codyhylau/Integrated-Design-Project/IDP CADS FINAL/Ball Castor/ball castor.SLDASM

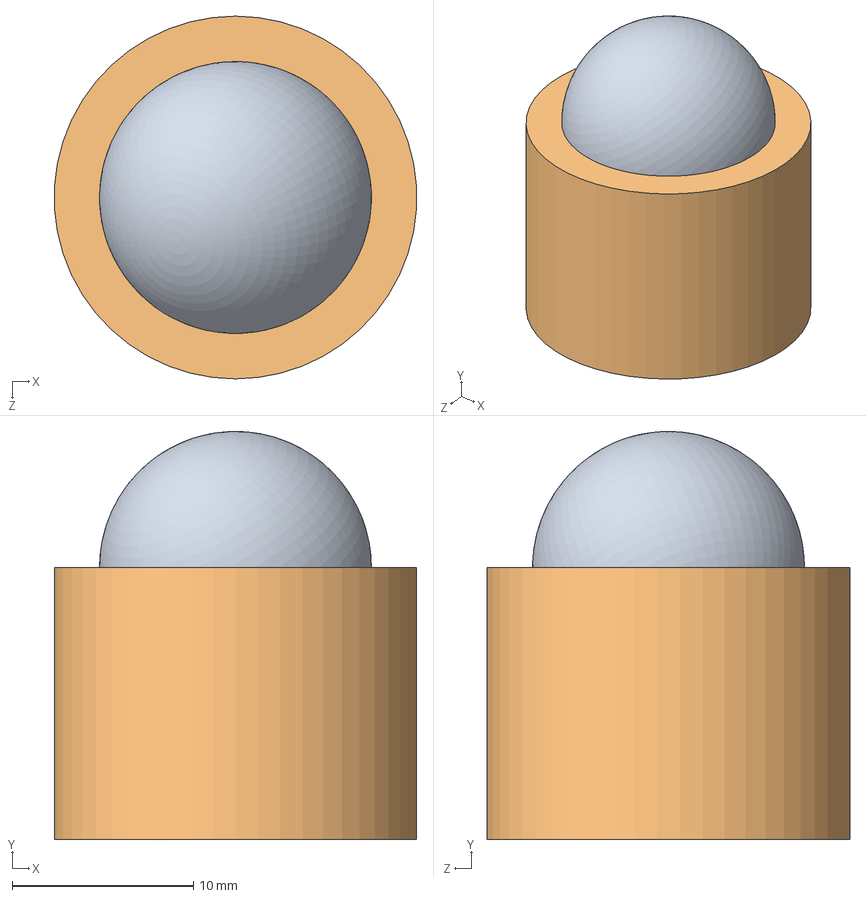
[picture p1: CAD file, 2022-01-01]
IDP CADS FINAL/Ball Castor/ball castor.SLDASM
20.0 x 22.5 x 20.0 mm
ball
ball castor
