codyhylau/Integrated-Design-Project/IDP CADS FINAL/Servo/Servo Assembly.SLDASM

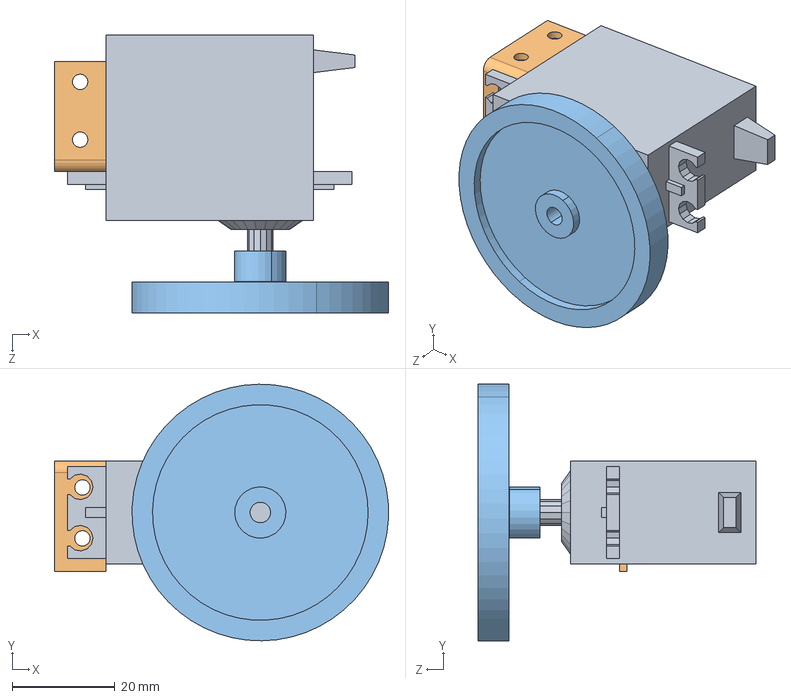
[picture p2: CAD file, 2022-01-01]
IDP CADS FINAL/Servo/Servo Assembly.SLDASM
65.1 x 50.0 x 54.1 mm
Servo
Servo Mount
spur_gear_50
