codyhylau/Integrated-Design-Project/IDP CADS FINAL/wall and ramp/wall assembly right.SLDASM

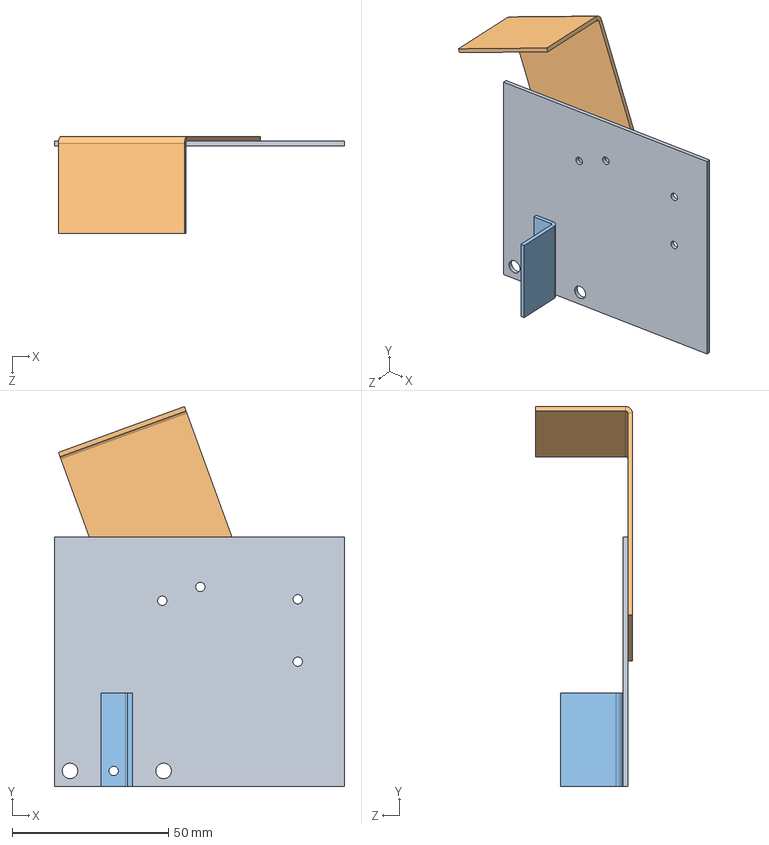
[picture p3: CAD file, 2022-01-01]
IDP CADS FINAL/wall and ramp/wall assembly right.SLDASM
93.0 x 121.8 x 31.1 mm
wall
wall L plate
divider
