codyhylau/Integrated-Design-Project/Models/bearing_625.SLDASM

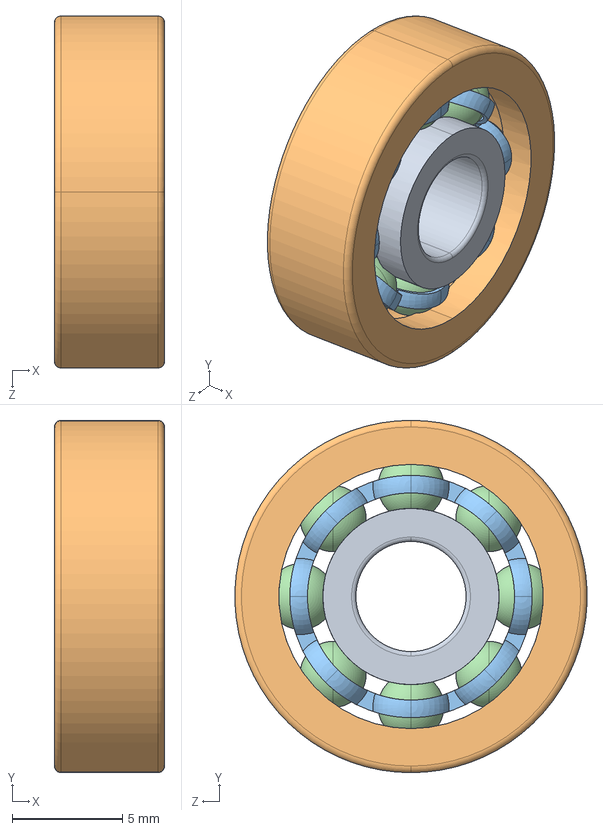
[picture p4: CAD file, 2022-01-01]
Models/bearing_625.SLDASM
5.00 x 16.0 x 16.0 mm
inner_625.prt
outer_625.prt
cage_for_625.prt
ball3.prt x 8
