codyhylau/Integrated-Design-Project/Models/FINAL/100mm_wheel.SLDASM

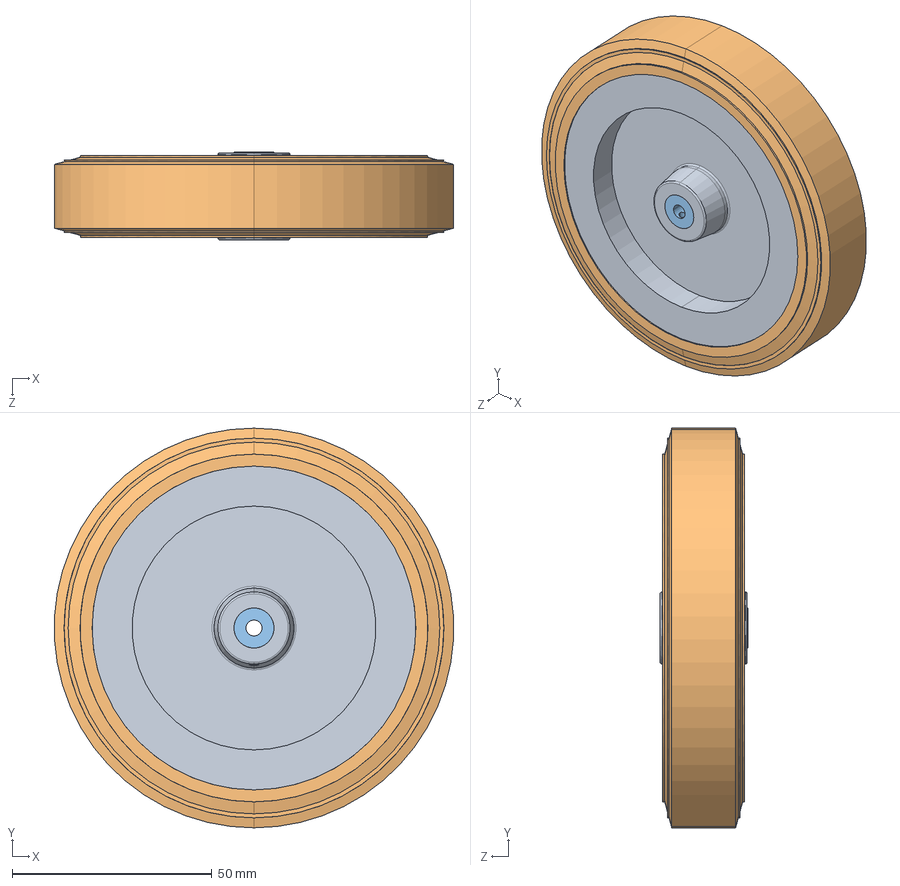
[picture p5: CAD file, 2022-01-01]
Models/FINAL/100mm_wheel.SLDASM
99.8 x 100.0 x 22.0 mm
wheel_back_in.prt
wheel_back_out.prt
sleeve.prt
