codyhylau/Integrated-Design-Project/IDP CADS FINAL/Curve/Curve Assembly.SLDASM

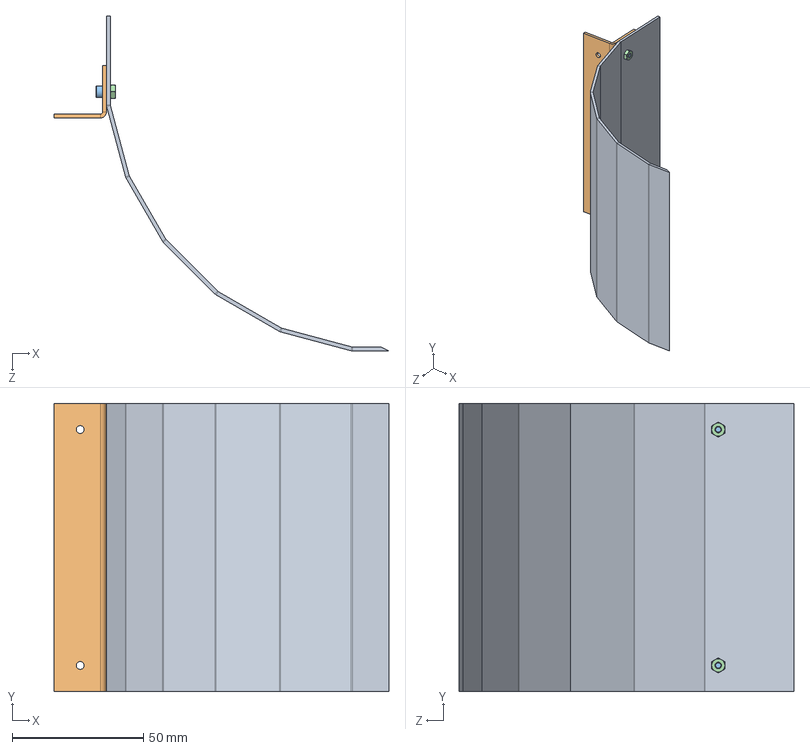
[picture p6: CAD file, 2022-01-01]
IDP CADS FINAL/Curve/Curve Assembly.SLDASM
127.8 x 110.0 x 127.8 mm
Curve
Curve L
socket head cap screw_am x 2
hex nut style 1_am x 2
