codyhylau/Integrated-Design-Project/IDP CADS FINAL/Ultrasonic Sensor/HC-SR04 Ping Sensor.SLDASM

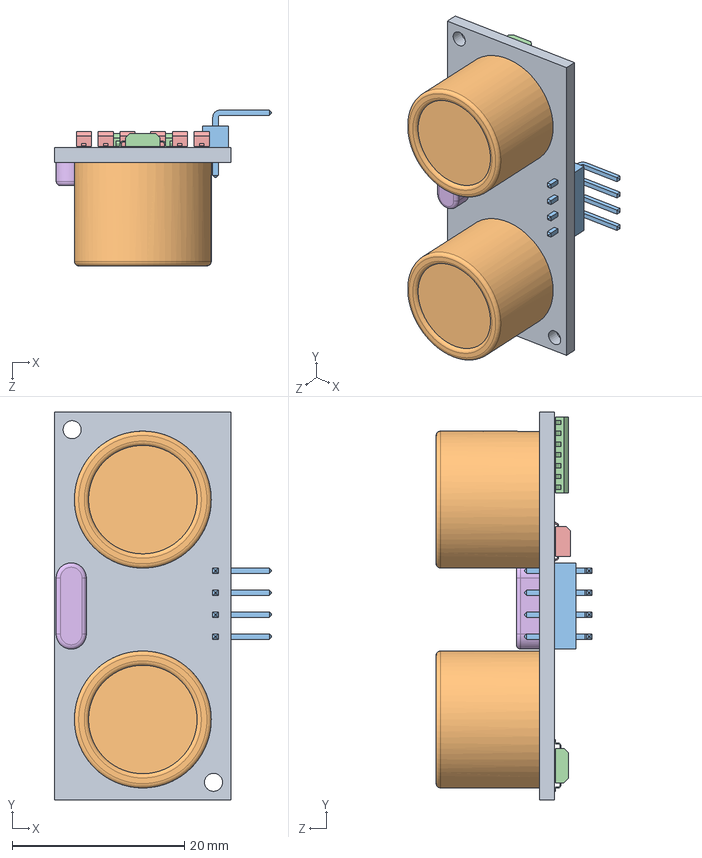
[picture p7: CAD file, 2022-01-01]
IDP CADS FINAL/Ultrasonic Sensor/HC-SR04 Ping Sensor.SLDASM
25.2 x 45.0 x 18.1 mm
PCB
Transducer x 2
3 Pin Header 90 Degree
14 Pin SMT x 3
Cap1 SMT x 6
HC-SR04 Crystal.SLDASM
