codyhylau/Integrated-Design-Project/Models/Sideways/Assembly Chasis.SLDASM

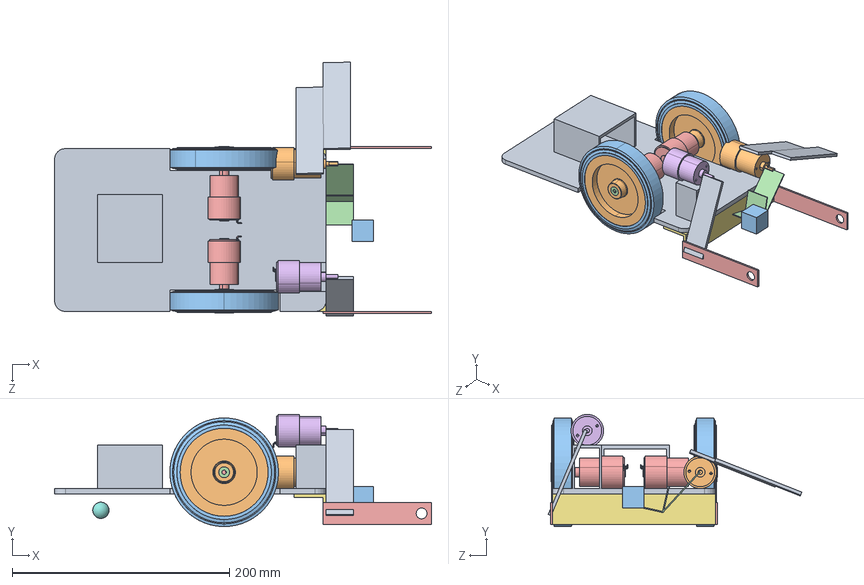
[picture p8: CAD file, 2022-01-01]
Models/Sideways/Assembly Chasis.SLDASM
347.0 x 103.2 x 233.5 mm
chasis
wheel_back_in.prt x 2
wheel_back_out.prt x 2
sleeve.prt x 2
new-motor-40 x 2
new-motor-20
front plate
ball
minesweeper x 3
new-motor-10
mine
blade
infrared wall x 2
