codyhylau/Integrated-Design-Project/IDP CADS FINAL/Arm/arm main plate.SLDPRT

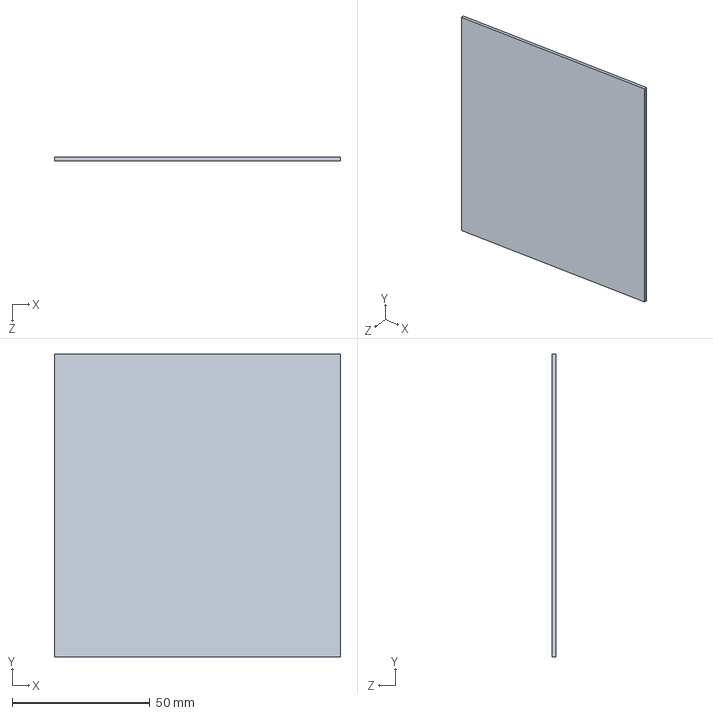
[picture p9: CAD file, 2022-01-01]
IDP CADS FINAL/Arm/arm main plate.SLDPRT
104.0 x 110.0 x 1.50 mm
