codyhylau/Integrated-Design-Project/IDP CADS FINAL/Ultrasonic Sensor Mount Side/Ultronic Sensor Side Assembly.SLDASM

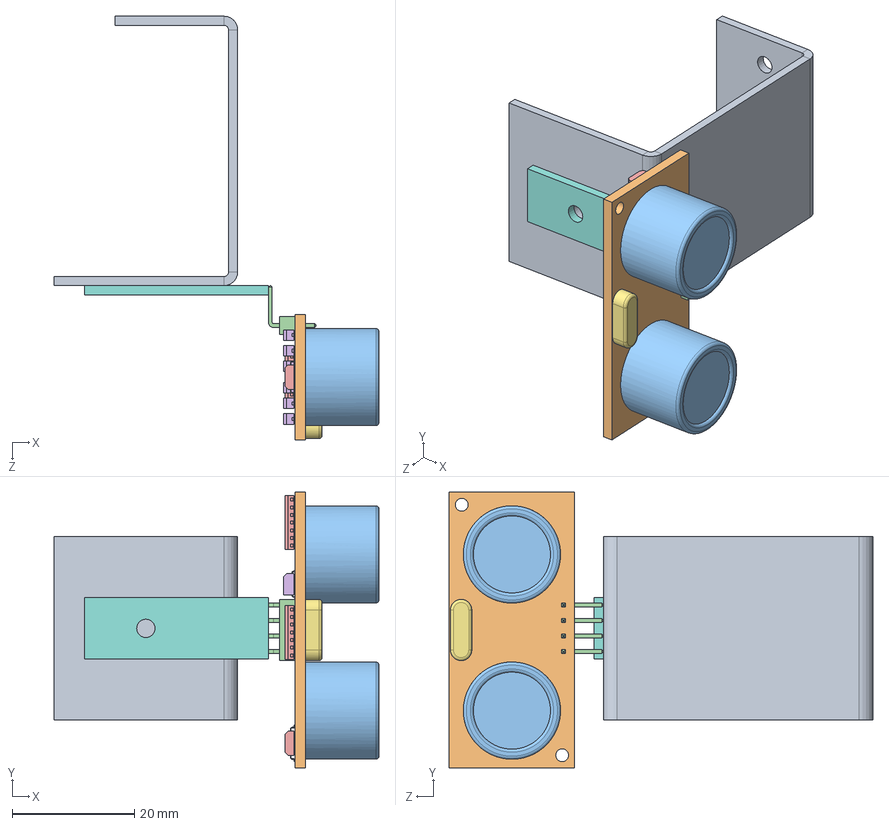
[picture p10: CAD file, 2022-01-01]
IDP CADS FINAL/Ultrasonic Sensor Mount Side/Ultronic Sensor Side Assembly.SLDASM
53.1 x 45.0 x 69.2 mm
Ultrasonic Sensor Mount Side
PCB
Transducer x 2
3 Pin Header 90 Degree
14 Pin SMT x 3
Cap1 SMT x 6
HC-SR04 Crystal.SLDASM
US connecting board
