codyhylau/Integrated-Design-Project/Models/castor.SLDASM

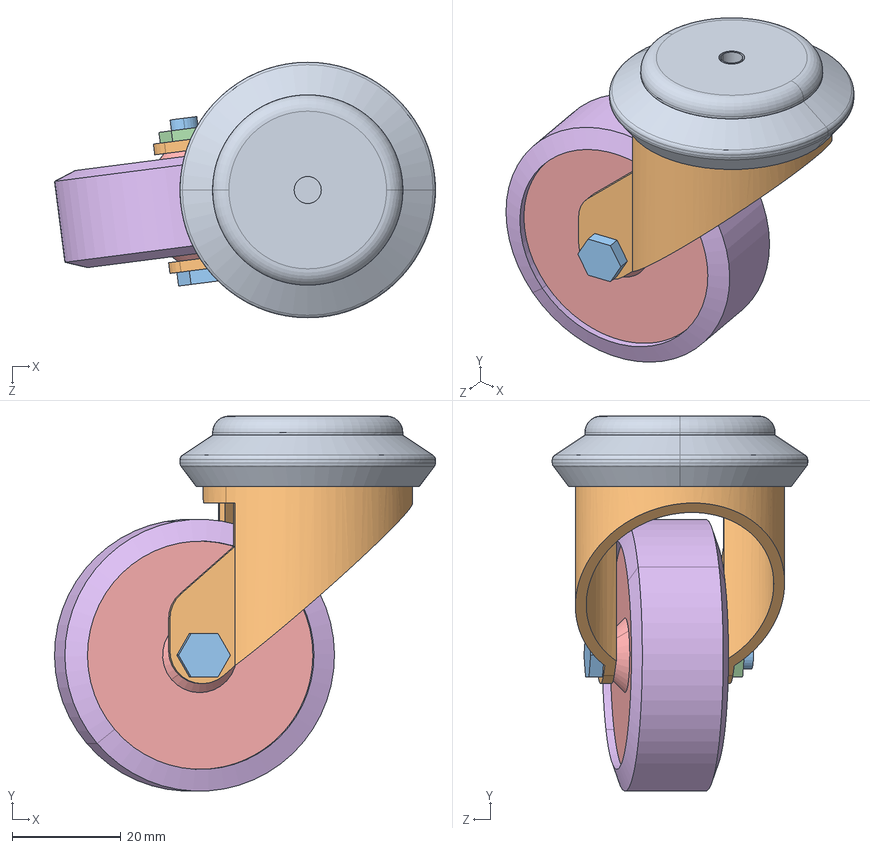
[picture p11: CAD file, 2022-01-01]
Models/castor.SLDASM
70.1 x 69.0 x 47.0 mm
wheel_top.prt
wheel_body.prt
wheel_bolt.prt
wheel_nut1.prt
wheel_in.prt
cast_in.prt
