codyhylau/Integrated-Design-Project/Models/Forward/Chassis forward.SLDASM

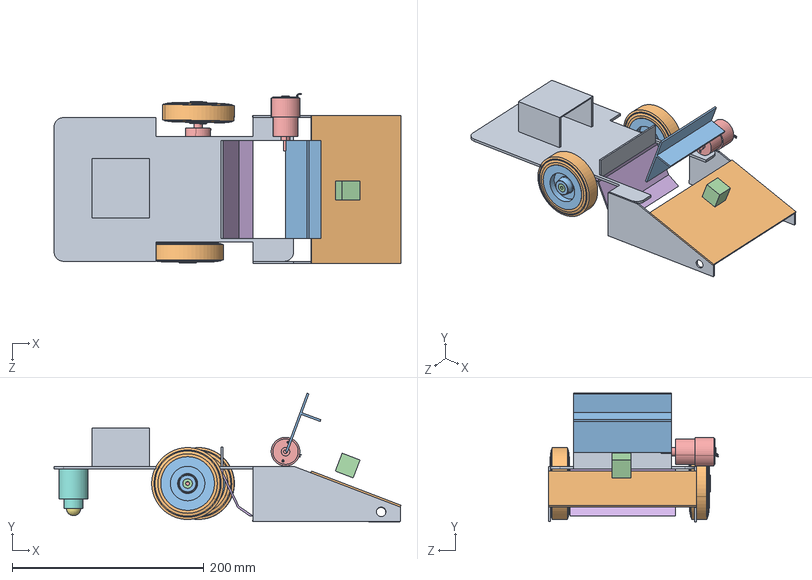
[picture p12: CAD file, 2022-01-01]
Models/Forward/Chassis forward.SLDASM
361.8 x 134.2 x 176.9 mm
chasis - Copy
wheel_75_tyre.prt x 2
wheel_75_inner.prt x 2
sleeve.prt x 2
new-motor-40 x 3
front plate 2
ball
ball castor
side plate x 2
infrared wall 2
blade 2
mine
