codyhylau/Integrated-Design-Project/IDP CADS FINAL/Ultrasonic Sensor Mount Back/Ultrasonic Sensor Mount Back Assembly.SLDASM

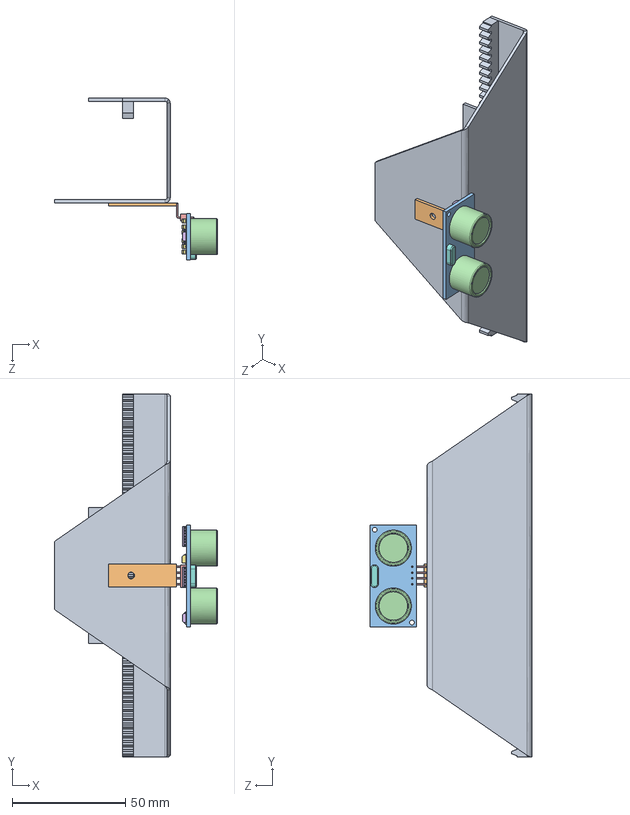
[picture p13: CAD file, 2022-01-01]
IDP CADS FINAL/Ultrasonic Sensor Mount Back/Ultrasonic Sensor Mount Back Assembly.SLDASM
71.9 x 160.0 x 71.3 mm
Ultrasonic Sensor Mount Back
US connecting board
PCB
Transducer x 2
3 Pin Header 90 Degree
14 Pin SMT x 3
Cap1 SMT x 6
HC-SR04 Crystal.SLDASM
Gear Rack
