codyhylau/Integrated-Design-Project/Models/new-drive-assy-75.SLDASM

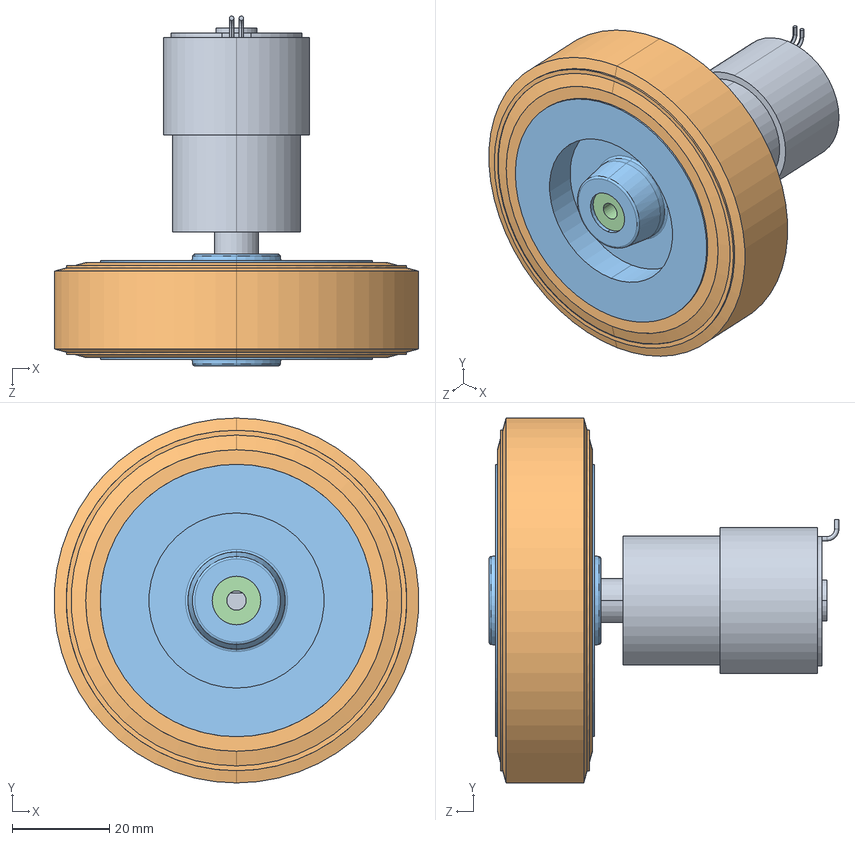
[picture p14: CAD file, 2022-01-01]
Models/new-drive-assy-75.SLDASM
74.9 x 75.0 x 71.9 mm
new-motor-20.prt
wheel_75_tyre.prt
wheel_75_inner.prt
sleeve.prt
