codyhylau/Integrated-Design-Project/IDP CADS FINAL/Arm/arm assembly.SLDASM

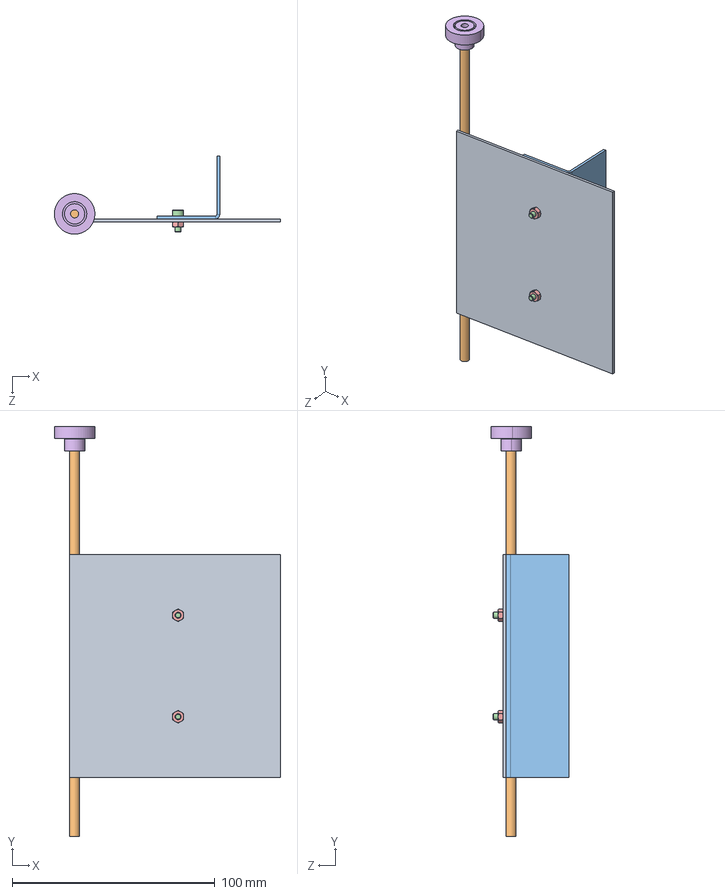
[picture p15: CAD file, 2022-01-01]
IDP CADS FINAL/Arm/arm assembly.SLDASM
111.5 x 202.0 x 38.6 mm
arm main plate
arm axle
arm L plate
socket head cap screw_am x 2
hex nut style 1_am x 2
spur_gear_20
