codyhylau/Integrated-Design-Project/IDP CADS FINAL/Ultrasonic Sensor/HC-SR04 Crystal.SLDASM.SLDPRT

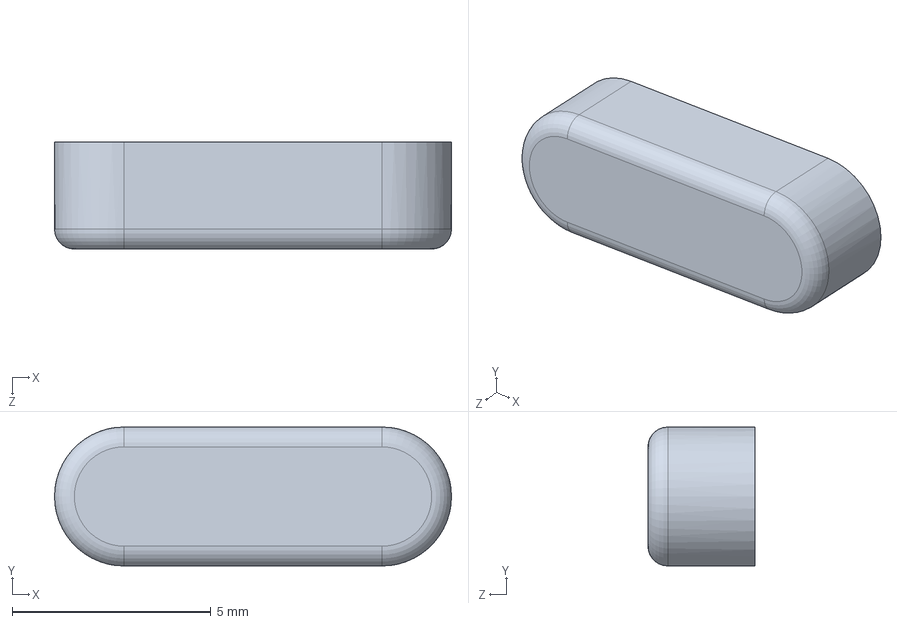
[picture p16: CAD file, 2022-01-01]
IDP CADS FINAL/Ultrasonic Sensor/HC-SR04 Crystal.SLDASM.SLDPRT
10.0 x 3.50 x 2.70 mm
