codyhylau/Integrated-Design-Project/Models/Forward/ball castor 2.SLDASM

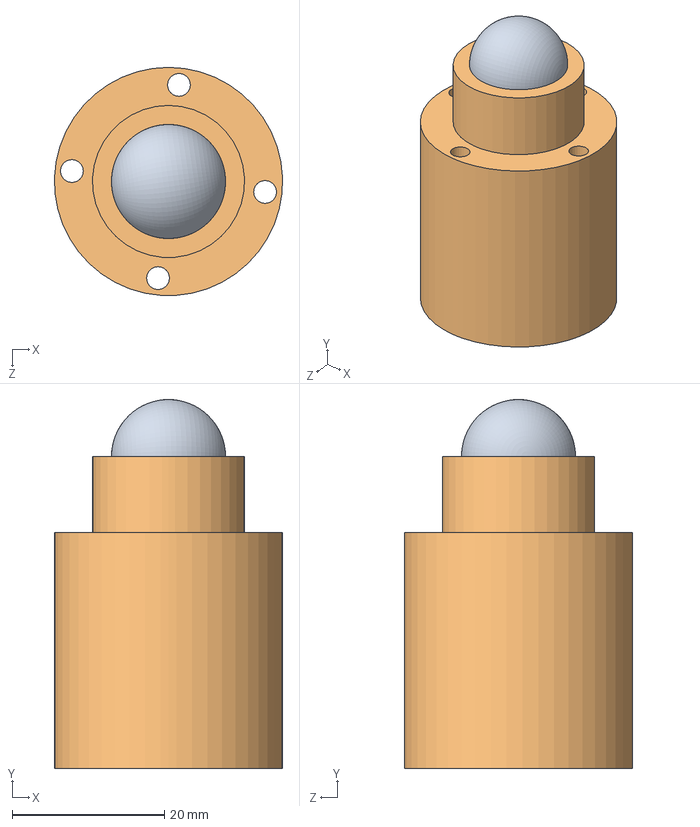
[picture p17: CAD file, 2022-01-01]
Models/Forward/ball castor 2.SLDASM
30.0 x 48.5 x 30.0 mm
ball
ball castor
