codyhylau/Integrated-Design-Project/Models/Sideways/ball castor.SLDASM

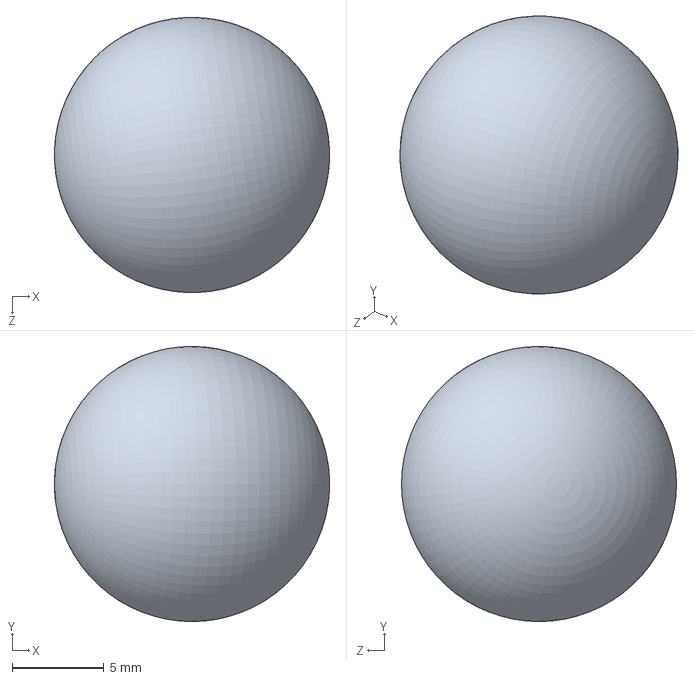
[picture p18: CAD file, 2022-01-01]
Models/Sideways/ball castor.SLDASM
15.0 x 15.0 x 15.0 mm
