codyhylau/Integrated-Design-Project/IDP CADS FINAL/OVERALL ASSEMBLY.SLDASM

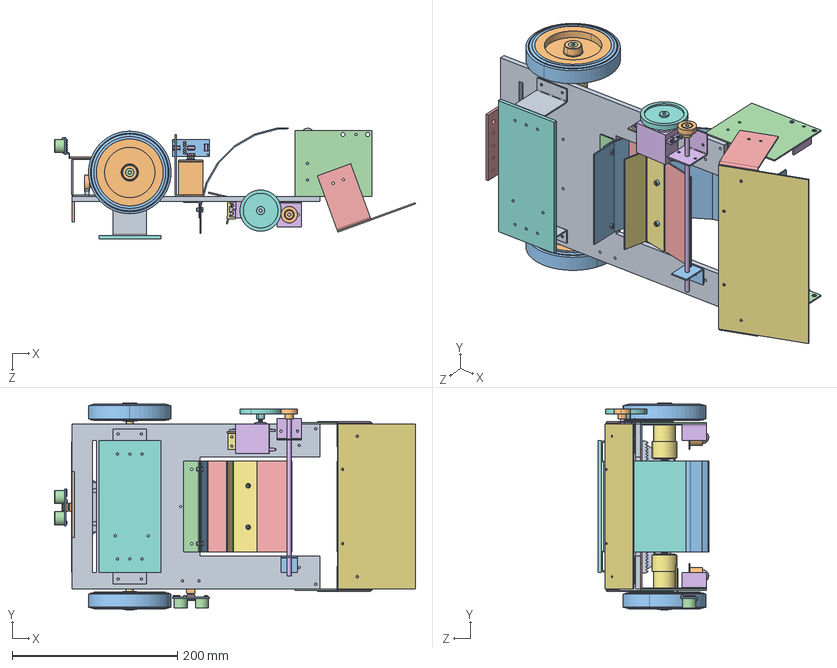
[picture p19: CAD file, 2022-01-01]
IDP CADS FINAL/OVERALL ASSEMBLY.SLDASM
436.9 x 250.0 x 134.4 mm
Chassis Main
Ball Castor Mount Left
Ball Castor Mount Right
Line Follower mount
Motor Mount Large x 2
Motor Mount Small x 2
Motor-40 x 2
shelf laser cut
Shelf mount x 2
wheel_back_in.prt x 2
wheel_back_out.prt x 2
sleeve.prt x 2
arm main plate
arm axle
arm L plate
socket head cap screw_am x 4
hex nut style 1_am x 4
spur_gear_20 x 2
Curve
Curve L
LED Panel
Servo
Servo Mount
spur_gear_50
Ultrasonic Sensor Mount Back
US connecting board x 2
PCB x 2
Transducer x 4
3 Pin Header 90 Degree x 2
14 Pin SMT x 6
Cap1 SMT x 12
HC-SR04 Crystal.SLDASM x 2
Gear Rack
Ultrasonic Sensor Mount Side
Arm rod support
wall x 2
wall L plate x 2
divider x 2
ramp
Hall Sensor Mount
ball x 2
ball castor x 2
Motor-10
