codyhylau/Integrated-Design-Project/Models/bearing_623.SLDASM

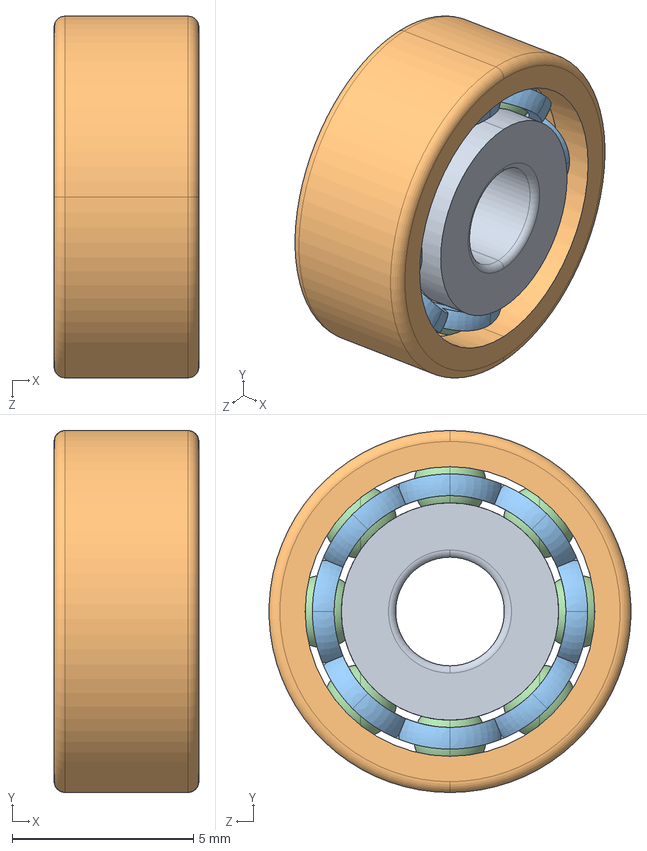
[picture p20: CAD file, 2022-01-01]
Models/bearing_623.SLDASM
4.00 x 10.0 x 9.99 mm
inner_623.prt
outer_623.prt
cage_for_623.prt
ball2.prt x 8
