codyhylau/Integrated-Design-Project/IDP CADS FINAL/Chassis Main.SLDPRT

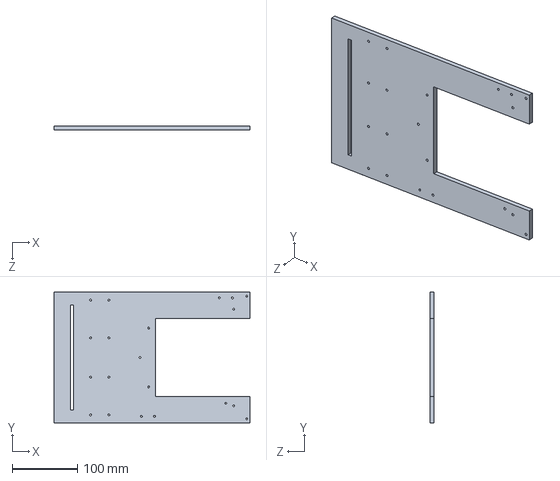
[picture p21: CAD file, 2022-01-01]
IDP CADS FINAL/Chassis Main.SLDPRT
300.0 x 200.0 x 6.00 mm
