codyhylau/Integrated-Design-Project/Models/mitre_pair_20t.asm.SLDASM

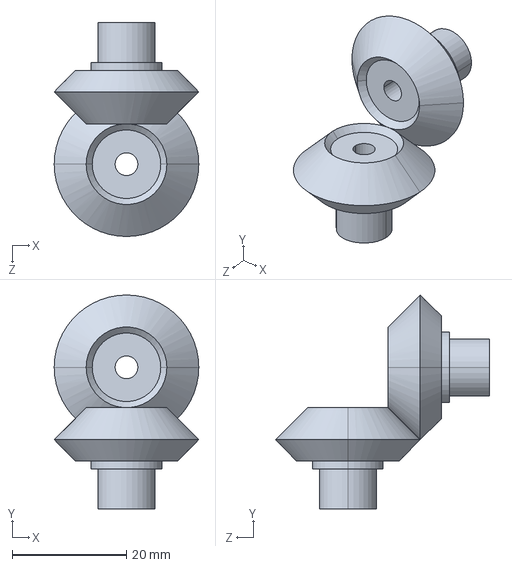
[picture p22: CAD file, 2022-01-01]
Models/mitre_pair_20t.asm.SLDASM
25.3 x 37.5 x 37.5 mm
mitre_m1_20t.prt x 2
