codyhylau/Integrated-Design-Project/Models/624-flanged.SLDASM

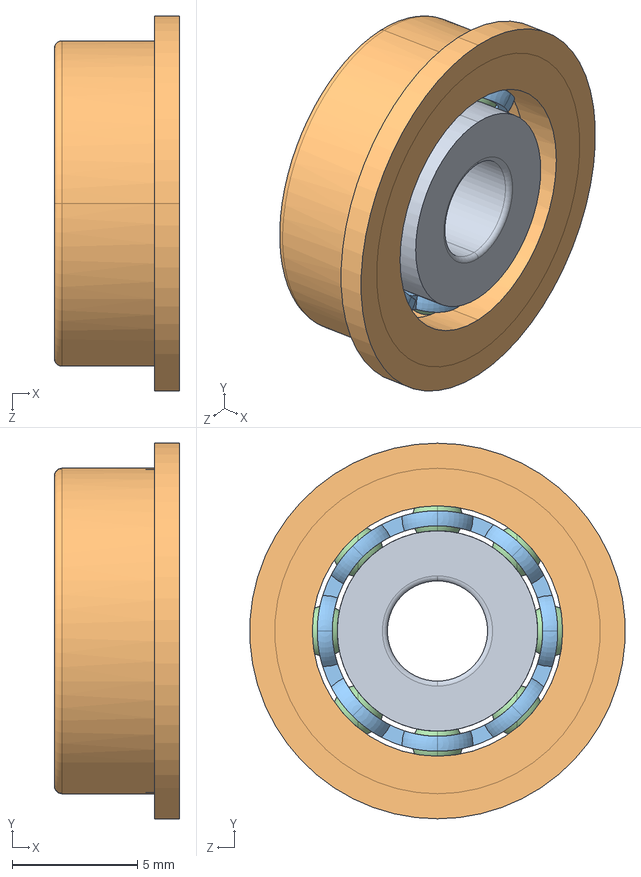
[picture p23: CAD file, 2022-01-01]
Models/624-flanged.SLDASM
5.00 x 15.0 x 15.0 mm
inner_624.prt
flanged-outer-624.prt
cage_for_624.prt
ball2.prt x 8
