codyhylau/Integrated-Design-Project/Models/75mm_wheel.SLDASM

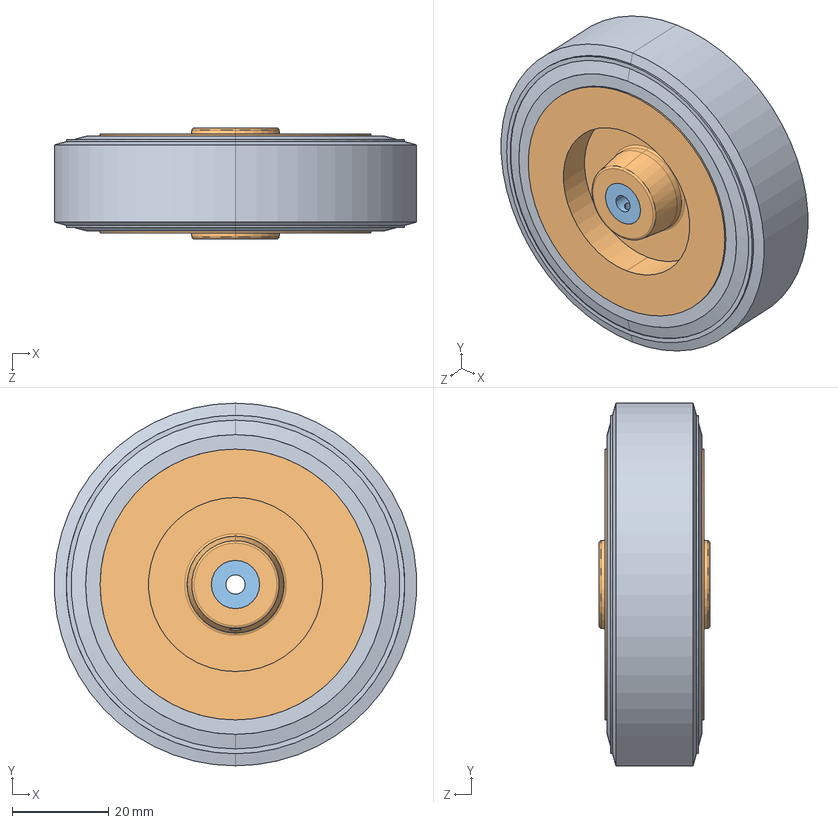
[picture p24: CAD file, 2022-01-01]
Models/75mm_wheel.SLDASM
74.9 x 75.0 x 23.0 mm
wheel_75_tyre.prt
wheel_75_inner.prt
sleeve.prt
