codyhylau/Integrated-Design-Project/Models/623-flanged.SLDASM

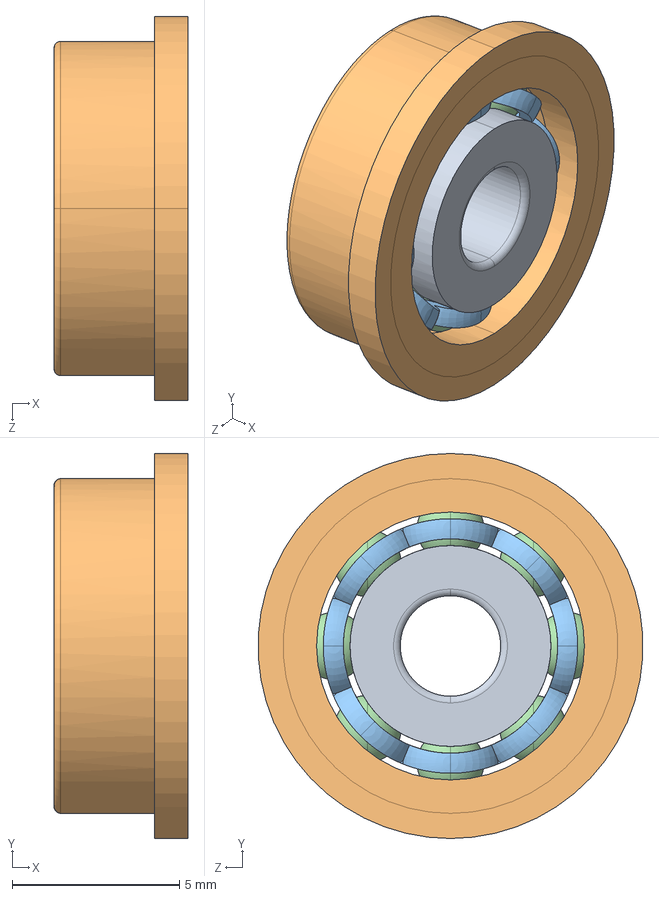
[picture p25: CAD file, 2022-01-01]
Models/623-flanged.SLDASM
4.00 x 11.5 x 11.5 mm
inner_623.prt
flanged-outer-623.prt
cage_for_623.prt
ball2.prt x 8
