codyhylau/Integrated-Design-Project/Models/625-flanged.SLDASM

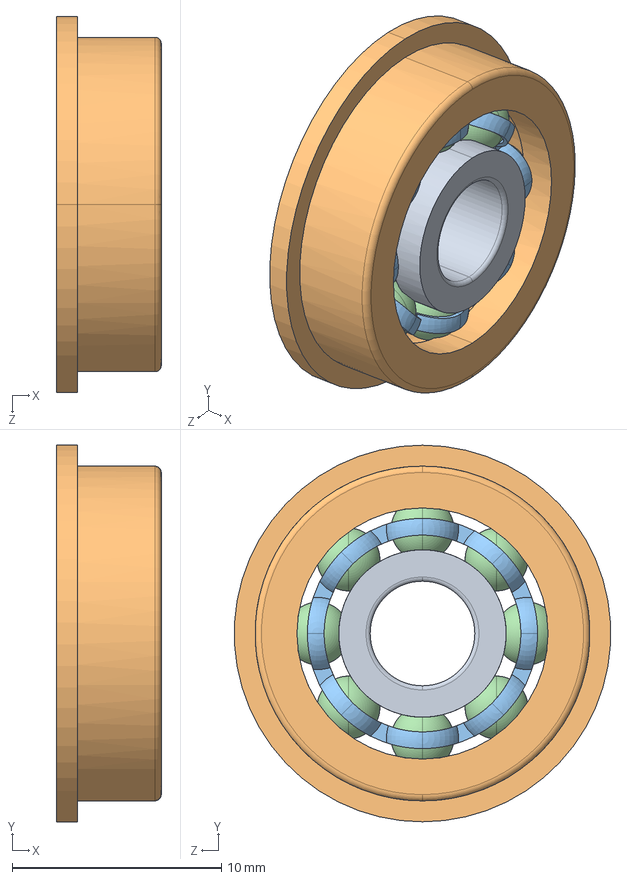
[picture p26: CAD file, 2022-01-01]
Models/625-flanged.SLDASM
5.00 x 18.0 x 18.0 mm
inner_625.prt
flanged-outer-625.prt
cage_for_625.prt
ball3.prt x 8
