codyhylau/Integrated-Design-Project/Models/bearing_624.SLDASM

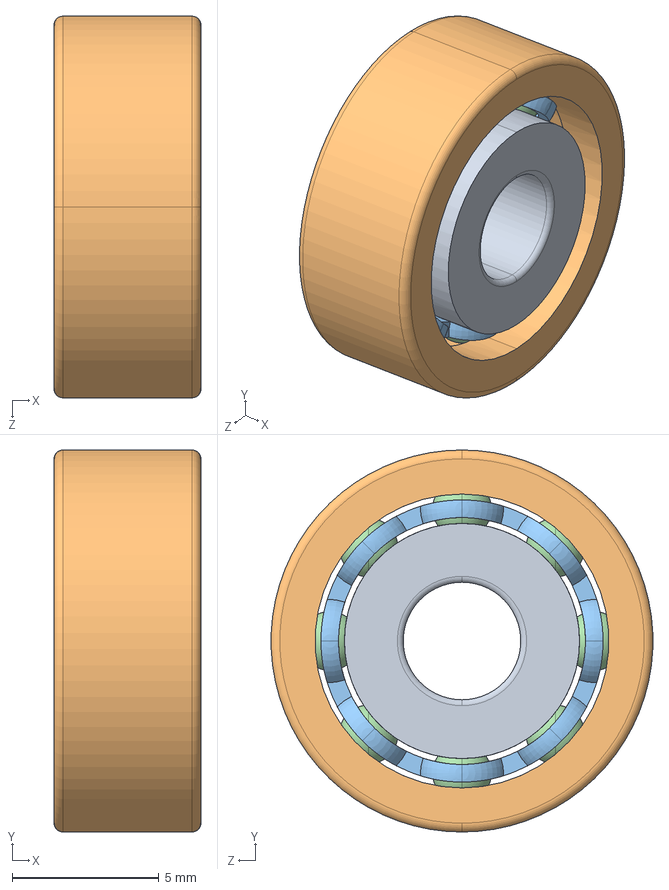
[picture p27: CAD file, 2022-01-01]
Models/bearing_624.SLDASM
5.00 x 13.0 x 13.0 mm
inner_624.prt
outer_624.prt
cage_for_624.prt
ball2.prt x 8
