codyhylau/Integrated-Design-Project/IDP CADS FINAL/Arm/Arm rod support.SLDPRT

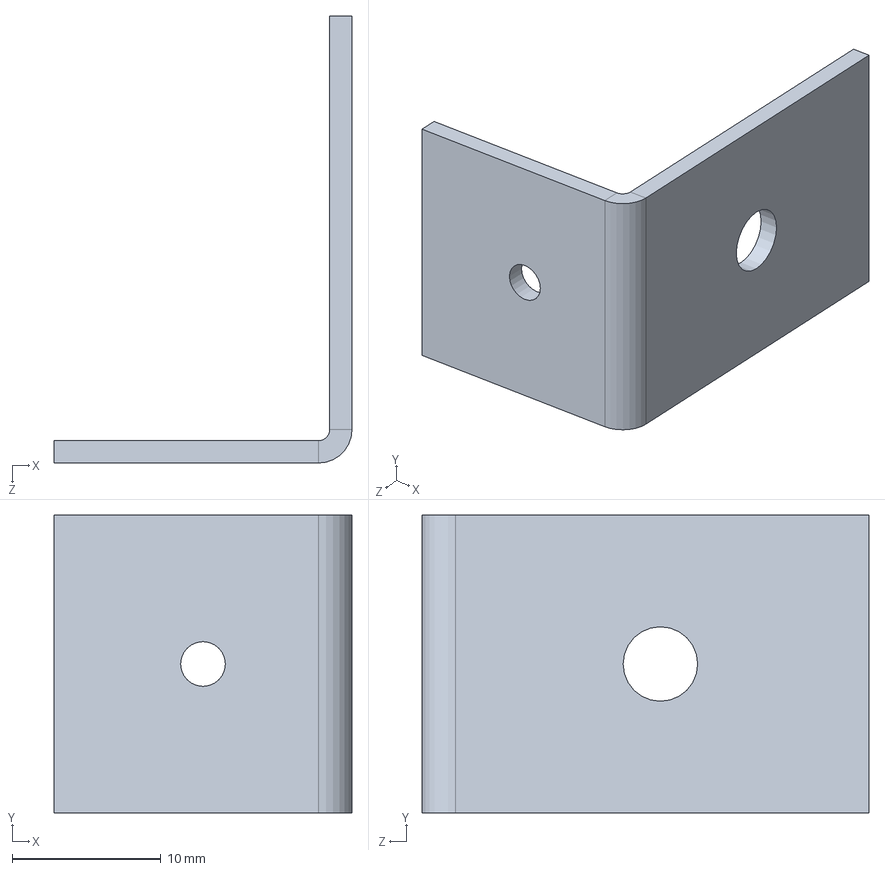
[picture p28: CAD file, 2022-01-01]
IDP CADS FINAL/Arm/Arm rod support.SLDPRT
20.0 x 20.0 x 30.0 mm
