codyhylau/Integrated-Design-Project/IDP CADS FINAL/Curve/Curve L.SLDPRT

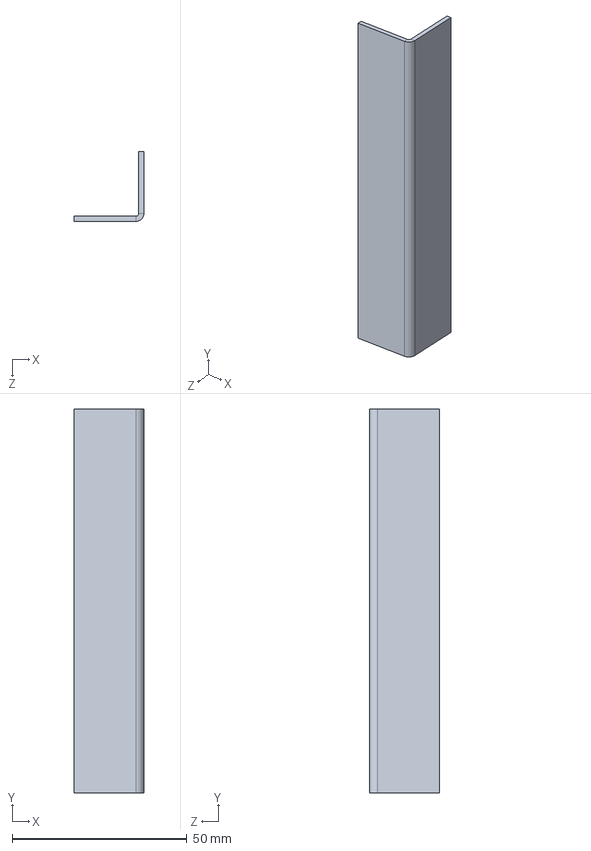
[picture p29: CAD file, 2022-01-01]
IDP CADS FINAL/Curve/Curve L.SLDPRT
20.0 x 110.0 x 20.0 mm
