codyhylau/Integrated-Design-Project/IDP CADS FINAL/Drawings temporary/Laser Cut Chassis.DXF

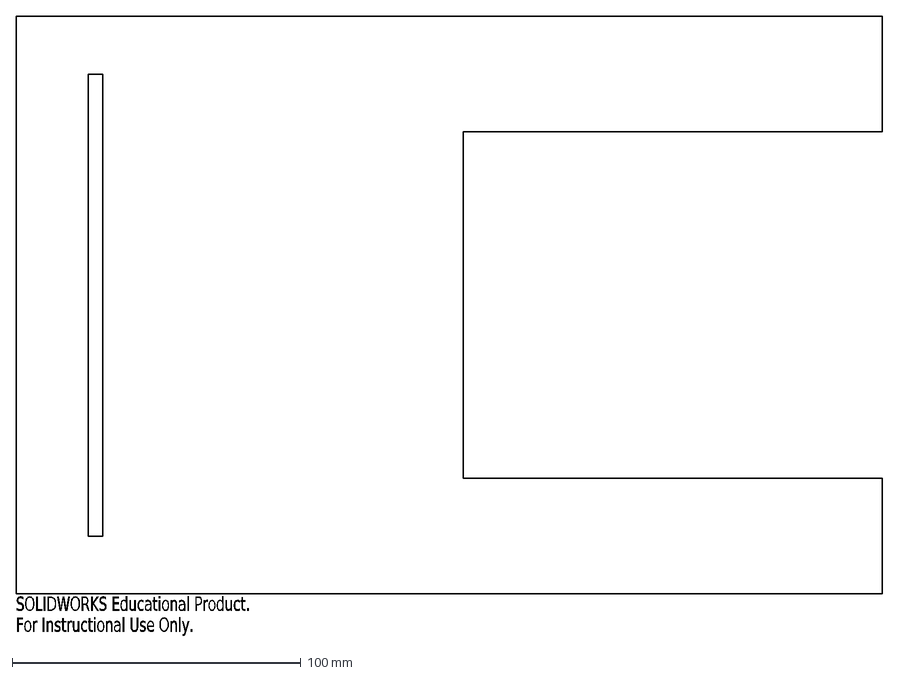
[picture p30: CAD file, 2022-01-01]
IDP CADS FINAL/Drawings temporary/Laser Cut Chassis.DXF
SOLIDWORKS Educational Product.
For Instructional Use Only.
