codyhylau/Integrated-Design-Project/IDP CADS FINAL/LED Panel/LED Panel.SLDPRT

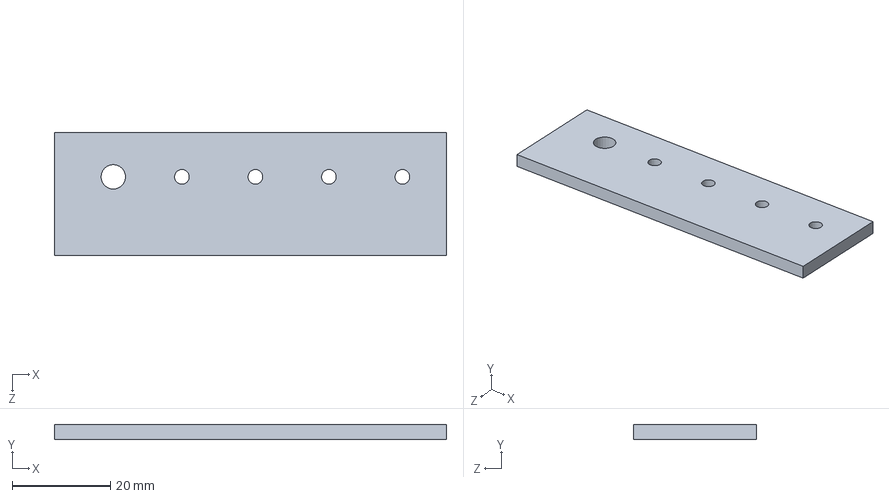
[picture p31: CAD file, 2022-01-01]
IDP CADS FINAL/LED Panel/LED Panel.SLDPRT
80.0 x 3.00 x 25.0 mm
