codyhylau/Integrated-Design-Project/IDP CADS FINAL/Motor-40.SLDPRT

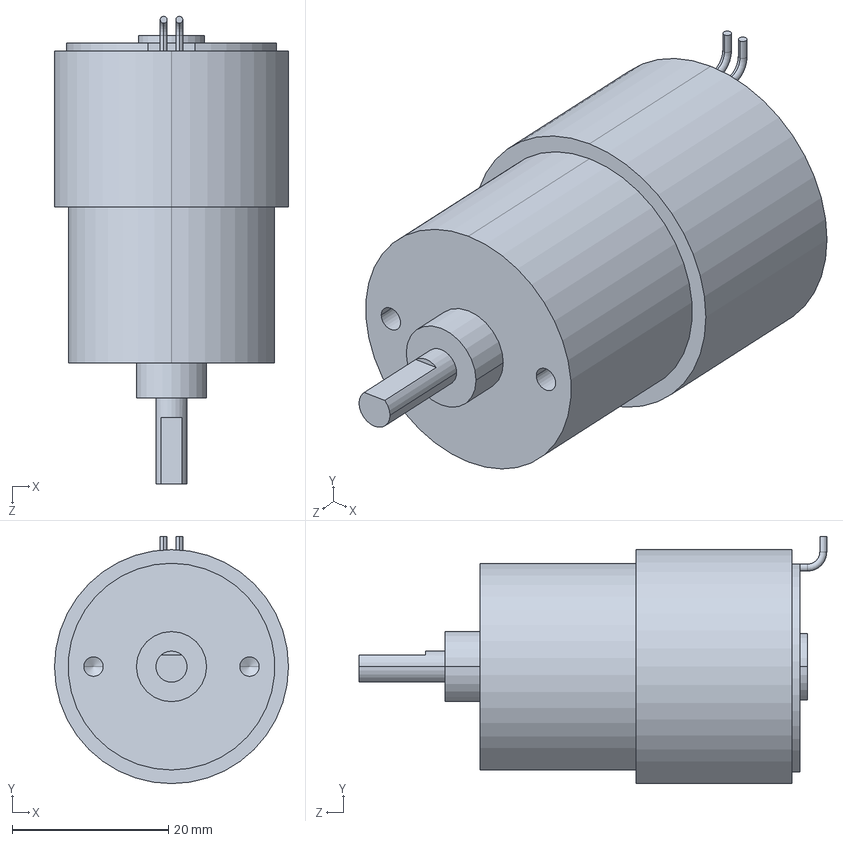
[picture p32: CAD file, 2022-01-01]
IDP CADS FINAL/Motor-40.SLDPRT
30.0 x 31.7 x 60.0 mm
