codyhylau/Integrated-Design-Project/IDP CADS FINAL/Ultrasonic Sensor Mount Back/Ultrasonic Sensor Mount Back.SLDPRT

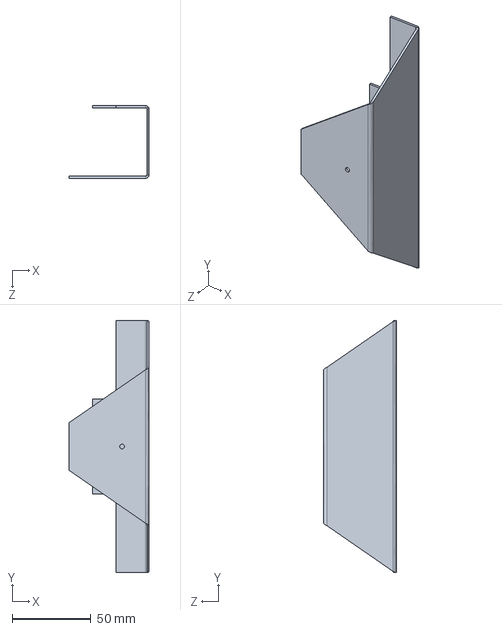
[picture p33: CAD file, 2022-01-01]
IDP CADS FINAL/Ultrasonic Sensor Mount Back/Ultrasonic Sensor Mount Back.SLDPRT
51.1 x 160.0 x 46.1 mm
