codyhylau/Integrated-Design-Project/IDP CADS FINAL/Ultrasonic Sensor Mount Side/US connecting board.SLDPRT

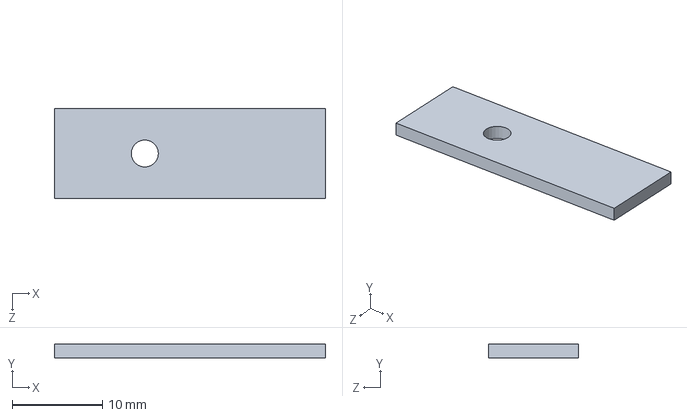
[picture p34: CAD file, 2022-01-01]
IDP CADS FINAL/Ultrasonic Sensor Mount Side/US connecting board.SLDPRT
30.0 x 1.50 x 10.0 mm
