codyhylau/Integrated-Design-Project/IDP CADS FINAL/Ultrasonic Sensor/14 Pin SMT.SLDPRT

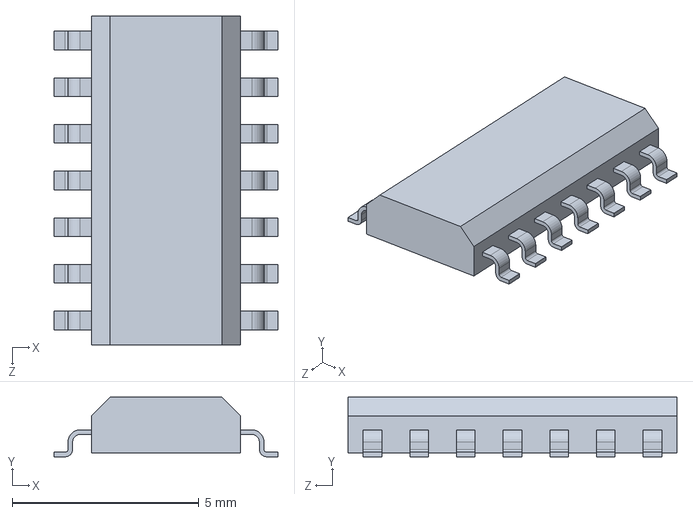
[picture p35: CAD file, 2022-01-01]
IDP CADS FINAL/Ultrasonic Sensor/14 Pin SMT.SLDPRT
6.00 x 1.60 x 8.80 mm
