codyhylau/Integrated-Design-Project/Models/Forward/infrared wall 2.SLDPRT

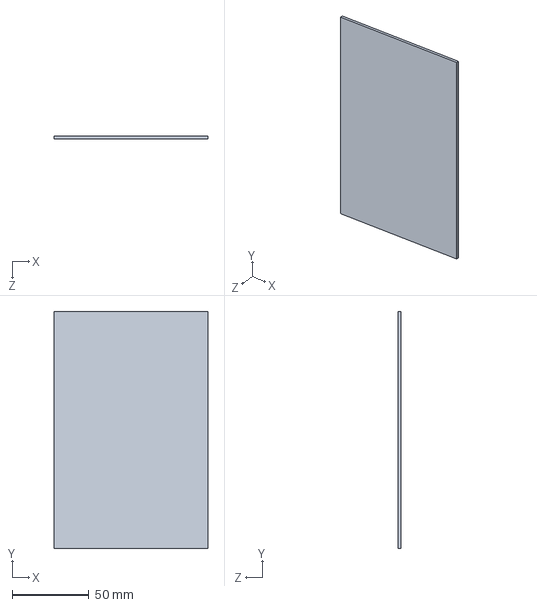
[picture p36: CAD file, 2022-01-01]
Models/Forward/infrared wall 2.SLDPRT
100.0 x 154.0 x 2.00 mm
