codyhylau/Integrated-Design-Project/Models/Sideways/front plate.SLDPRT

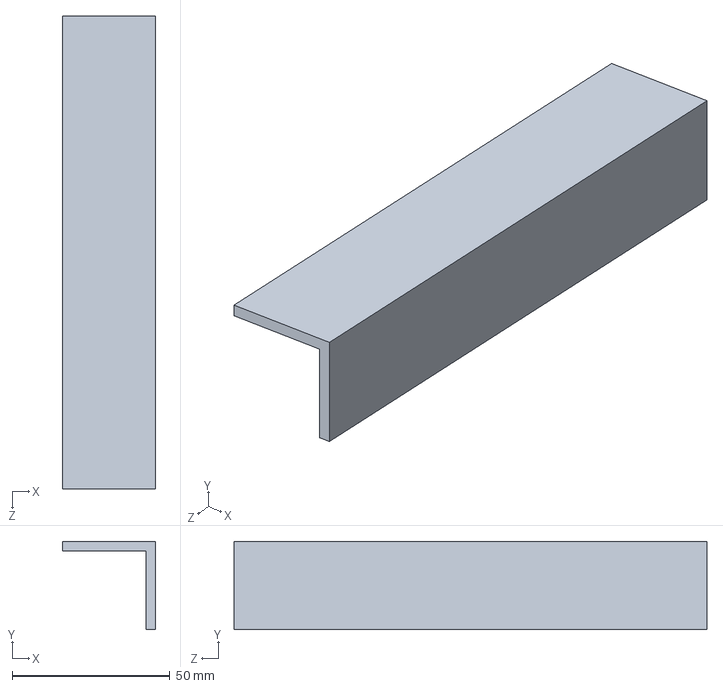
[picture p37: CAD file, 2022-01-01]
Models/Sideways/front plate.SLDPRT
29.6 x 28.0 x 150.0 mm
