codyhylau/Integrated-Design-Project/IDP CADS FINAL/Arm/spur_gear_20.SLDPRT

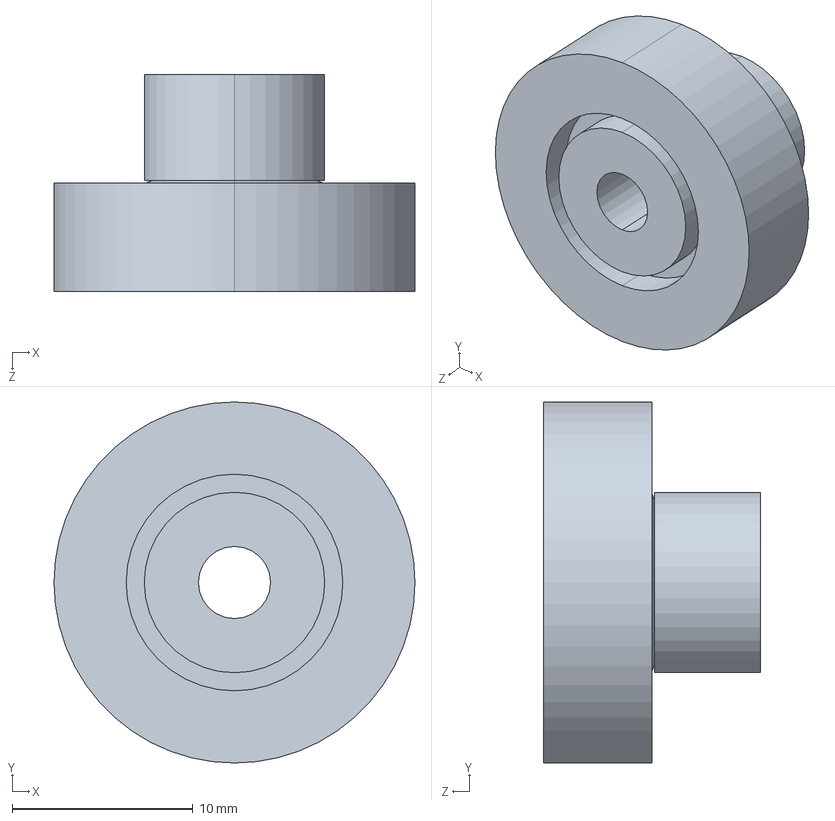
[picture p38: CAD file, 2022-01-01]
IDP CADS FINAL/Arm/spur_gear_20.SLDPRT
20.0 x 20.0 x 12.0 mm
