codyhylau/Integrated-Design-Project/IDP CADS FINAL/Servo/Servo Mount.SLDPRT

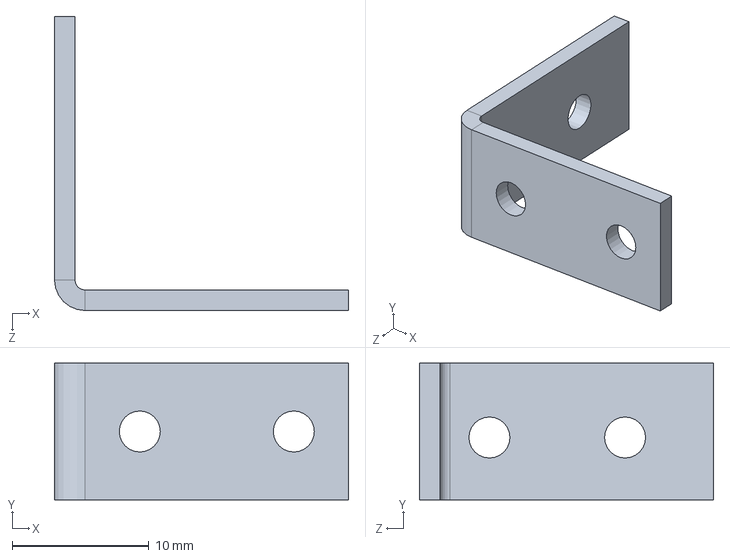
[picture p39: CAD file, 2022-01-01]
IDP CADS FINAL/Servo/Servo Mount.SLDPRT
21.5 x 10.0 x 21.5 mm
