codyhylau/Integrated-Design-Project/IDP CADS FINAL/Shelf mount.SLDPRT

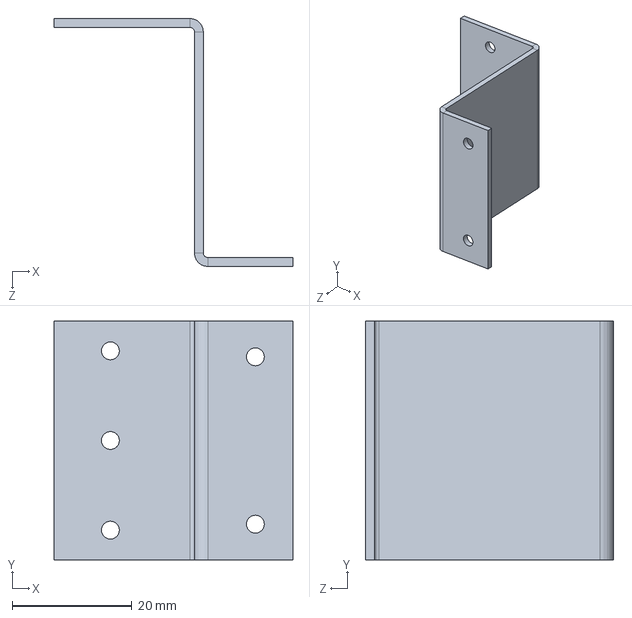
[picture p40: CAD file, 2022-01-01]
IDP CADS FINAL/Shelf mount.SLDPRT
40.0 x 40.0 x 41.5 mm
