codyhylau/Integrated-Design-Project/IDP CADS FINAL/Ultrasonic Sensor Mount Back/Gear Rack.SLDPRT

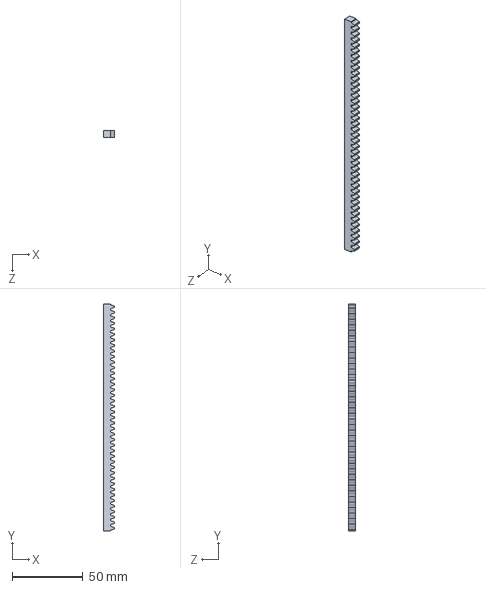
[picture p41: CAD file, 2022-01-01]
IDP CADS FINAL/Ultrasonic Sensor Mount Back/Gear Rack.SLDPRT
7.48 x 160.0 x 4.88 mm
