codyhylau/Integrated-Design-Project/IDP CADS FINAL/Ultrasonic Sensor Mount Side/Ultrasonic Sensor Mount Side.SLDPRT

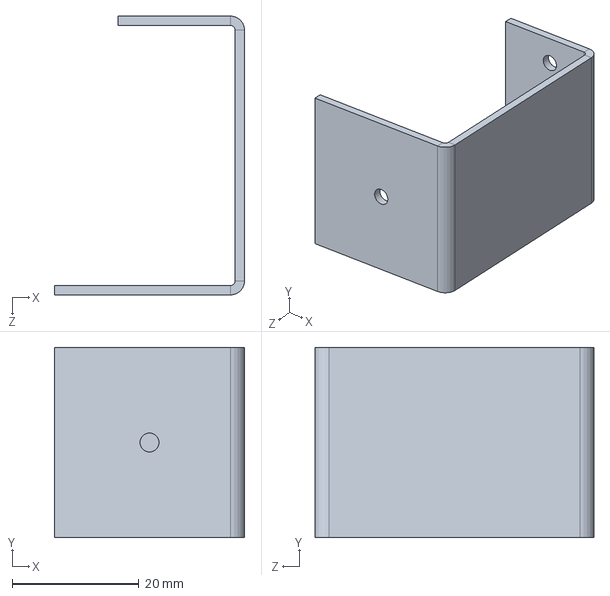
[picture p42: CAD file, 2022-01-01]
IDP CADS FINAL/Ultrasonic Sensor Mount Side/Ultrasonic Sensor Mount Side.SLDPRT
30.0 x 30.0 x 44.0 mm
