codyhylau/Integrated-Design-Project/IDP CADS FINAL/wall and ramp/wall L plate.SLDPRT

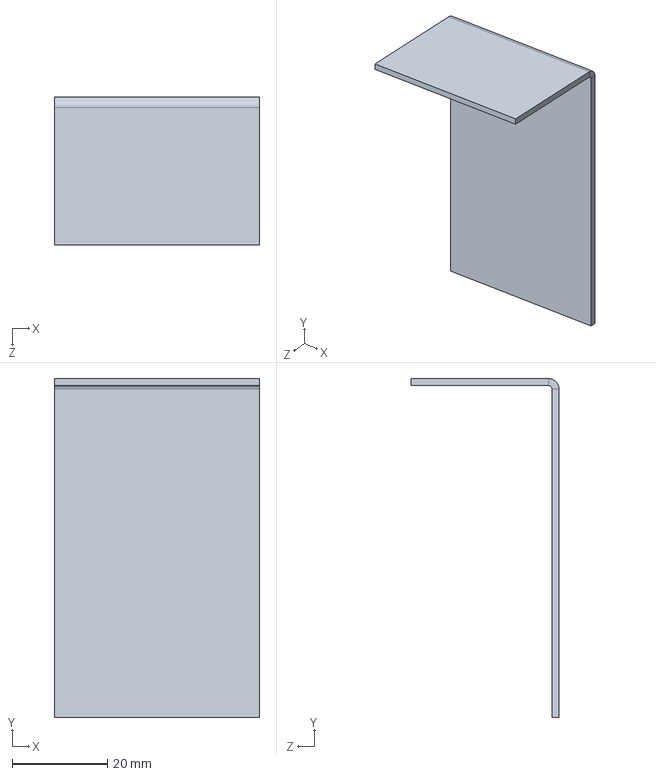
[picture p43: CAD file, 2022-01-01]
IDP CADS FINAL/wall and ramp/wall L plate.SLDPRT
43.0 x 71.1 x 31.1 mm
