codyhylau/Integrated-Design-Project/Models/FINAL/HC-SR04 Ping Sensor/Transducer.SLDPRT

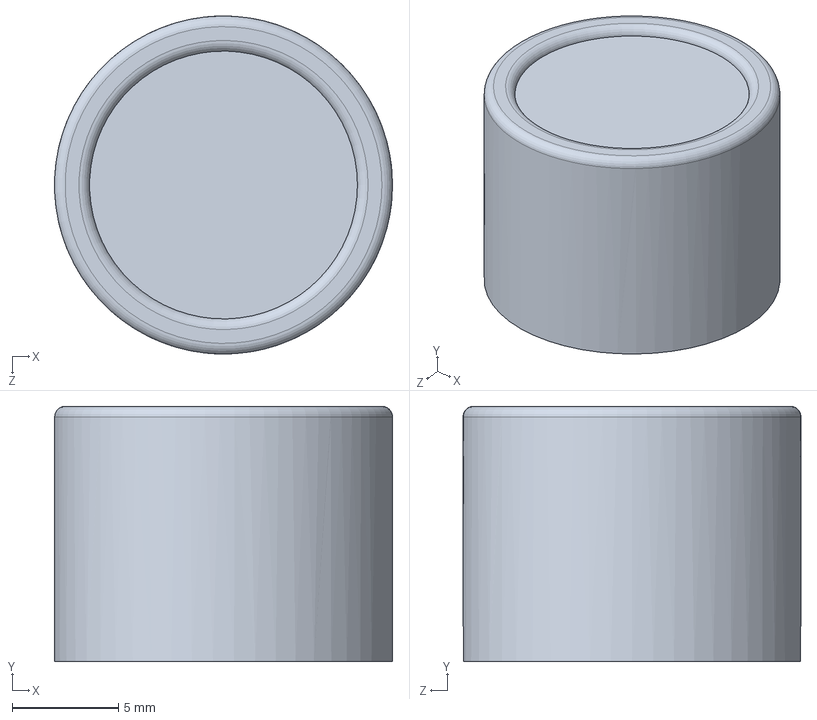
[picture p44: CAD file, 2022-01-01]
Models/FINAL/HC-SR04 Ping Sensor/Transducer.SLDPRT
15.9 x 12.0 x 15.9 mm
