codyhylau/Integrated-Design-Project/Models/FINAL/new-motor-10.SLDPRT

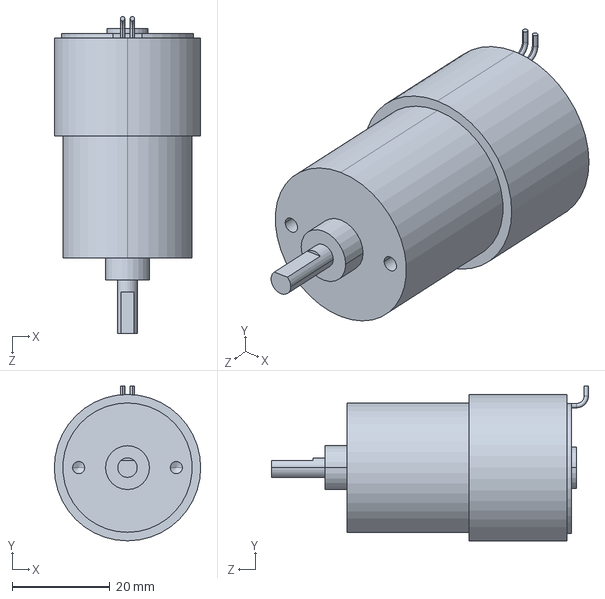
[picture p45: CAD file, 2022-01-01]
Models/FINAL/new-motor-10.SLDPRT
30.0 x 31.7 x 64.9 mm
