codyhylau/Integrated-Design-Project/Models/Forward/blade 2.SLDPRT

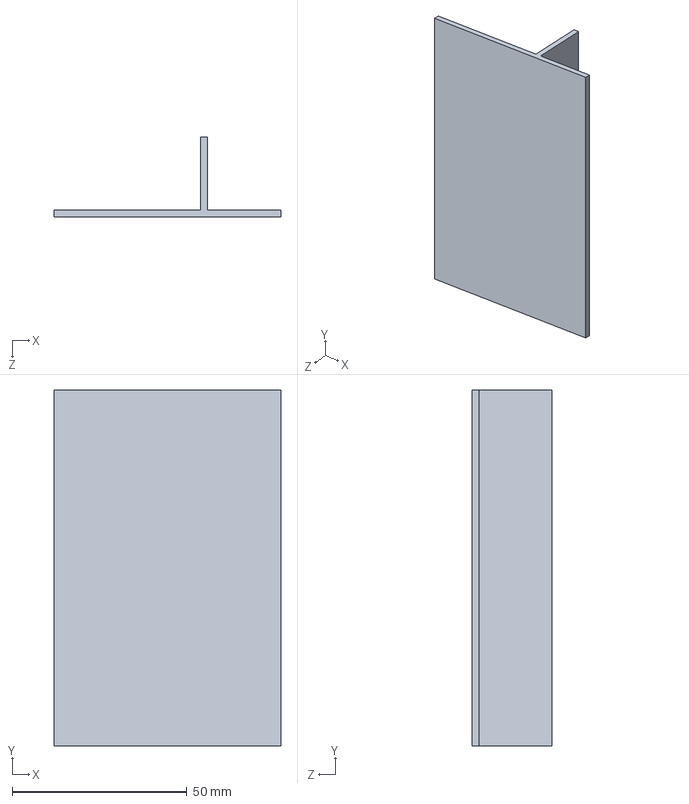
[picture p46: CAD file, 2022-01-01]
Models/Forward/blade 2.SLDPRT
65.0 x 102.0 x 23.0 mm
