codyhylau/Integrated-Design-Project/IDP CADS FINAL/Curve/Curve.SLDPRT

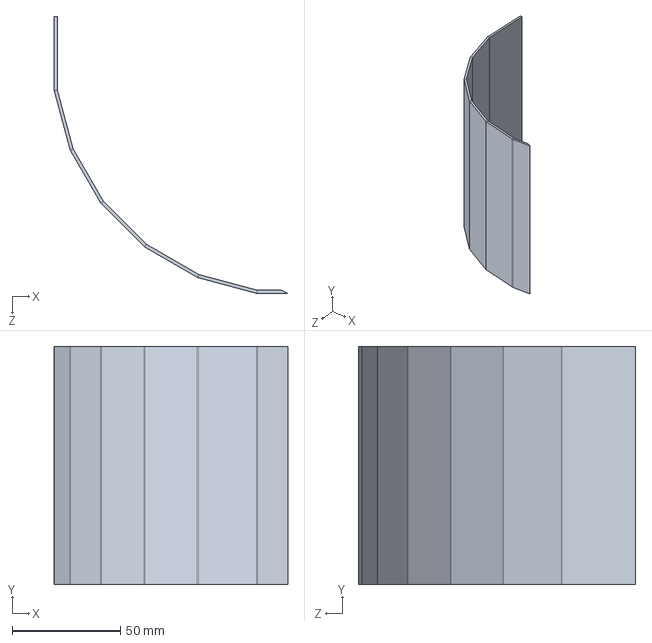
[picture p47: CAD file, 2022-01-01]
IDP CADS FINAL/Curve/Curve.SLDPRT
107.8 x 110.0 x 127.8 mm
