codyhylau/Integrated-Design-Project/IDP CADS FINAL/Servo/Servo.SLDPRT

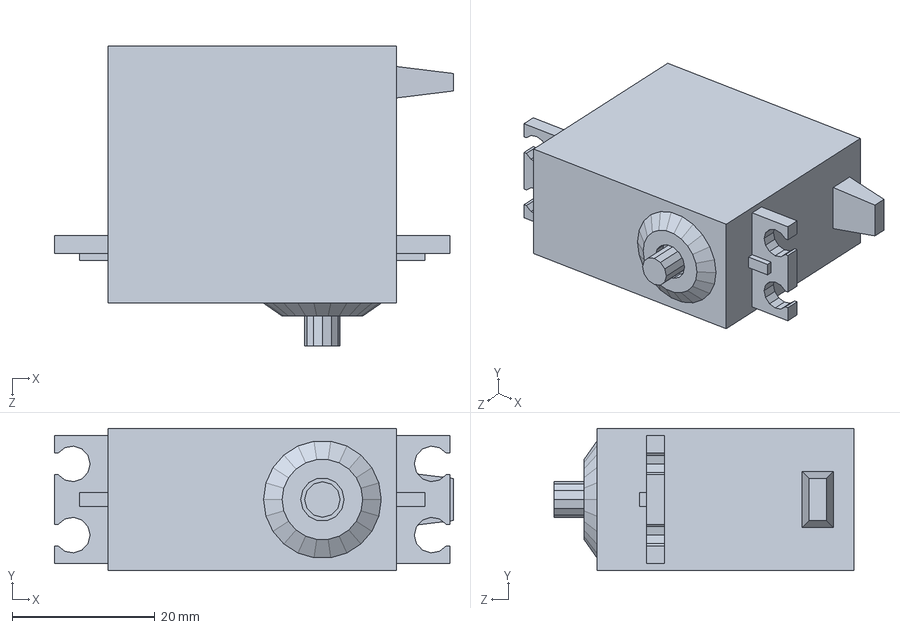
[picture p48: CAD file, 2022-01-01]
IDP CADS FINAL/Servo/Servo.SLDPRT
56.0 x 20.0 x 42.1 mm
