codyhylau/Integrated-Design-Project/IDP CADS FINAL/wall and ramp/wall.SLDPRT

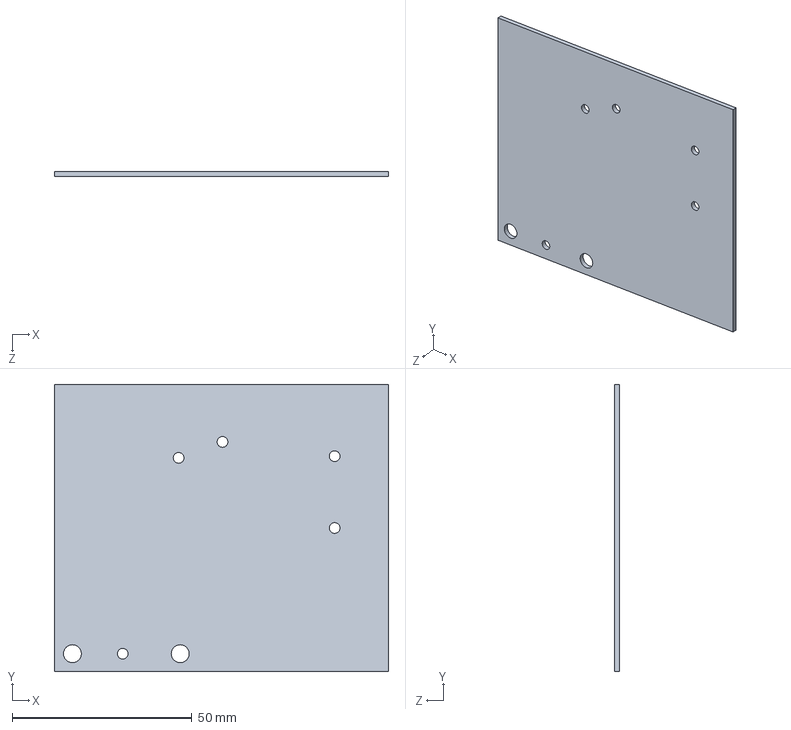
[picture p49: CAD file, 2022-01-01]
IDP CADS FINAL/wall and ramp/wall.SLDPRT
93.0 x 80.0 x 1.50 mm
