codyhylau/Integrated-Design-Project/Models/FINAL/HC-SR04 Ping Sensor/PCB.SLDPRT

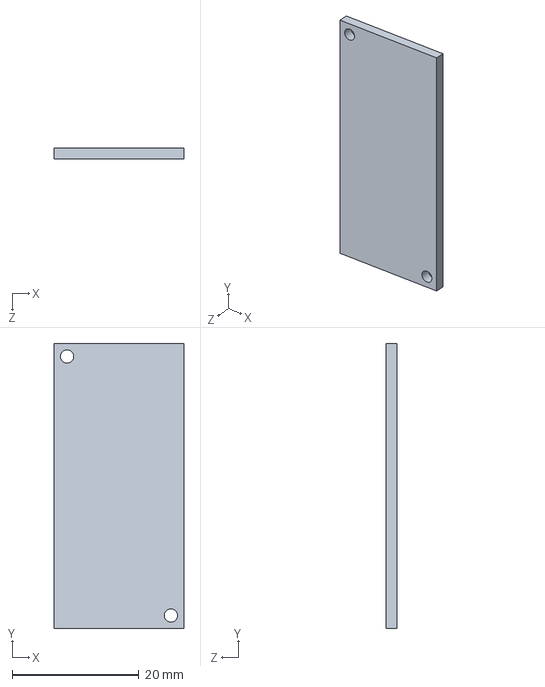
[picture p50: CAD file, 2022-01-01]
Models/FINAL/HC-SR04 Ping Sensor/PCB.SLDPRT
20.5 x 45.0 x 1.75 mm
