codyhylau/Integrated-Design-Project/Models/Sideways/infrared wall.SLDPRT

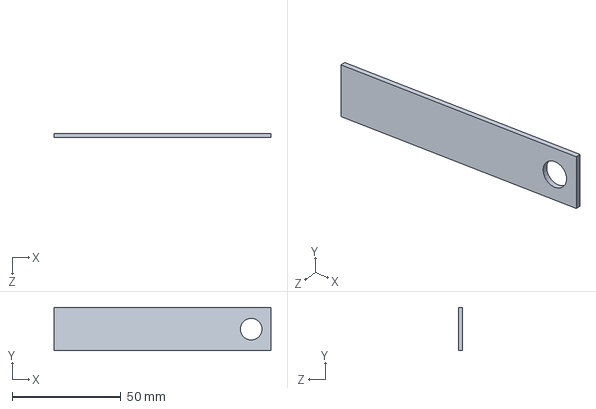
[picture p51: CAD file, 2022-01-01]
Models/Sideways/infrared wall.SLDPRT
100.0 x 20.0 x 2.00 mm
