codyhylau/Integrated-Design-Project/IDP CADS FINAL/Arm/arm axle.SLDPRT

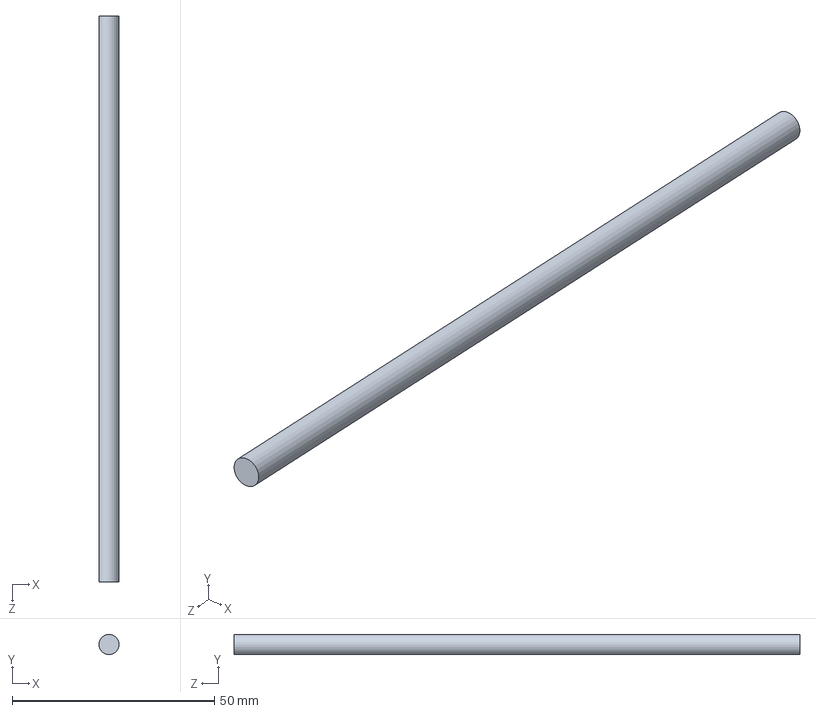
[picture p52: CAD file, 2022-01-01]
IDP CADS FINAL/Arm/arm axle.SLDPRT
5.00 x 5.00 x 140.0 mm
