codyhylau/Integrated-Design-Project/IDP CADS FINAL/Motor Mount Small.SLDPRT

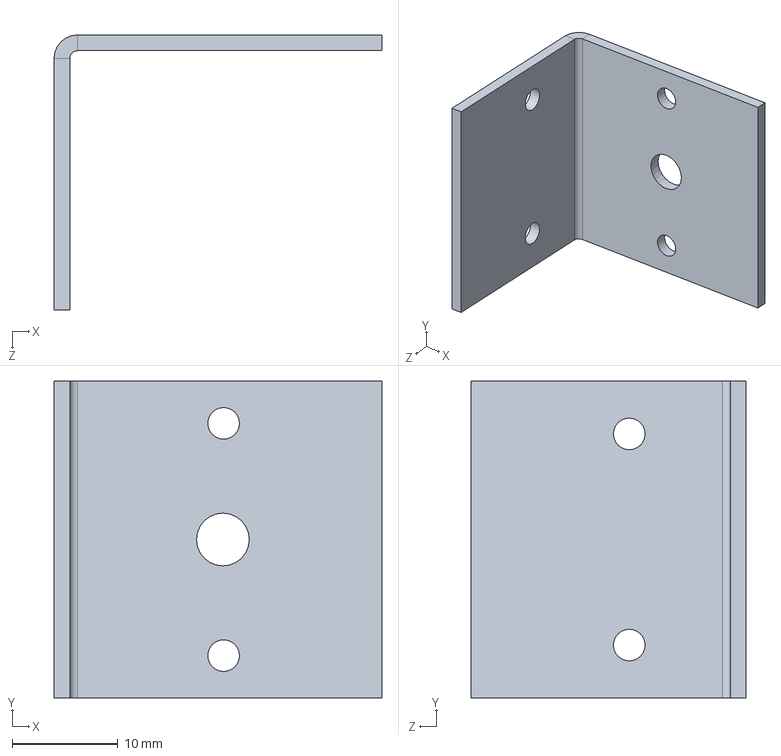
[picture p53: CAD file, 2022-01-01]
IDP CADS FINAL/Motor Mount Small.SLDPRT
31.1 x 30.0 x 26.1 mm
