codyhylau/Integrated-Design-Project/IDP CADS FINAL/Servo/spur_gear_50.SLDPRT

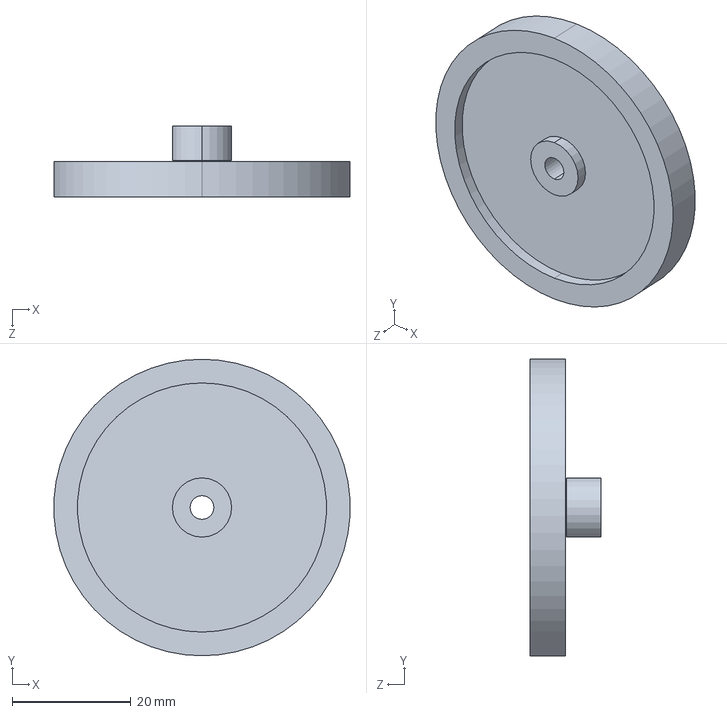
[picture p54: CAD file, 2022-01-01]
IDP CADS FINAL/Servo/spur_gear_50.SLDPRT
49.9 x 50.0 x 12.0 mm
