codyhylau/Integrated-Design-Project/IDP CADS FINAL/Ultrasonic Sensor/3 Pin Header 90 Degree.SLDPRT

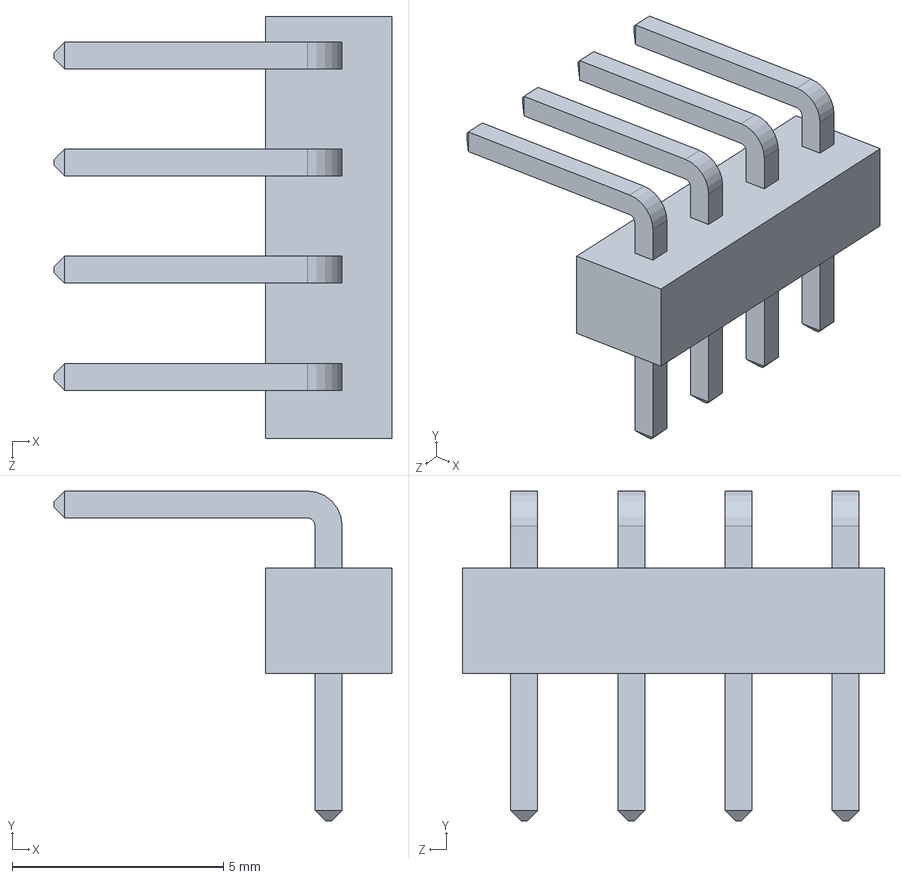
[picture p55: CAD file, 2022-01-01]
IDP CADS FINAL/Ultrasonic Sensor/3 Pin Header 90 Degree.SLDPRT
8.00 x 7.82 x 10.0 mm
