codyhylau/Integrated-Design-Project/IDP CADS FINAL/wall and ramp/ramp.SLDPRT

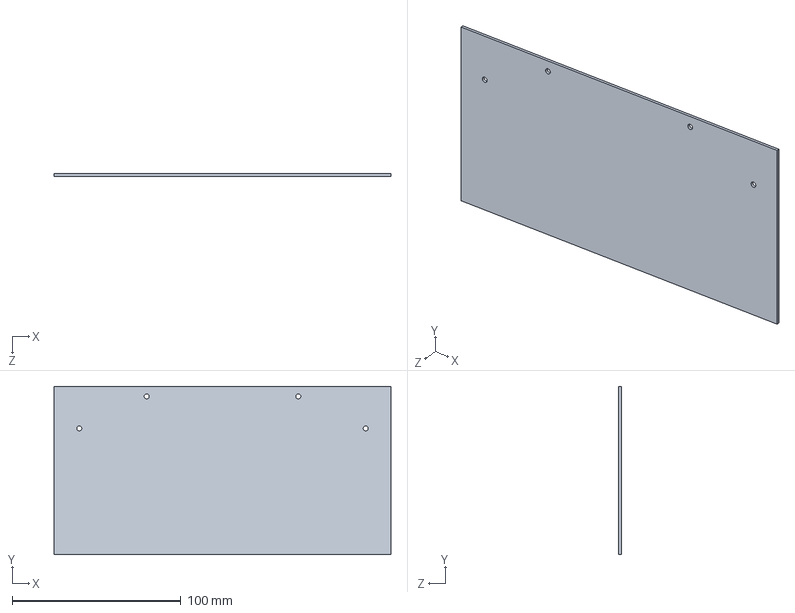
[picture p56: CAD file, 2022-01-01]
IDP CADS FINAL/wall and ramp/ramp.SLDPRT
200.0 x 100.0 x 1.50 mm
