codyhylau/Integrated-Design-Project/Models/FINAL/HC-SR04 Ping Sensor/Cap1 SMT.SLDPRT

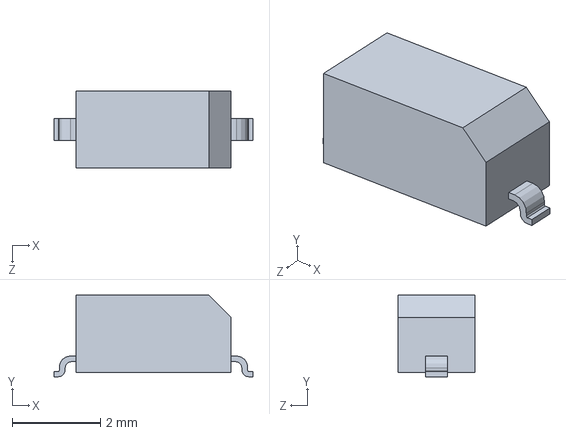
[picture p57: CAD file, 2022-01-01]
Models/FINAL/HC-SR04 Ping Sensor/Cap1 SMT.SLDPRT
4.50 x 1.84 x 1.75 mm
