codyhylau/Integrated-Design-Project/Models/FINAL/Top Chassis.SLDPRT

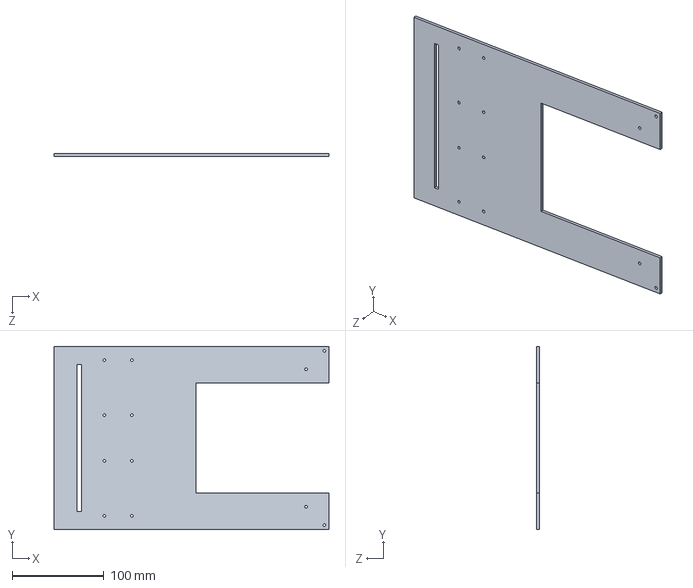
[picture p58: CAD file, 2022-01-01]
Models/FINAL/Top Chassis.SLDPRT
300.0 x 200.0 x 3.00 mm
