codyhylau/Integrated-Design-Project/Models/Forward/chasis - Copy.SLDPRT

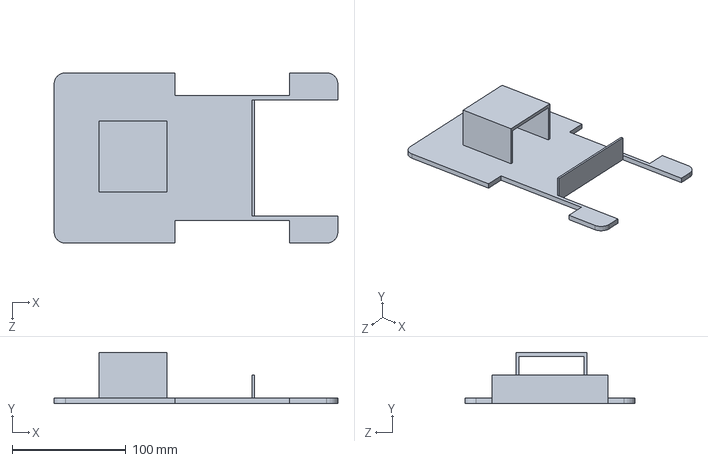
[picture p59: CAD file, 2022-01-01]
Models/Forward/chasis - Copy.SLDPRT
250.0 x 45.0 x 150.0 mm
