codyhylau/Integrated-Design-Project/Models/Sideways/minesweeper.SLDPRT

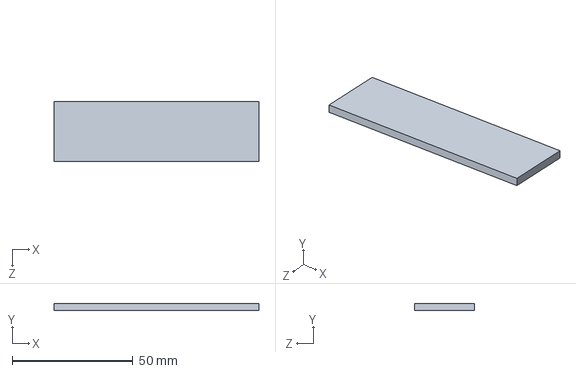
[picture p60: CAD file, 2022-01-01]
Models/Sideways/minesweeper.SLDPRT
85.0 x 3.00 x 25.0 mm
