codyhylau/Integrated-Design-Project/IDP CADS FINAL/shelf laser cut.SLDPRT

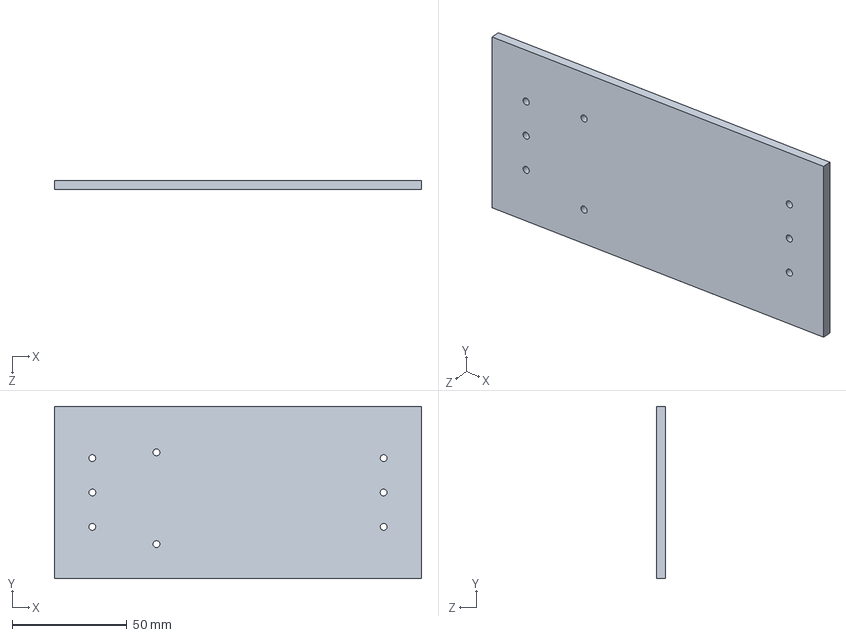
[picture p61: CAD file, 2022-01-01]
IDP CADS FINAL/shelf laser cut.SLDPRT
160.0 x 75.0 x 4.00 mm
