codyhylau/Integrated-Design-Project/Models/Forward/front plate 2.SLDPRT

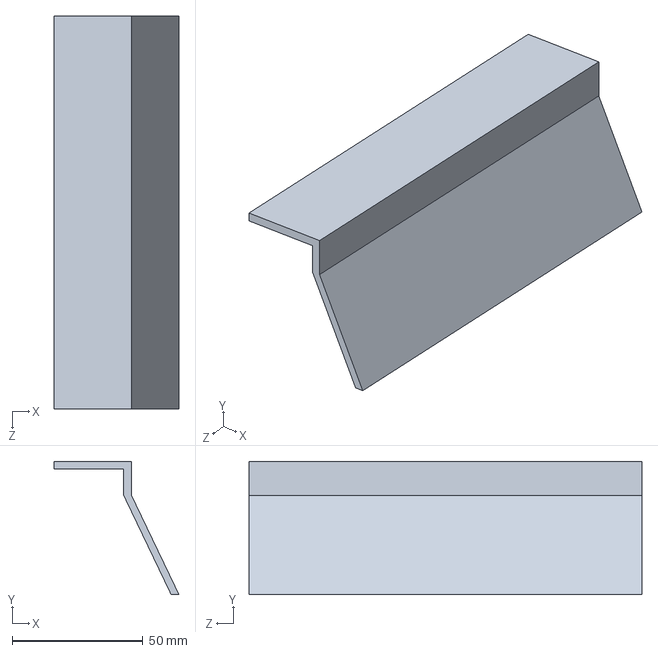
[picture p62: CAD file, 2022-01-01]
Models/Forward/front plate 2.SLDPRT
47.7 x 50.9 x 150.0 mm
