codyhylau/Integrated-Design-Project/Models/Sideways/chasis.SLDPRT

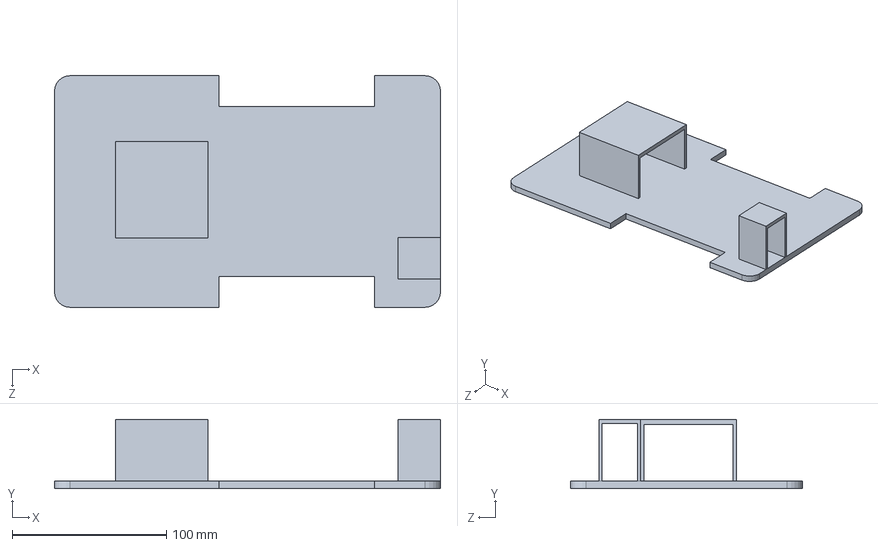
[picture p63: CAD file, 2022-01-01]
Models/Sideways/chasis.SLDPRT
250.0 x 45.0 x 150.0 mm
