codyhylau/Integrated-Design-Project/Models/sput_gear_60.SLDPRT

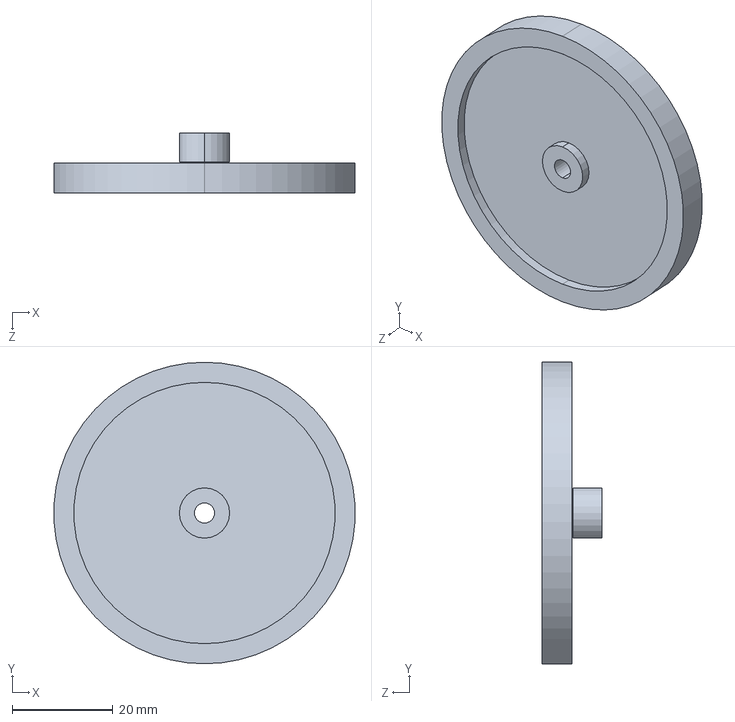
[picture p64: CAD file, 2022-01-01]
Models/sput_gear_60.SLDPRT
59.9 x 60.0 x 12.0 mm
