codyhylau/Integrated-Design-Project/IDP CADS FINAL/Arm/arm L plate.SLDPRT

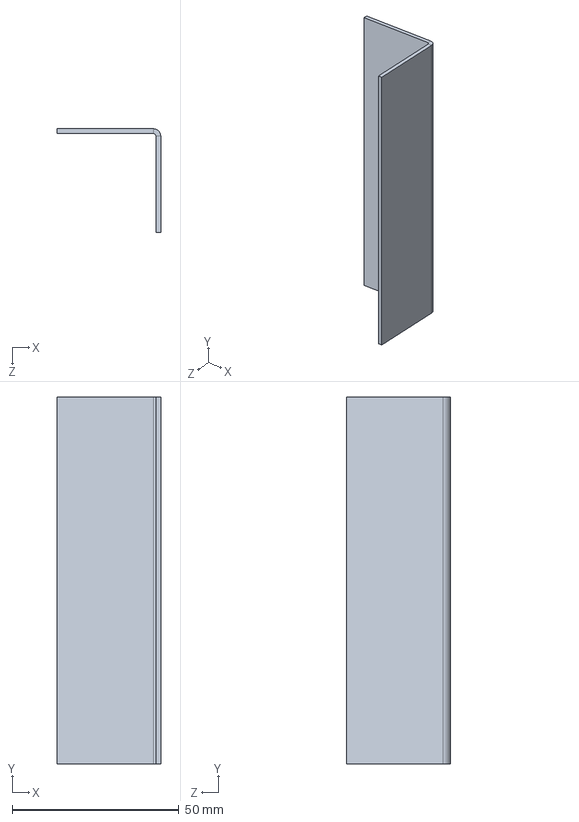
[picture p65: CAD file, 2022-01-01]
IDP CADS FINAL/Arm/arm L plate.SLDPRT
31.1 x 110.0 x 31.1 mm
