codyhylau/Integrated-Design-Project/IDP CADS FINAL/Ball Castor Mount Right.SLDPRT

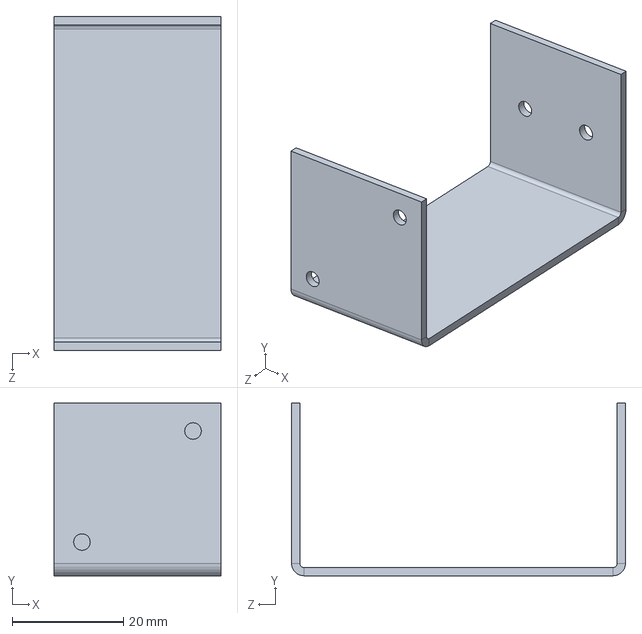
[picture p66: CAD file, 2022-01-01]
IDP CADS FINAL/Ball Castor Mount Right.SLDPRT
30.0 x 31.1 x 60.1 mm
