codyhylau/Integrated-Design-Project/IDP CADS FINAL/wall and ramp/divider.SLDPRT

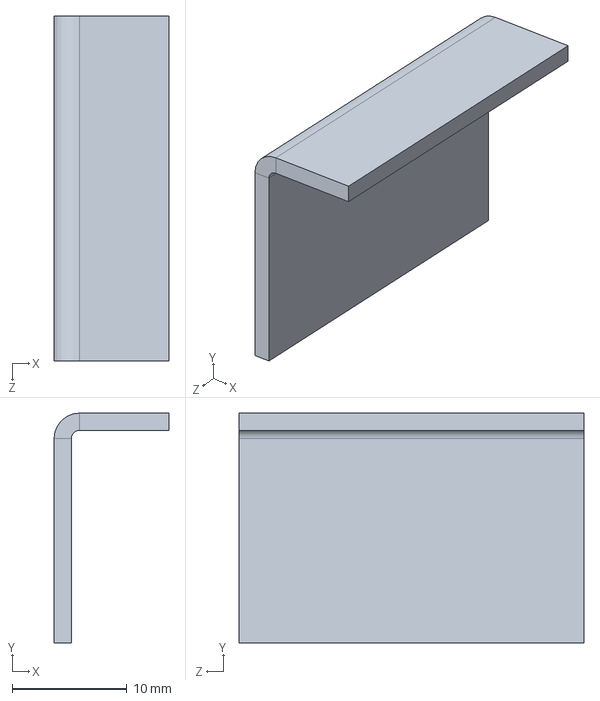
[picture p67: CAD file, 2022-01-01]
IDP CADS FINAL/wall and ramp/divider.SLDPRT
10.0 x 20.0 x 30.0 mm
