codyhylau/Integrated-Design-Project/Models/servo.igs

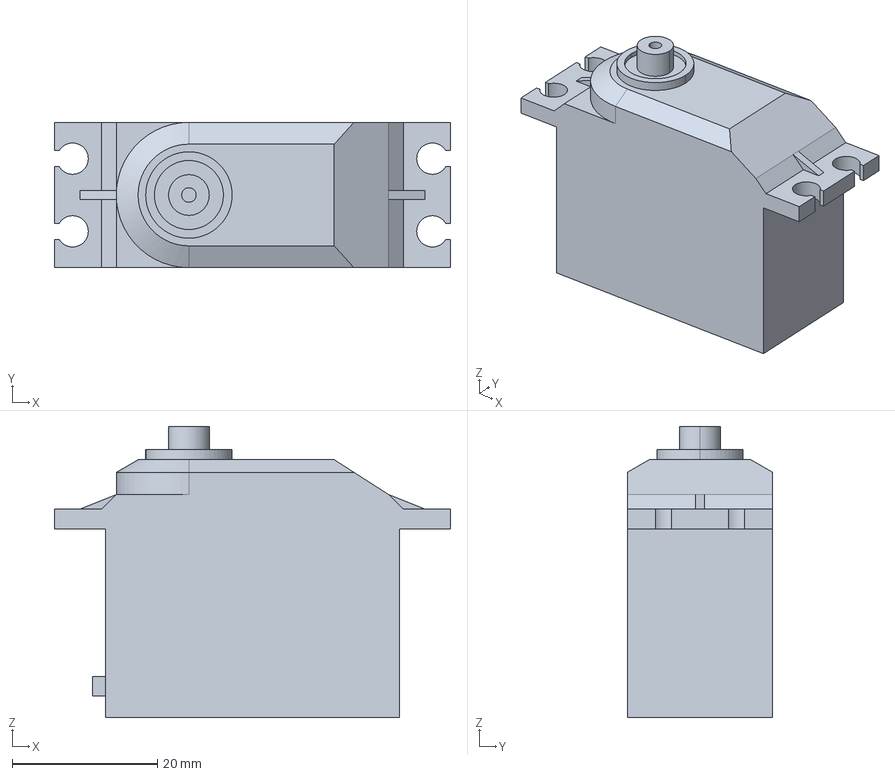
[picture p68: CAD file, 2022-01-01]
Models/servo.igs
54.5 x 20.0 x 40.1 mm
