codyhylau/Integrated-Design-Project/IDP CADS FINAL/Motor-10.SLDPRT

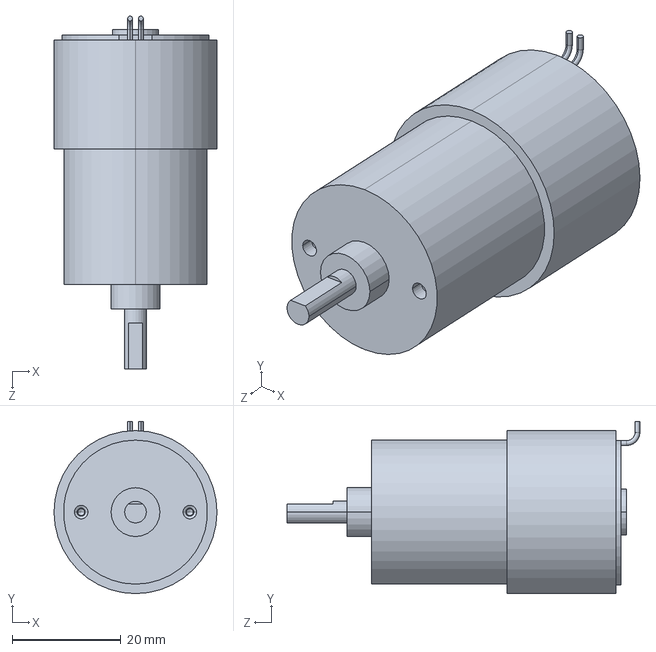
[picture p69: CAD file, 2022-01-01]
IDP CADS FINAL/Motor-10.SLDPRT
30.0 x 31.7 x 64.9 mm
