codyhylau/Integrated-Design-Project/Models/FINAL/Hall Sensor Mount.SLDPRT

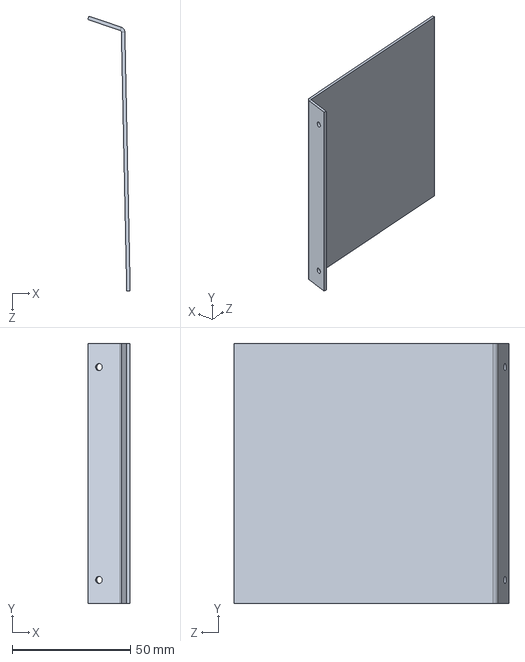
[picture p70: CAD file, 2022-01-01]
Models/FINAL/Hall Sensor Mount.SLDPRT
18.0 x 110.0 x 116.2 mm
