codyhylau/Integrated-Design-Project/Models/Forward/side plate.SLDPRT

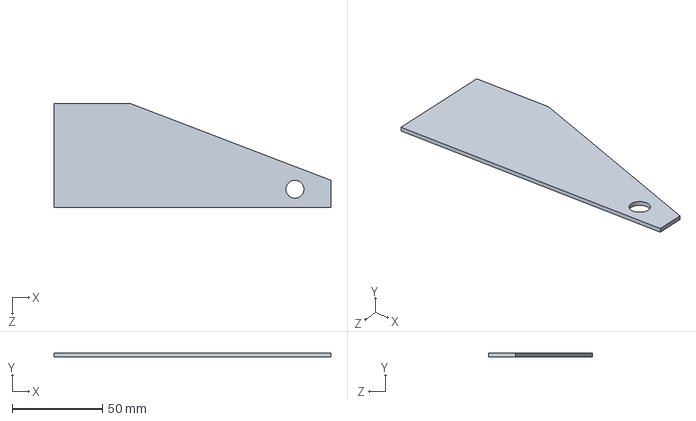
[picture p71: CAD file, 2022-01-01]
Models/Forward/side plate.SLDPRT
153.7 x 2.00 x 57.5 mm
