codyhylau/Integrated-Design-Project/Models/motor-body.SLDPRT

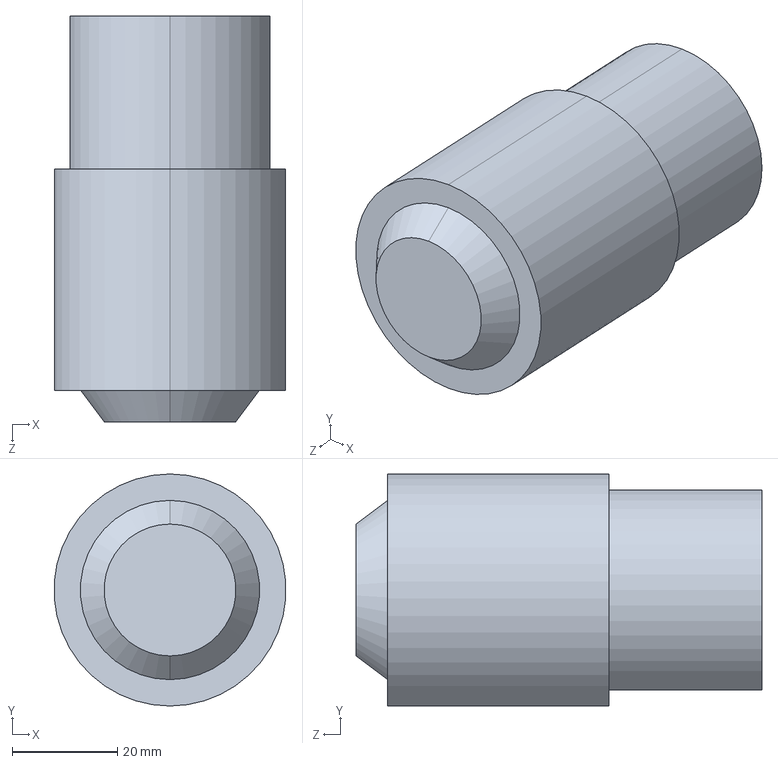
[picture p72: CAD file, 2022-01-01]
Models/motor-body.SLDPRT
43.9 x 44.0 x 77.0 mm
