codyhylau/Integrated-Design-Project/Models/Sideways/blade.SLDPRT

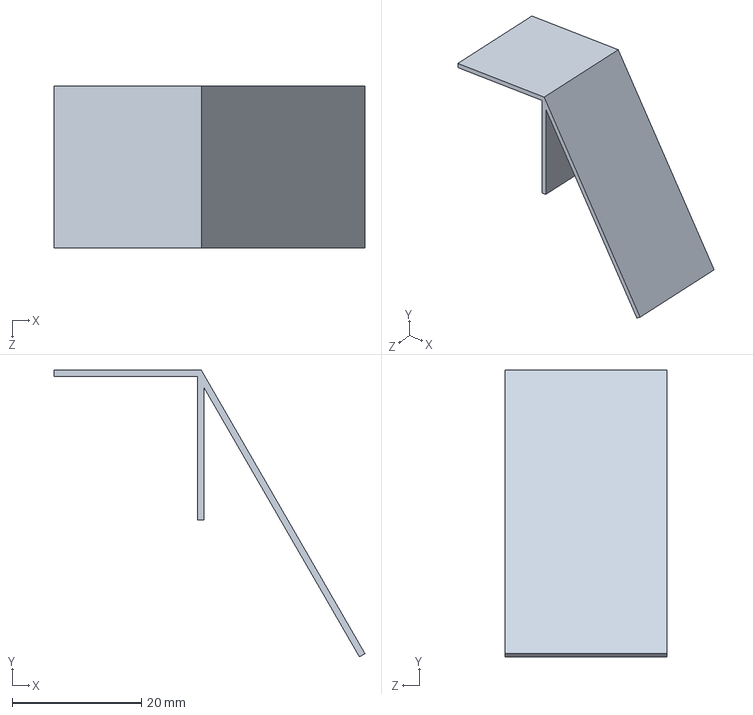
[picture p73: CAD file, 2022-01-01]
Models/Sideways/blade.SLDPRT
48.1 x 44.3 x 25.0 mm
