codyhylau/Integrated-Design-Project/Models/FINAL/Big motor mount.SLDPRT

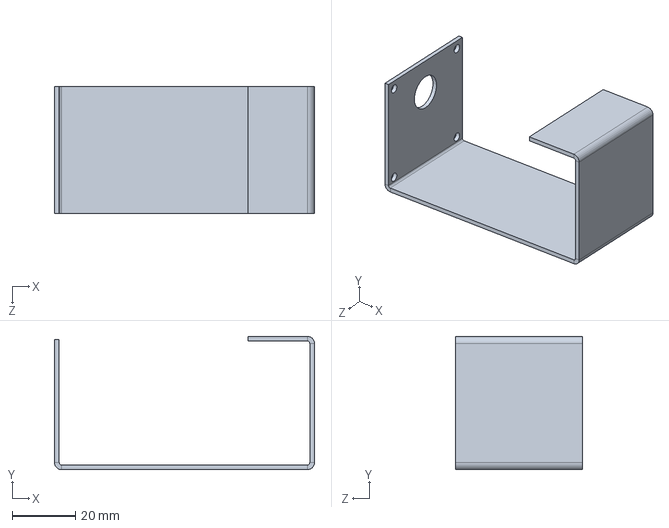
[picture p74: CAD file, 2022-01-01]
Models/FINAL/Big motor mount.SLDPRT
82.1 x 42.1 x 40.0 mm
