codyhylau/Integrated-Design-Project/Models/opto_switch.SLDPRT

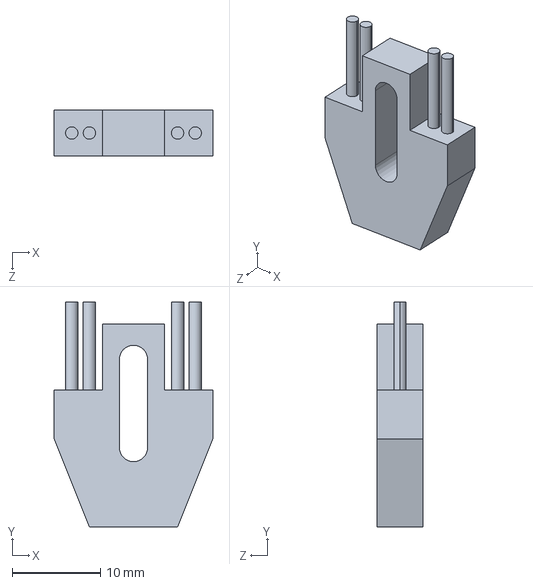
[picture p75: CAD file, 2022-01-01]
Models/opto_switch.SLDPRT
18.0 x 25.5 x 5.20 mm
