codyhylau/Integrated-Design-Project/IDP CADS FINAL/Hall Sensor Mount.SLDPRT

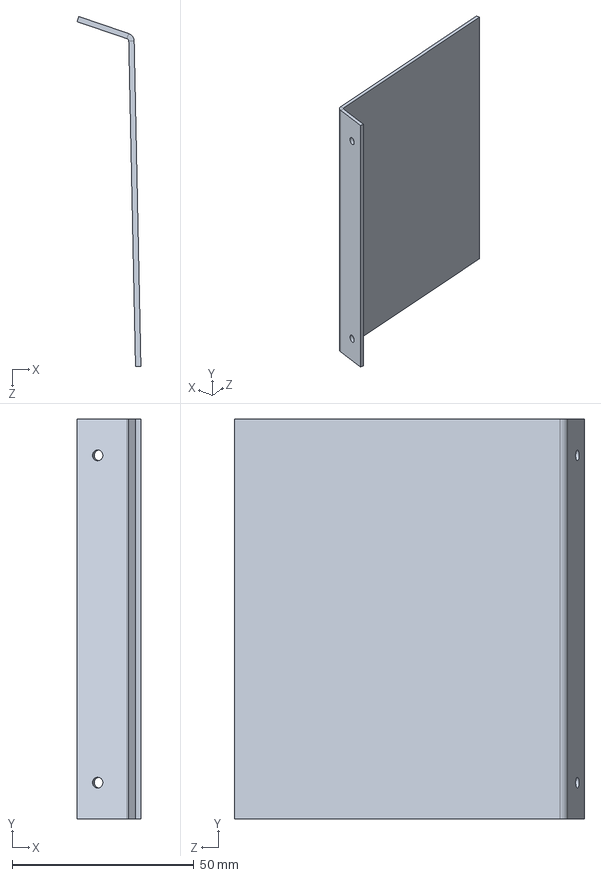
[picture p76: CAD file, 2022-01-01]
IDP CADS FINAL/Hall Sensor Mount.SLDPRT
17.6 x 110.0 x 96.2 mm
