codyhylau/Integrated-Design-Project/Models/pillar.SLDPRT

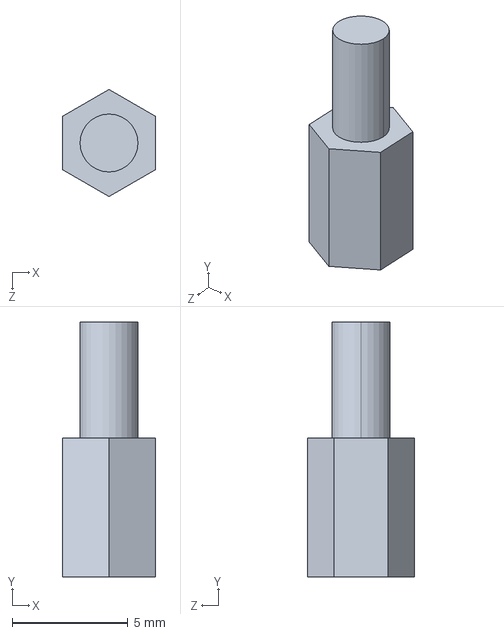
[picture p77: CAD file, 2022-01-01]
Models/pillar.SLDPRT
4.00 x 11.0 x 4.62 mm
