codyhylau/Integrated-Design-Project/Models/worm.SLDPRT

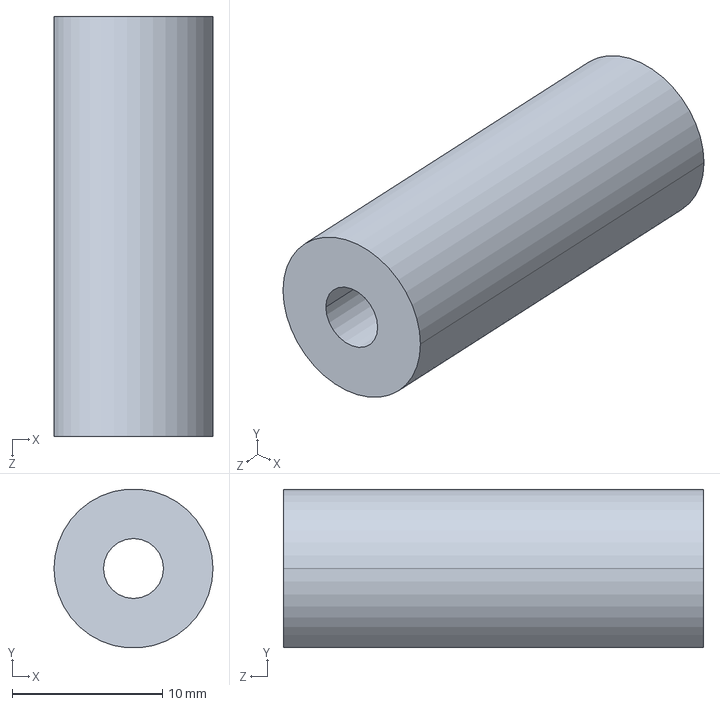
[picture p78: CAD file, 2022-01-01]
Models/worm.SLDPRT
10.6 x 10.6 x 28.0 mm
