codyhylau/Integrated-Design-Project/IDP CADS FINAL/Line Follower mount.SLDPRT

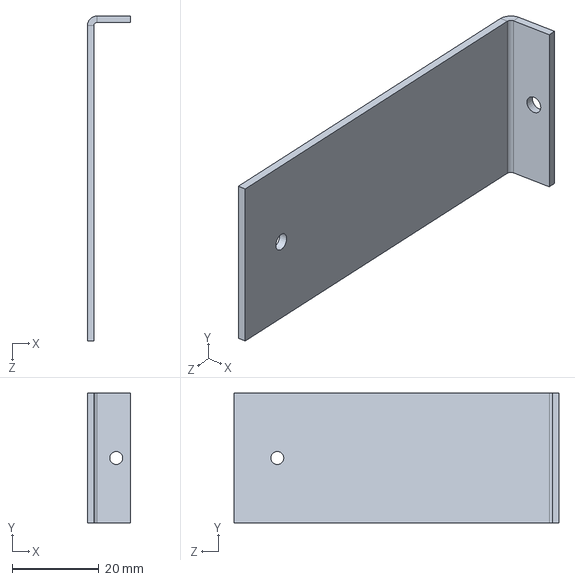
[picture p79: CAD file, 2022-01-01]
IDP CADS FINAL/Line Follower mount.SLDPRT
10.0 x 30.0 x 75.0 mm
