codyhylau/Integrated-Design-Project/Models/spurgear_blank_gt_39t.SLDPRT

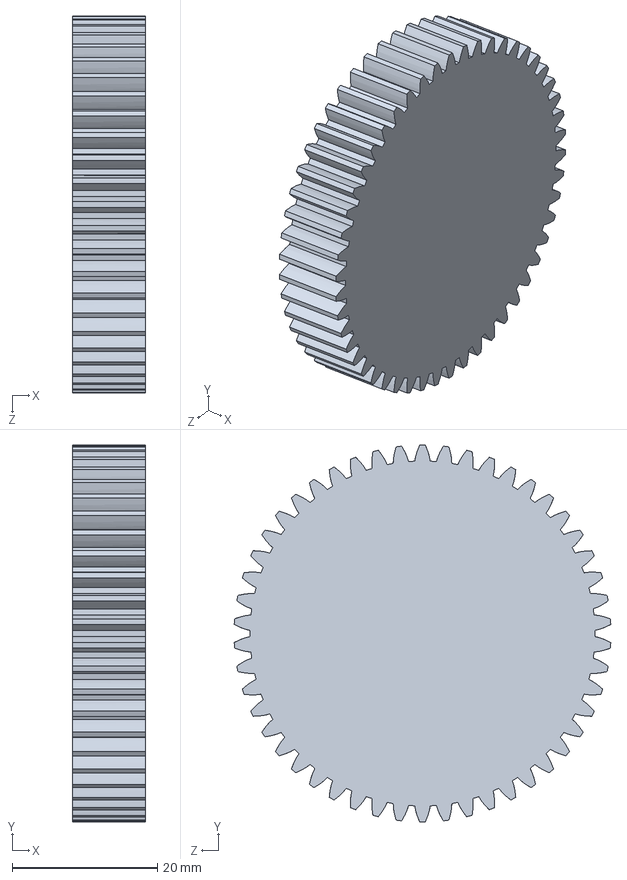
[picture p80: CAD file, 2022-01-01]
Models/spurgear_blank_gt_39t.SLDPRT
10.0 x 52.0 x 51.9 mm
