codyhylau/Integrated-Design-Project/Models/motor-front-plt.SLDPRT

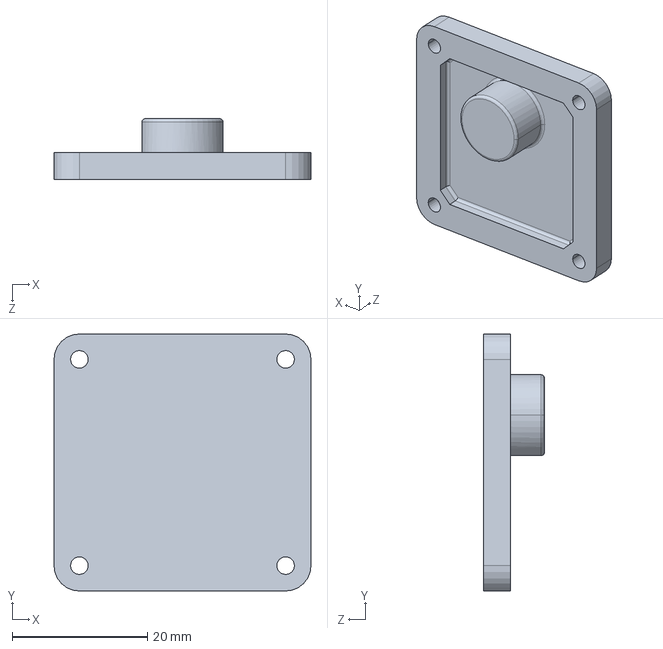
[picture p81: CAD file, 2022-01-01]
Models/motor-front-plt.SLDPRT
38.0 x 38.0 x 9.00 mm
