codyhylau/Integrated-Design-Project/Models/mine.SLDPRT

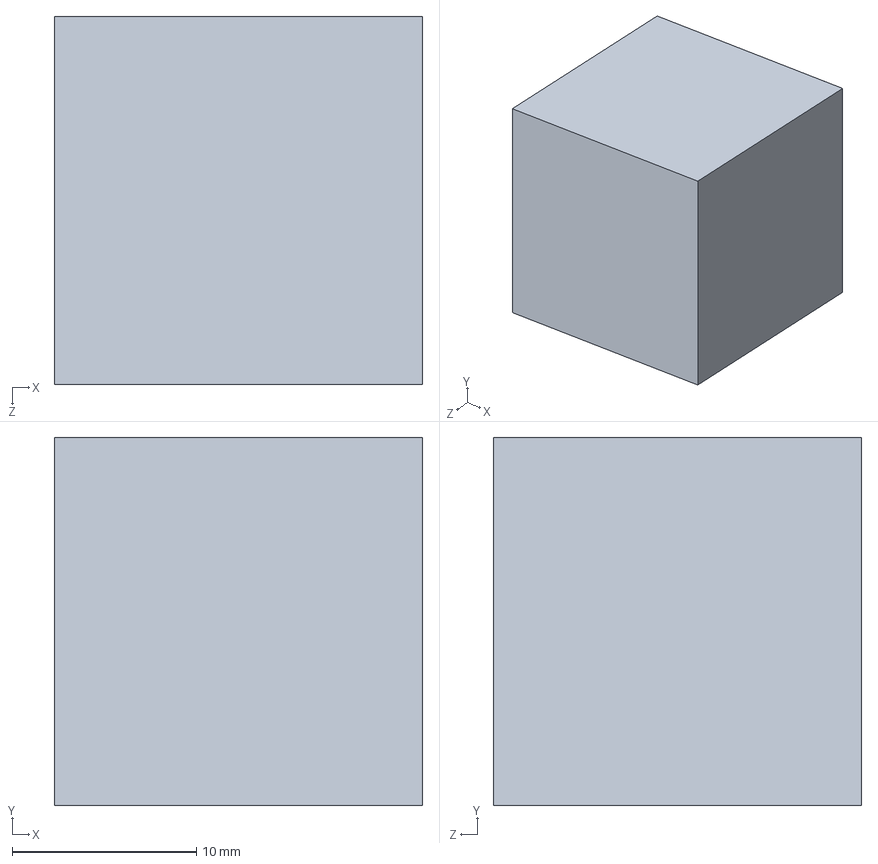
[picture p82: CAD file, 2022-01-01]
Models/mine.SLDPRT
20.0 x 20.0 x 20.0 mm
