codyhylau/Integrated-Design-Project/Models/spur_gear_10.SLDPRT

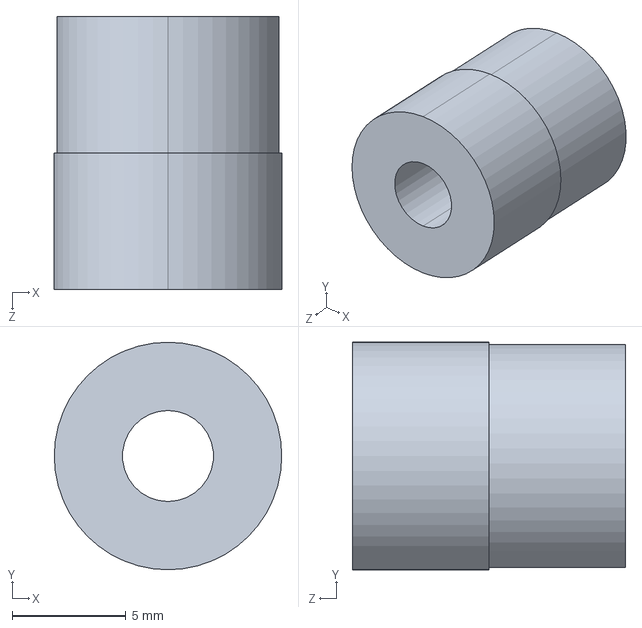
[picture p83: CAD file, 2022-01-01]
Models/spur_gear_10.SLDPRT
10.0 x 10.0 x 12.0 mm
