codyhylau/Integrated-Design-Project/Models/spur_gear_30.SLDPRT

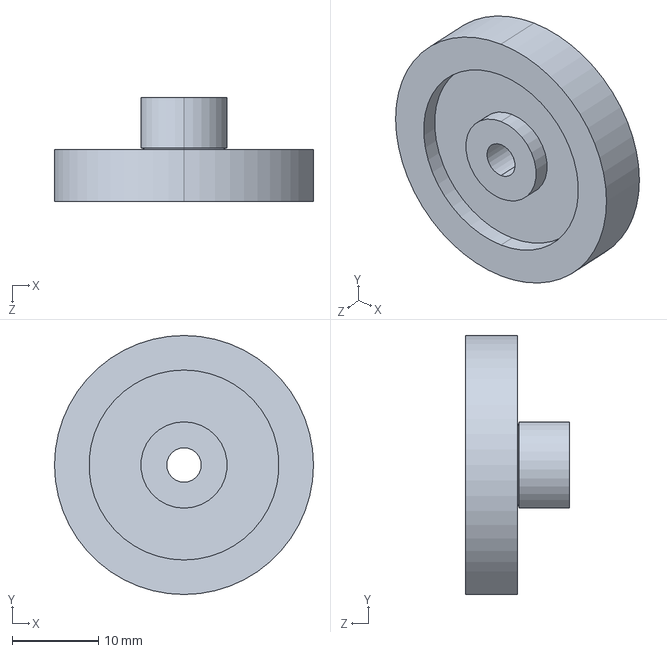
[picture p84: CAD file, 2022-01-01]
Models/spur_gear_30.SLDPRT
30.0 x 30.0 x 12.0 mm
