codyhylau/Integrated-Design-Project/Models/pulley-40.SLDPRT

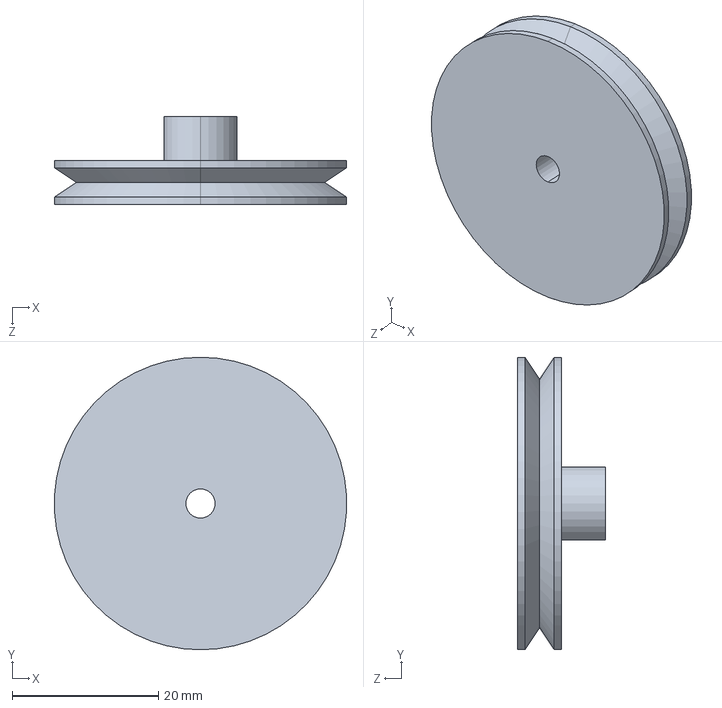
[picture p85: CAD file, 2022-01-01]
Models/pulley-40.SLDPRT
39.9 x 40.0 x 12.0 mm
