codyhylau/Integrated-Design-Project/Models/back_clevis_mount.SLDPRT

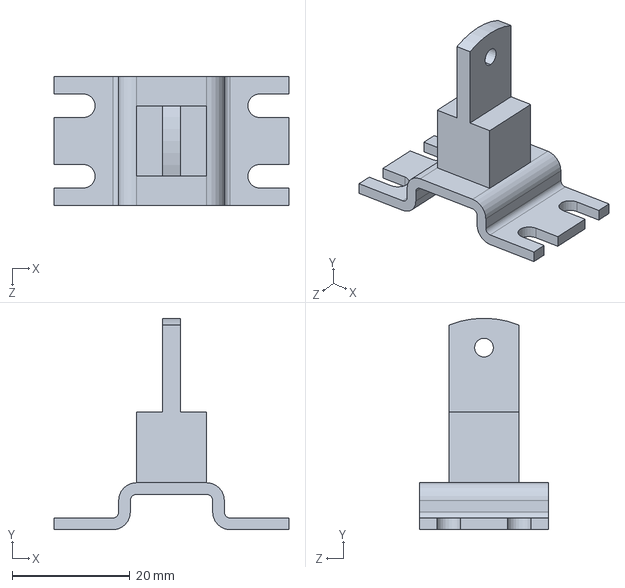
[picture p86: CAD file, 2022-01-01]
Models/back_clevis_mount.SLDPRT
40.0 x 36.0 x 22.0 mm
