codyhylau/Integrated-Design-Project/Models/pulley-60.SLDPRT

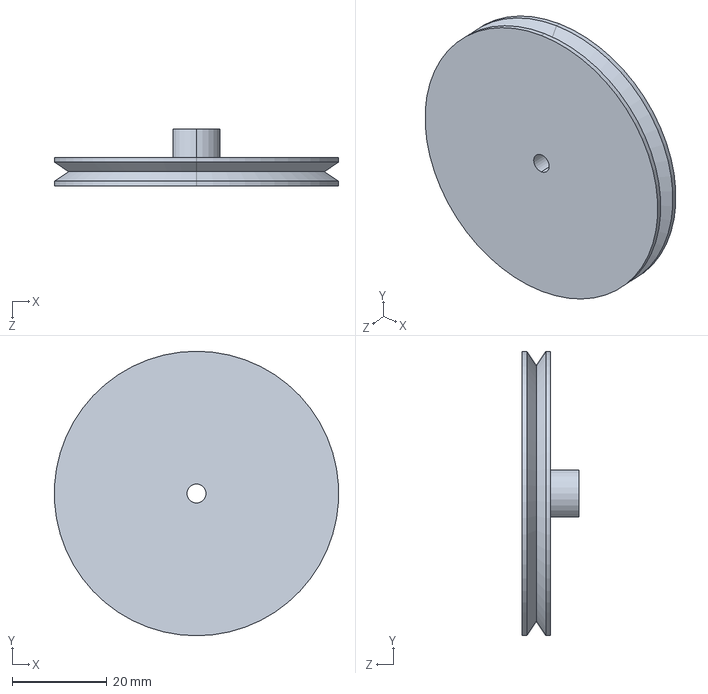
[picture p87: CAD file, 2022-01-01]
Models/pulley-60.SLDPRT
59.9 x 60.0 x 12.0 mm
