codyhylau/Integrated-Design-Project/Models/pulley-20.SLDPRT

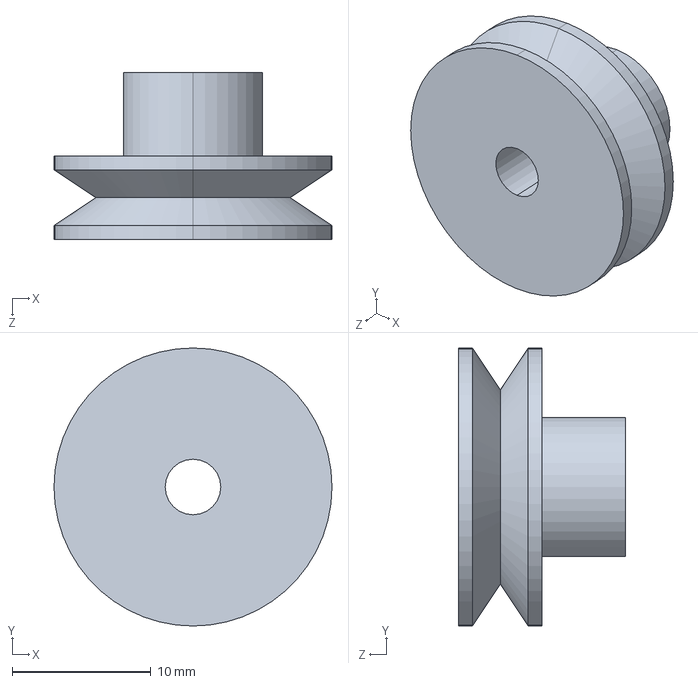
[picture p88: CAD file, 2022-01-01]
Models/pulley-20.SLDPRT
20.0 x 20.0 x 12.0 mm
