codyhylau/Integrated-Design-Project/Models/motor-shaft.SLDPRT

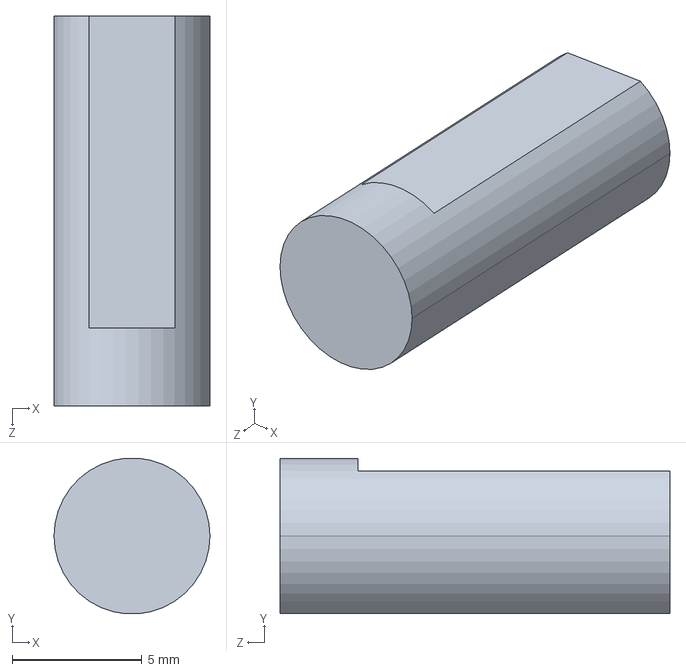
[picture p89: CAD file, 2022-01-01]
Models/motor-shaft.SLDPRT
6.00 x 5.98 x 15.0 mm
