codyhylau/Integrated-Design-Project/Models/Battery_box_RL6165-F.stp

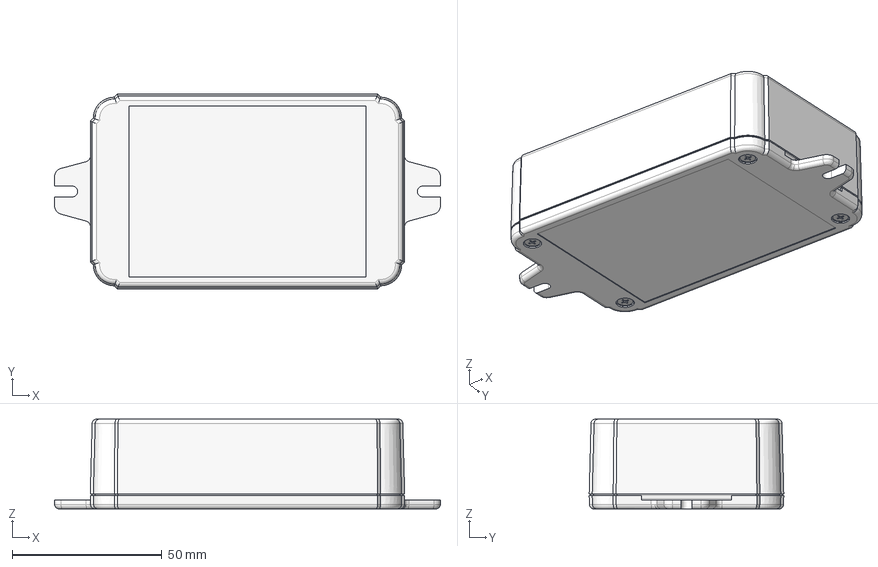
[picture p90: CAD file, 2022-01-01]
Models/Battery_box_RL6165-F.stp
128.9 x 65.0 x 30.0 mm
RL6165-B v0 130902
RL6175-TF v0 130902
(screw M2.6X 20mm FH) x 4
