codyhylau/Integrated-Design-Project/Models/motor_mount.SLDPRT

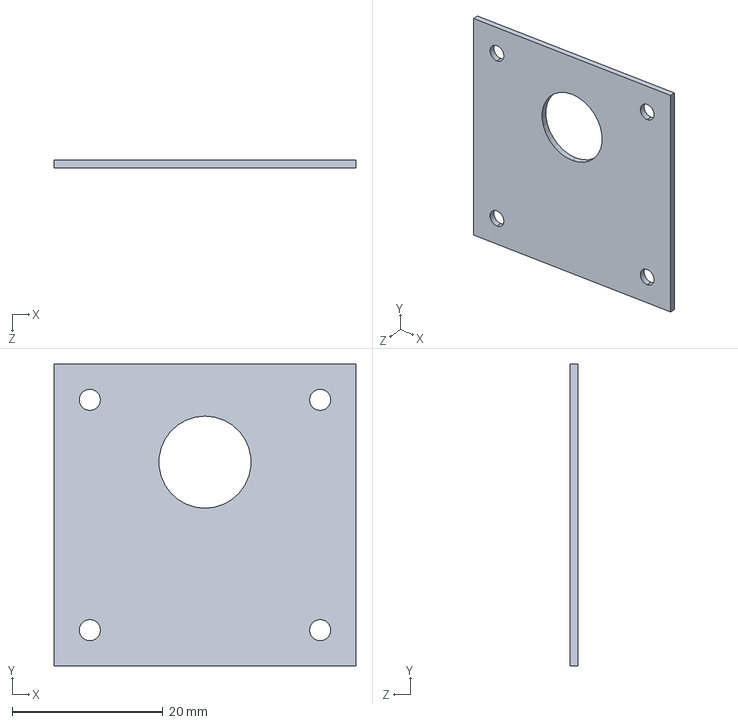
[picture p91: CAD file, 2022-01-01]
Models/motor_mount.SLDPRT
40.0 x 40.0 x 1.00 mm
