codyhylau/Integrated-Design-Project/Models/spurgear_blank_lt_40t.SLDPRT

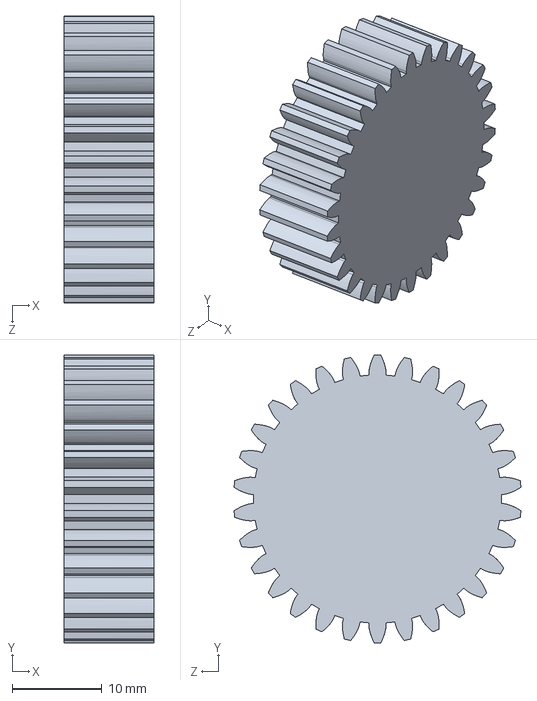
[picture p92: CAD file, 2022-01-01]
Models/spurgear_blank_lt_40t.SLDPRT
10.0 x 32.0 x 31.9 mm
