codyhylau/Integrated-Design-Project/Models/spur_gear_40.SLDPRT

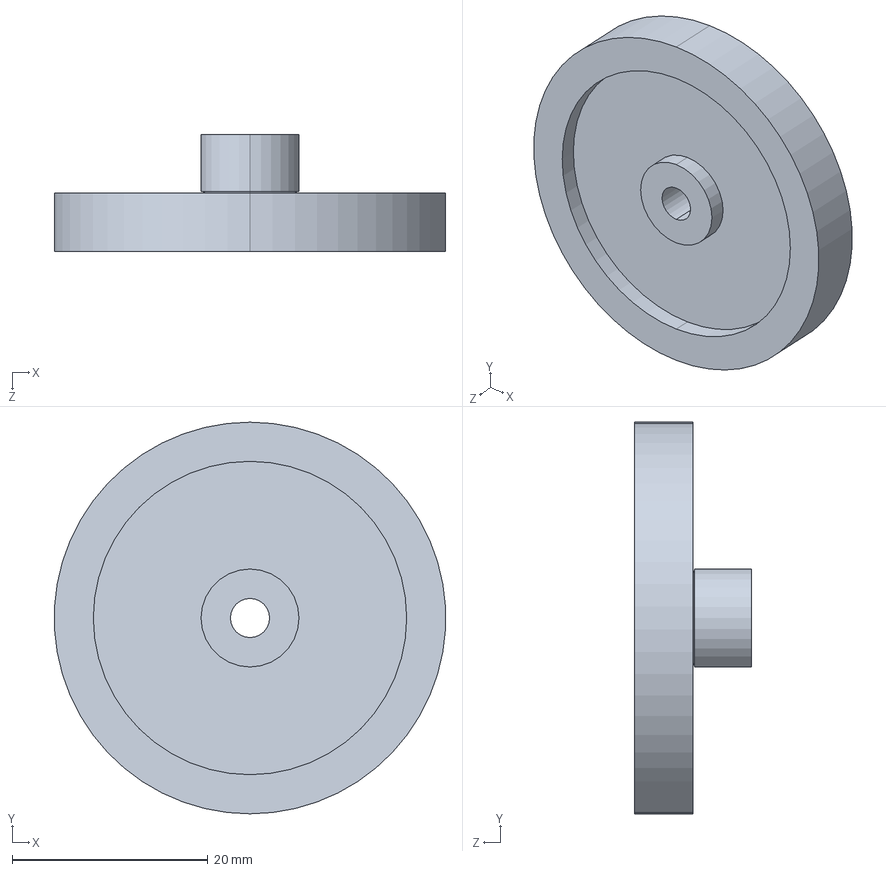
[picture p93: CAD file, 2022-01-01]
Models/spur_gear_40.SLDPRT
39.9 x 40.0 x 12.0 mm
