codyhylau/Integrated-Design-Project/Models/u-processor.SLDPRT

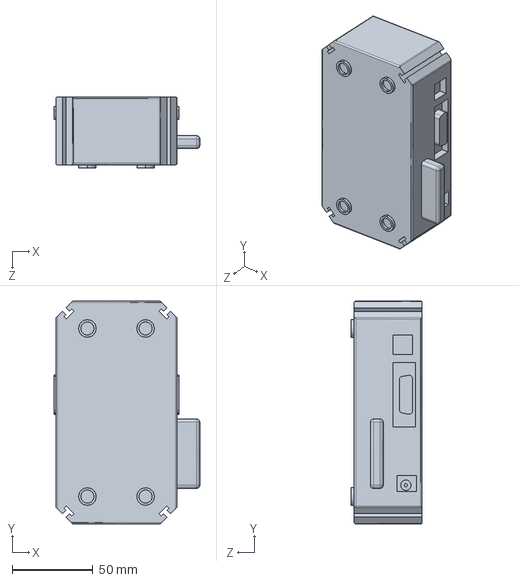
[picture p94: CAD file, 2022-01-01]
Models/u-processor.SLDPRT
90.2 x 138.0 x 44.0 mm
