codyhylau/Integrated-Design-Project/(list of files, cad)

Other CAD files:
IDP CADS FINAL/wall and ramp/wall assembly left.SLDASM
Models/FINAL/HC-SR04 Ping Sensor/HC-SR04 Crystal.SLDASM.SLDPRT
Models/FINAL/HC-SR04 Ping Sensor/HC-SR04 Ping Sensor.SLDASM
Models/FINAL/Servo Assembly.SLDASM
Models/FINAL/Curve Assembly.SLDASM
Models/FINAL/HC-SR04 Ping Sensor/14 Pin SMT.SLDPRT
IDP CADS FINAL/Ball Castor/ball.SLDPRT
IDP CADS FINAL/spur_gear_20.SLDPRT
IDP CADS FINAL/Ultrasonic Sensor/Transducer.SLDPRT
Models/FINAL/new-motor-40.SLDPRT
Models/FINAL/Gear Rack.SLDPRT
Models/FINAL/HC-SR04 Ping Sensor/3 Pin Header 90 Degree.SLDPRT
IDP CADS FINAL/Ultrasonic Sensor/Cap1 SMT.SLDPRT
Models/FINAL/LED Panel.SLDPRT
Models/Sideways/ball.SLDPRT
IDP CADS FINAL/Ultrasonic Sensor/PCB.SLDPRT
Models/FINAL/Servo Mount.SLDPRT
Models/Forward/ball 2.SLDPRT
IDP CADS FINAL/Ball Castor Mount Left.SLDPRT
Models/FINAL/Servo.SLDPRT
Models/new-motor-40.SLDPRT
Models/FINAL/Shelf mount.SLDPRT
IDP CADS FINAL/Motor Mount Large.SLDPRT
Models/FINAL/Side US Mount.SLDPRT
Models/mitre_m1_20t.prt.SLDPRT
Models/FINAL/Curve.SLDPRT
Models/FINAL/Curve L.SLDPRT
Models/new-motor-20.SLDPRT
Models/FINAL/Line Follower mount.SLDPRT
Models/spur_gear_20.SLDPRT
IDP CADS FINAL/Ball Castor/ball castor.SLDPRT
IDP CADS FINAL/Drawings temporary/1 Chassis Main.SLDDRW
IDP CADS FINAL/Drawings temporary/11 arm assembly components/11.1 arm main plate.SLDDRW
IDP CADS FINAL/Drawings temporary/11 arm assembly components/11.2 arm axle(1).SLDDRW
IDP CADS FINAL/Drawings temporary/11 arm assembly components/11.2 arm axle.SLDDRW
IDP CADS FINAL/Drawings temporary/11 arm assembly components/11.3 arm L plate(1).SLDDRW
IDP CADS FINAL/Drawings temporary/11 arm assembly components/11.3 arm L plate.SLDDRW
IDP CADS FINAL/Drawings temporary/11 arm assembly.SLDDRW
IDP CADS FINAL/Drawings temporary/12 Curve Assembly.SLDDRW
IDP CADS FINAL/Drawings temporary/12 Curve assembly components/12.1 Curve.SLDDRW
IDP CADS FINAL/Drawings temporary/12 Curve assembly components/12.2 Curve L.SLDDRW
IDP CADS FINAL/Drawings temporary/13 LED Panel.SLDDRW
IDP CADS FINAL/Drawings temporary/15 Ultrasonic Sensor Mount Back Assembly components/15.1 Ultrasonic Sensor Mount Back.SLDDRW
IDP CADS FINAL/Drawings temporary/15 Ultrasonic Sensor Mount Back Assembly.SLDDRW
IDP CADS FINAL/Drawings temporary/16 Ultrasonic Sensor Side Assembly components/16.1 Ultrasonic Sensor Mount Side.SLDDRW
IDP CADS FINAL/Drawings temporary/16 Ultrasonic Sensor Side Assembly components/Ultrasonic Sensor Mount Side.SLDDRW
IDP CADS FINAL/Drawings temporary/16 Ultronic Sensor Side Assembly.SLDDRW
IDP CADS FINAL/Drawings temporary/17 Arm rod support.SLDDRW
IDP CADS FINAL/Drawings temporary/18 wall assembly left.SLDDRW
IDP CADS FINAL/Drawings temporary/18.1 wall L plate left.SLDDRW
IDP CADS FINAL/Drawings temporary/18.2 wall.SLDDRW
IDP CADS FINAL/Drawings temporary/18.3 divider.SLDDRW
IDP CADS FINAL/Drawings temporary/19 wall assembly right.SLDDRW
IDP CADS FINAL/Drawings temporary/2 Ball Castor Mount Left.SLDDRW
IDP CADS FINAL/Drawings temporary/20 ramp.SLDDRW
IDP CADS FINAL/Drawings temporary/21 Hall Sensor Mount.SLDDRW
IDP CADS FINAL/Drawings temporary/3 Ball Castor Mount Right.SLDDRW
IDP CADS FINAL/Drawings temporary/4 Line Follower mount.SLDDRW
IDP CADS FINAL/Drawings temporary/5 Motor Mount Large.SLDDRW
IDP CADS FINAL/Drawings temporary/6 Motor Mount Small.SLDDRW
IDP CADS FINAL/Drawings temporary/8 shelf laser cut.SLDDRW
IDP CADS FINAL/Drawings temporary/9 Shelf mount.SLDDRW
IDP CADS FINAL/Drawings temporary/OVERALL ASSEMBLY.SLDDRW
IDP CADS FINAL/LED Panel/LED Panel.DXF
Models/FINAL/Drawings/Big motor mount.SLDDRW
Models/FINAL/LED Panel.DXF
Models/Forward/ball castor 2.SLDPRT
Models/Sideways/ball castor.SLDPRT
