codyhylau/Integrated-Design-Project/IDP CADS FINAL/Drawings temporary/PDFs/0 OVERALL ASSEMBLY.PDF

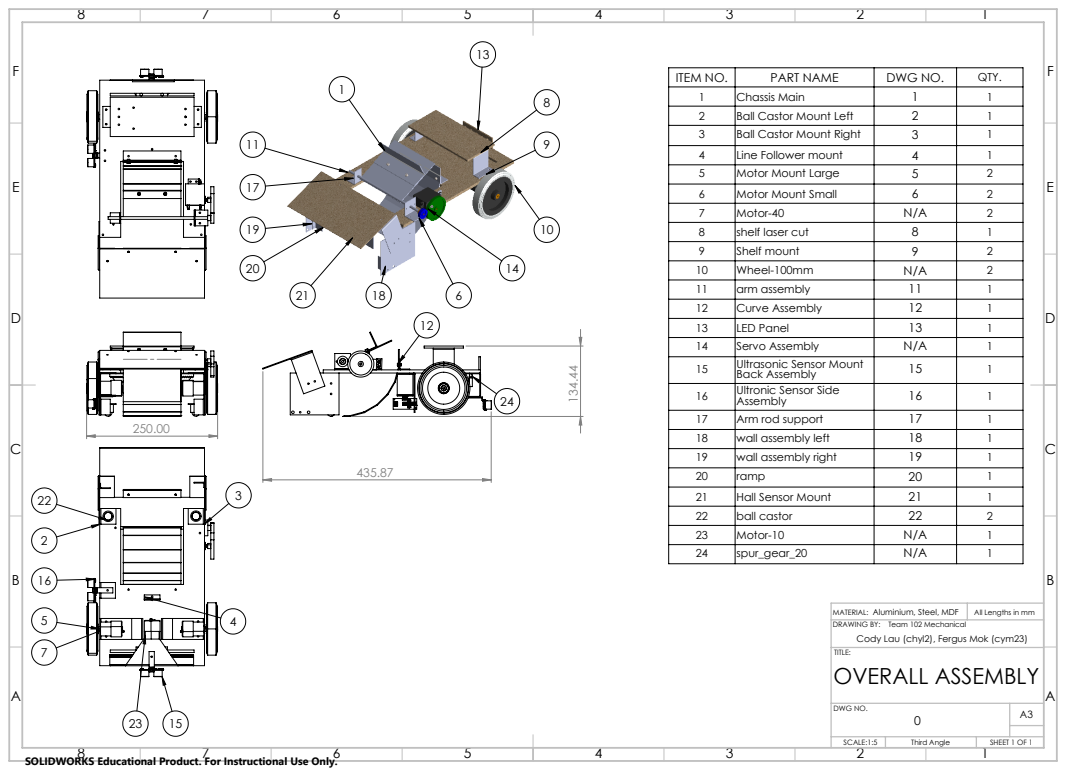
[picture p95: page 1]
MATERIAL:; All Lengths in mm; DWG NO.; SCALE:1:5; SHEET 1 OF 1; Third Angle

ITEM NO. | PART NAME | DWG NO. | QTY.
1 | Chassis Main | 1 | 1
2 | Ball Castor Mount Left | 2 | 1
3 | Ball Castor Mount Right | 3 | 1
4 | Line Follower mount | 4 | 1
5 | Motor Mount Large | 5 | 2
6 | Motor Mount Small | 6 | 2
7 | Motor-40 | N/A | 2
8 | shelf laser cut | 8 | 1
9 | Shelf mount | 9 | 2
10 | Wheel-100mm | N/A | 2
11 | arm assembly | 11 | 1
12 | Curve Assembly | 12 | 1
13 | LED Panel | 13 | 1
14 | Servo Assembly | N/A | 1
15 | Ultrasonic Sensor Mount Back Assembly | 15 | 1
16 | Ultronic Sensor Side Assembly | 16 | 1
17 | Arm rod support | 17 | 1
18 | wall assembly left | 18 | 1
19 | wall assembly right | 19 | 1
20 | ramp | 20 | 1
21 | Hall Sensor Mount | 21 | 1
22 | ball castor | 22 | 2
23 | Motor-10 | N/A | 1
24 | spur_gear_20 | N/A | 1

Aluminium, Steel, MDF
OVERALL ASSEMBLY

DRAWING BY: Team 102 Mechanical
Cody Lau (chyl2), Fergus Mok (cym23)
TITLE:

SOLIDWORKS Educational Product. For Instructional Use Only.
