codyhylau/Integrated-Design-Project/IDP CADS FINAL/Drawings temporary/PDFs/1 Chassis Main.PDF

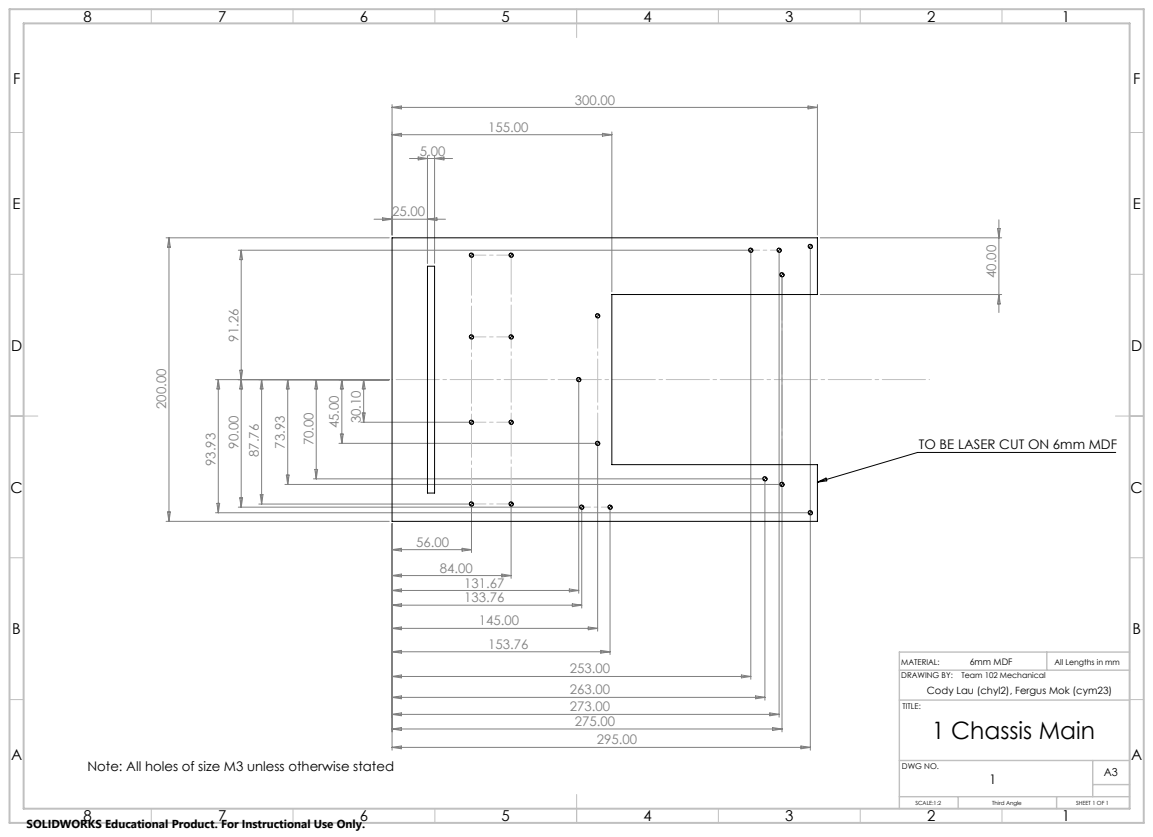
[picture p96: page 1]
MATERIAL:; All Lengths in mm; DWG NO.; SCALE:1:2; SHEET 1 OF 1; 6mm MDF; 1 Chassis Main; Third Angle

TO BE LASER CUT ON 6mm MDF

DRAWING BY: Team 102 Mechanical
Cody Lau (chyl2), Fergus Mok (cym23)
TITLE:

Note: All holes of size M3 unless otherwise stated

SOLIDWORKS Educational Product. For Instructional Use Only.
