codyhylau/Integrated-Design-Project/IDP CADS FINAL/Drawings temporary/PDFs/11 arm assembly.PDF

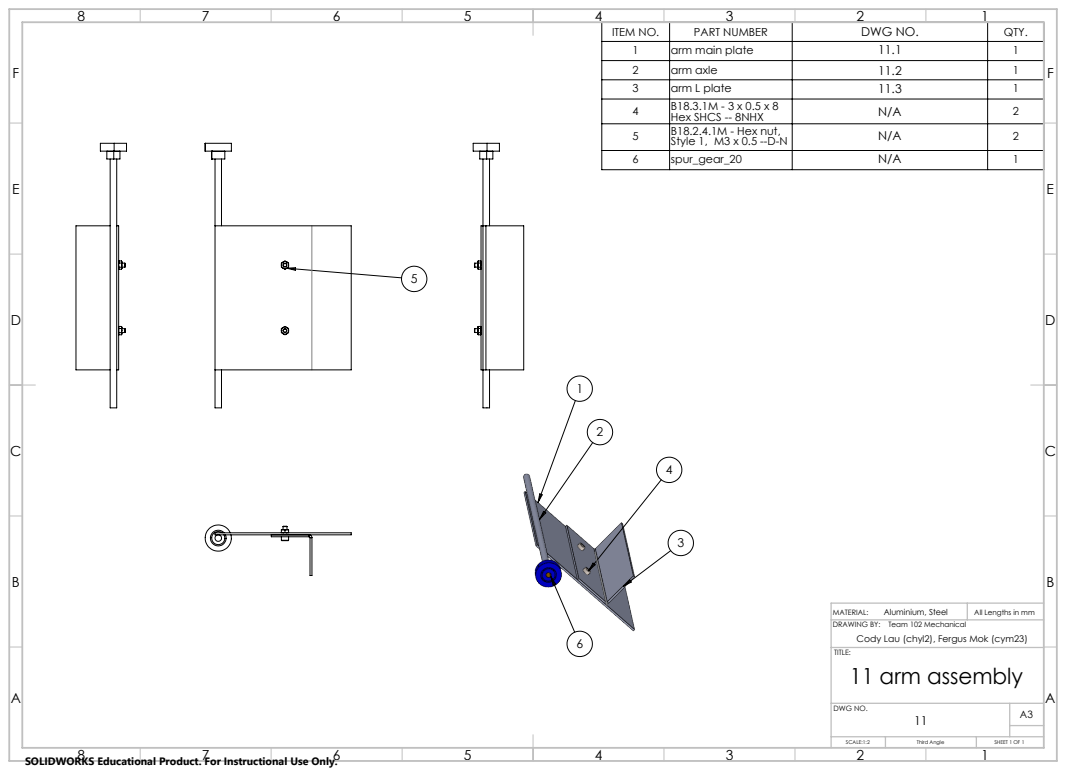
[picture p97: page 1]
MATERIAL:; All Lengths in mm; DWG NO.; SCALE:1:2; SHEET 1 OF 1; Aluminium, Steel; 11 arm assembly; Third Angle

ITEM NO. | PART NUMBER | DWG NO. | QTY.
1 | arm main plate | 11.1 | 1
2 | arm axle | 11.2 | 1
3 | arm L plate | 11.3 | 1
4 | B18.3.1M - 3 x 0.5 x 8 Hex SHCS -- 8NHX | N/A | 2

E | | 5 | B18.2.4.1M - Hex nut, Style 1, M3 x 0.5 --D-N | N/A | 2 | E

6 | spur_gear_20 | N/A | 1

DRAWING BY: Team 102 Mechanical
Cody Lau (chyl2), Fergus Mok (cym23)
TITLE:

SOLIDWORKS Educational Product. For Instructional Use Only.
