codyhylau/Integrated-Design-Project/IDP CADS FINAL/Drawings temporary/PDFs/12 Curve Assembly.PDF

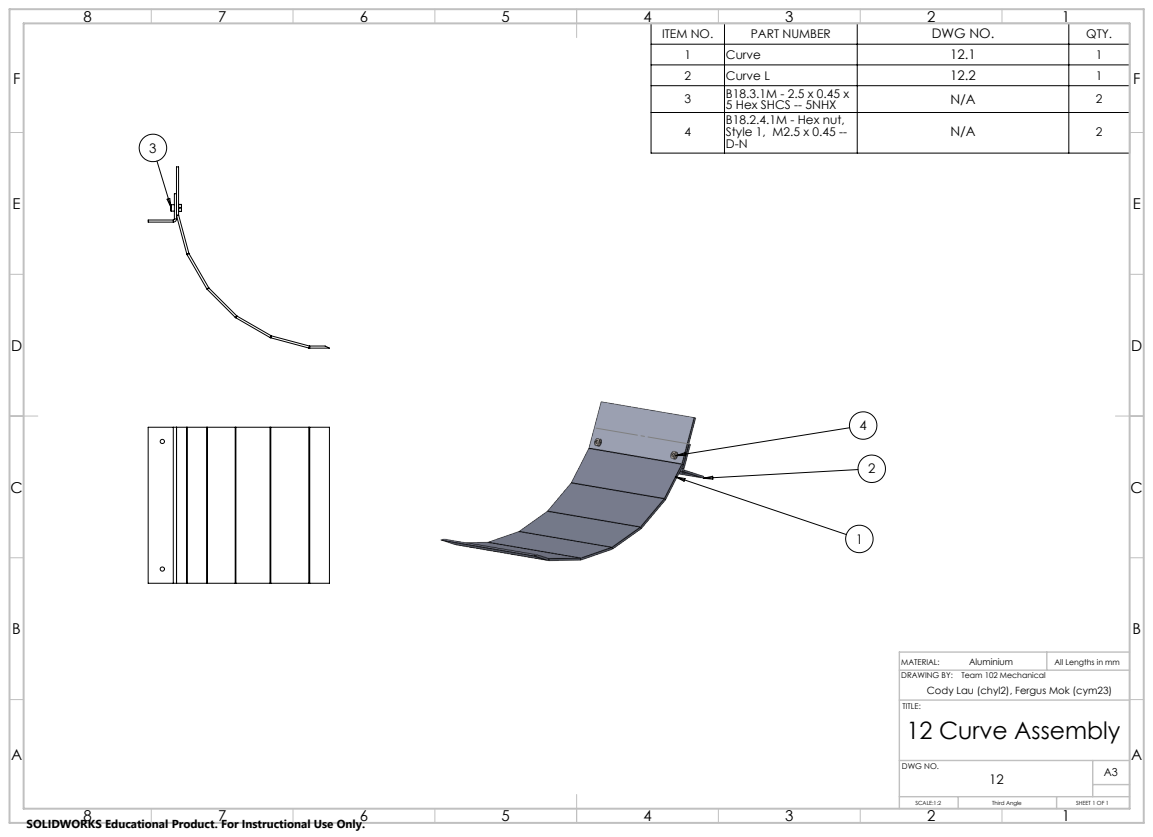
[picture p98: page 1]
MATERIAL:; All Lengths in mm; DWG NO.; SCALE:1:2; SHEET 1 OF 1; 12 Curve Assembly; Third Angle

ITEM NO. | PART NUMBER | DWG NO. | QTY.
1 | Curve | 12.1 | 1
2 | Curve L | 12.2 | 1
3 | B18.3.1M - 2.5 x 0.45 x 5 Hex SHCS -- 5NHX | N/A | 2
4 | B18.2.4.1M - Hex nut, Style 1, M2.5 x 0.45 --D-N | N/A | 2

DRAWING BY: Team 102 Mechanical
Cody Lau (chyl2), Fergus Mok (cym23)
TITLE:

SOLIDWORKS Educational Product. For Instructional Use Only.
