codyhylau/Integrated-Design-Project/IDP CADS FINAL/Drawings temporary/PDFs/15 Ultrasonic Sensor Mount Back Assembly.PDF

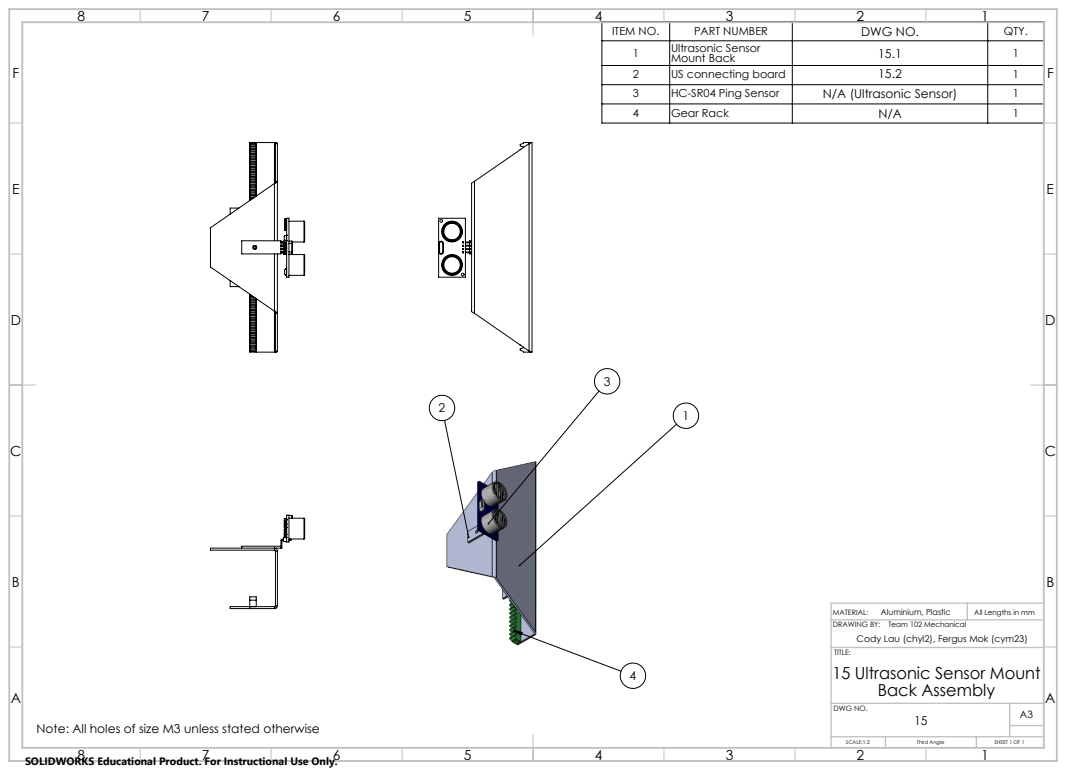
[picture p99: page 1]
MATERIAL:; All Lengths in mm; DWG NO.; SCALE:1:2; SHEET 1 OF 1; Aluminium, Plastic; Third Angle

ITEM NO. | PART NUMBER | DWG NO. | QTY.
1 | Ultrasonic Sensor Mount Back | 15.1 | 1
2 | US connecting board | 15.2 | 1
3 | HC-SR04 Ping Sensor | N/A (Ultrasonic Sensor) | 1
4 | Gear Rack | N/A | 1

DRAWING BY: Team 102 Mechanical
Cody Lau (chyl2), Fergus Mok (cym23)
TITLE:
15 Ultrasonic Sensor Mount
Back Assembly

Note: All holes of size M3 unless stated otherwise
SOLIDWORKS Educational Product. For Instructional Use Only.
