codyhylau/Integrated-Design-Project/IDP CADS FINAL/Drawings temporary/PDFs/16 Ultronic Sensor Side Assembly.PDF

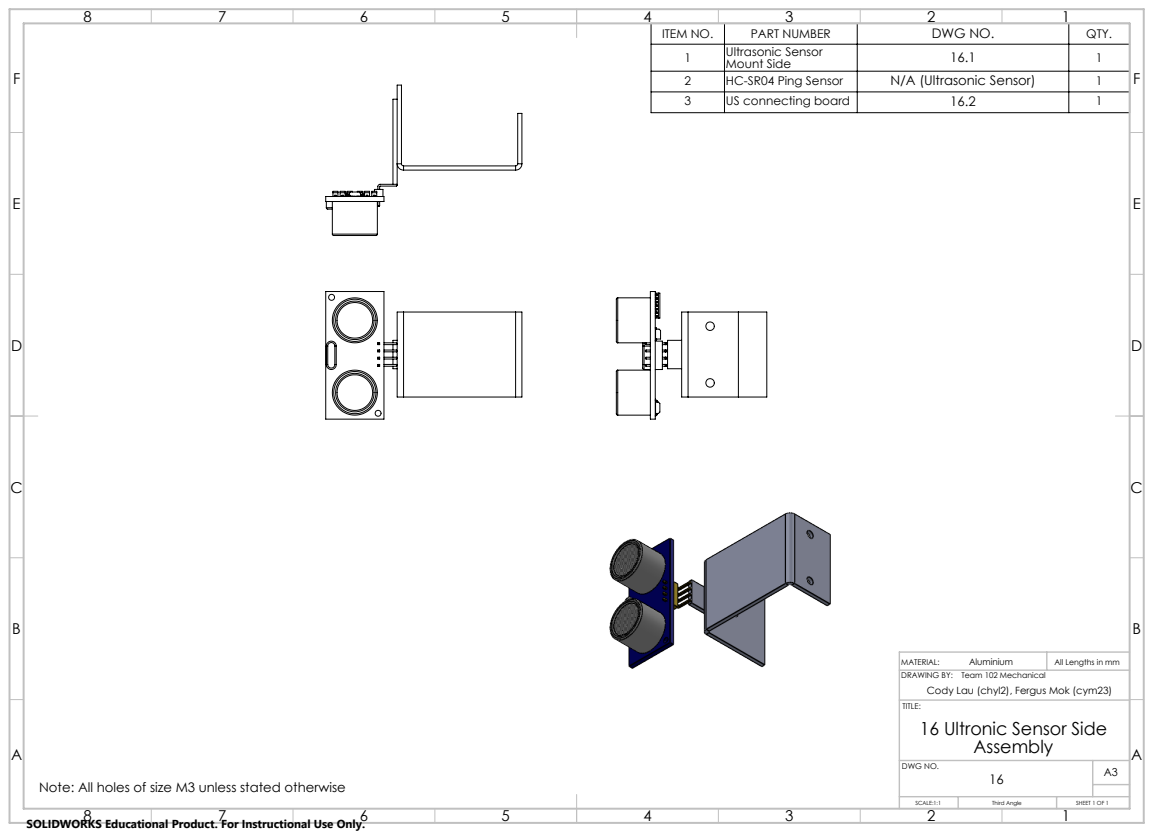
[picture p100: page 1]
MATERIAL:; All Lengths in mm; DWG NO.; SCALE:1:1; SHEET 1 OF 1; Third Angle

ITEM NO. | PART NUMBER | DWG NO. | QTY.
1 | Ultrasonic Sensor Mount Side | 16.1 | 1
2 | HC-SR04 Ping Sensor | N/A (Ultrasonic Sensor) | 1
3 | US connecting board | 16.2 | 1

DRAWING BY: Team 102 Mechanical
Cody Lau (chyl2), Fergus Mok (cym23)
TITLE:
16 Ultronic Sensor Side
Assembly

Note: All holes of size M3 unless stated otherwise
SOLIDWORKS Educational Product. For Instructional Use Only.
