codyhylau/Integrated-Design-Project/IDP CADS FINAL/Drawings temporary/PDFs/19 wall assembly right.PDF

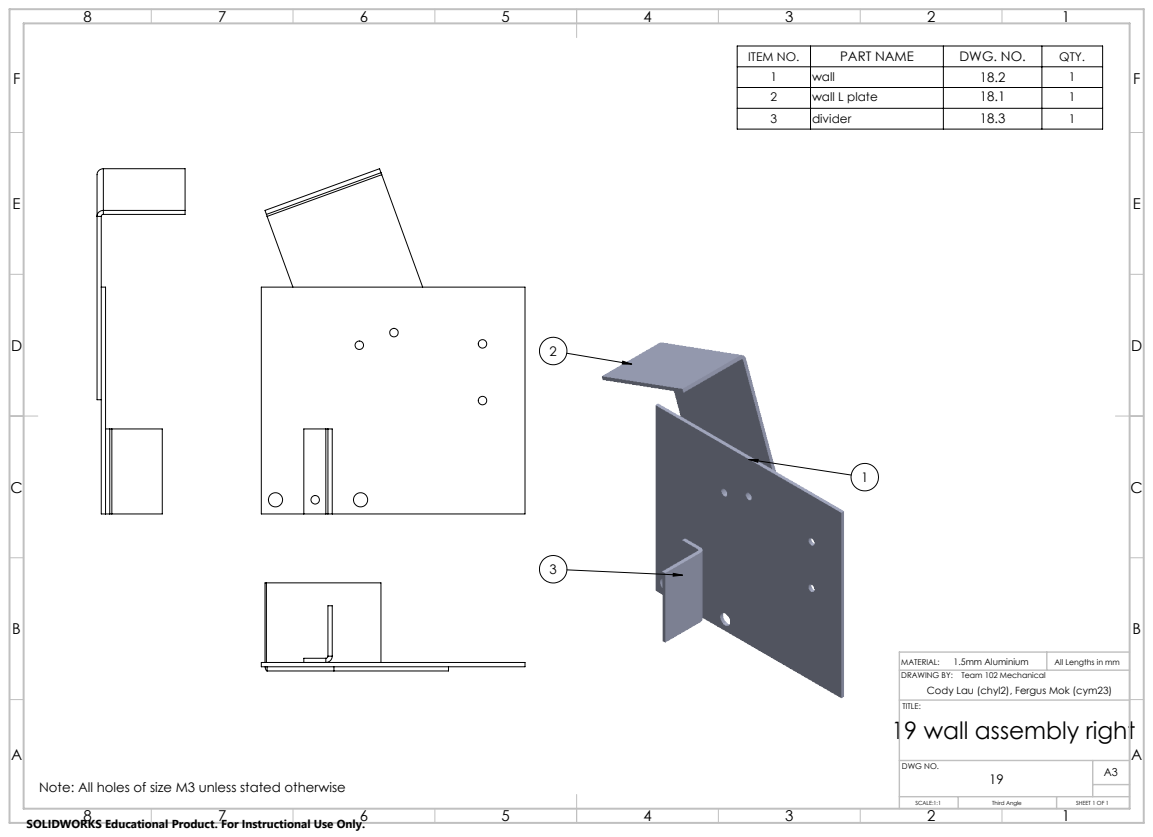
[picture p102: page 1]
MATERIAL:; All Lengths in mm; DWG NO.; SCALE:1:1; SHEET 1 OF 1; Third Angle

ITEM NO. | PART NAME | DWG. NO. | QTY.
1 | wall | 18.2 | 1
2 | wall L plate | 18.1 | 1
3 | divider | 18.3 | 1

1.5mm Aluminium
19 wall assembly right

DRAWING BY: Team 102 Mechanical
Cody Lau (chyl2), Fergus Mok (cym23)
TITLE:

Note: All holes of size M3 unless stated otherwise
SOLIDWORKS Educational Product. For Instructional Use Only.
