codyhylau/Integrated-Design-Project/Final Document M102.pdf

MATERIAL:; All Lengths in mm; DWG NO.; SCALE:1:5; SHEET 1 OF 1; Third Angle

ITEM NO. | PART NAME | DWG NO. | QTY.
1 | Chassis Main | 1 | 1
2 | Ball Castor Mount Left | 2 | 1
3 | Ball Castor Mount Right | 3 | 1
4 | Line Follower mount | 4 | 1
5 | Motor Mount Large | 5 | 2
6 | Motor Mount Small | 6 | 2
7 | Motor-40 | N/A | 2
8 | shelf laser cut | 8 | 1
9 | Shelf mount | 9 | 2
10 | Wheel-100mm | N/A | 2
11 | arm assembly | 11 | 1
12 | Curve Assembly | 12 | 1
13 | LED Panel | 13 | 1
14 | Servo Assembly | N/A | 1
15 | Ultrasonic Sensor Mount Back Assembly | 15 | 1
16 | Ultronic Sensor Side Assembly | 16 | 1
17 | Arm rod support | 17 | 1
18 | wall assembly left | 18 | 1
19 | wall assembly right | 19 | 1
20 | ramp | 20 | 1
21 | Hall Sensor Mount | 21 | 1
22 | ball castor | 22 | 2
23 | Motor-10 | N/A | 1
24 | spur_gear_20 | N/A | 1

Aluminium, Steel, MDF
OVERALL ASSEMBLY

DRAWING BY: Team 102 Mechanical
Cody Lau (chyl2), Fergus Mok (cym23)
TITLE:

SOLIDWORKS Educational Product. For Instructional Use Only.

MATERIAL:; All Lengths in mm; 6mm MDF; 1 Chassis Main

TO BE LASER CUT ON 6mm MDF

DRAWING BY: Team 102 Mechanical
Cody Lau (chyl2), Fergus Mok (cym23)
TITLE:

Note: All holes of size M3 unless otherwise stated

DWG NO.

SCALE:1:2 | SHEET 1 OF 1

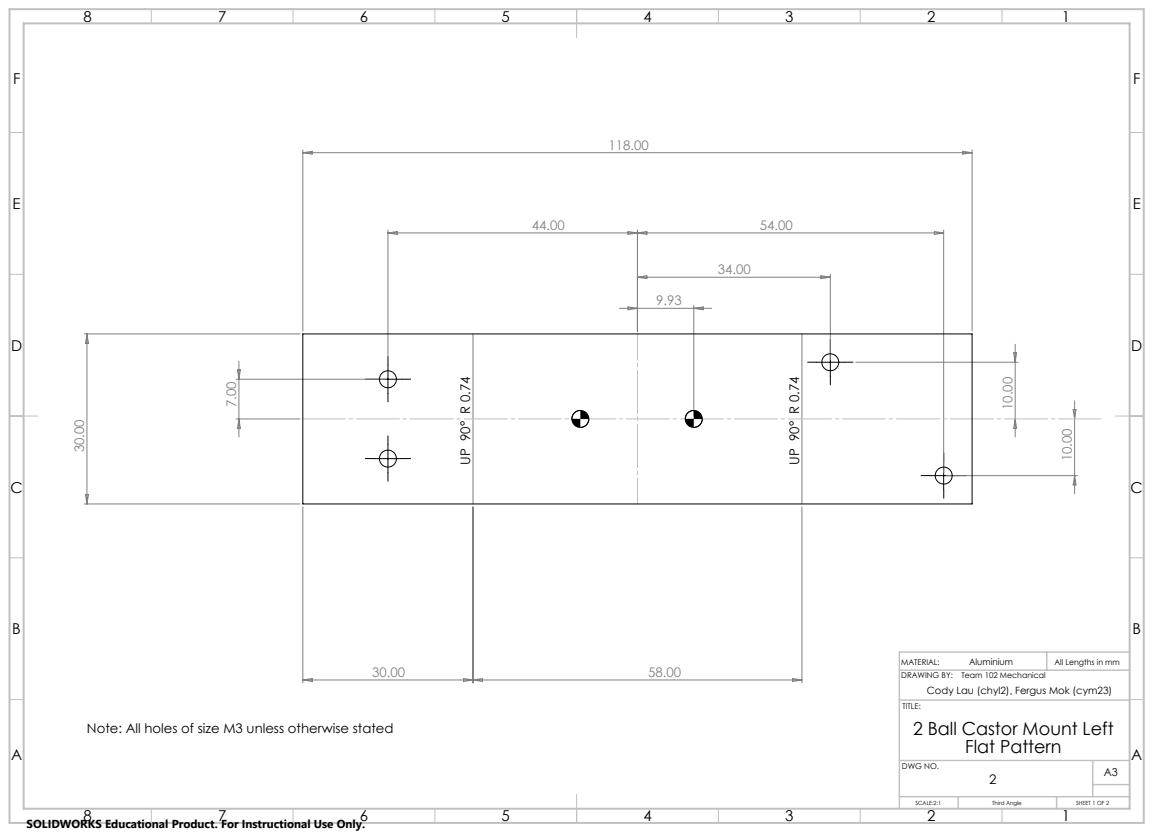
[picture p103: page 3]
MATERIAL:; All Lengths in mm

DRAWING BY: Team 102 Mechanical
Cody Lau (chyl2), Fergus Mok (cym23)
TITLE:
2 Ball Castor Mount Left
Flat Pattern

Note: All holes of size M3 unless otherwise stated

DWG NO.

SCALE:2:1 | SHEET 1 OF 2

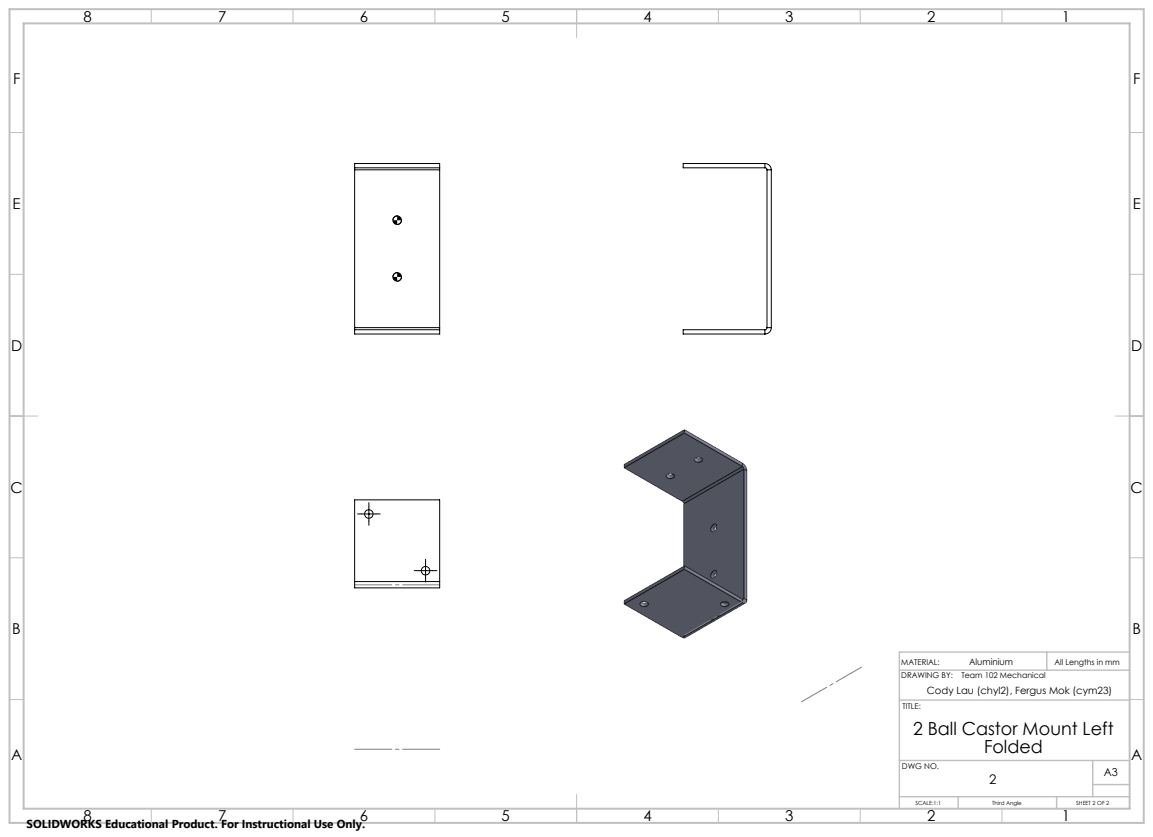
[picture p104: page 4]
MATERIAL:; All Lengths in mm

DRAWING BY: Team 102 Mechanical
Cody Lau (chyl2), Fergus Mok (cym23)
TITLE:
2 Ball Castor Mount Left
Folded

DWG NO.

SCALE:1:1 | SHEET 2 OF 2

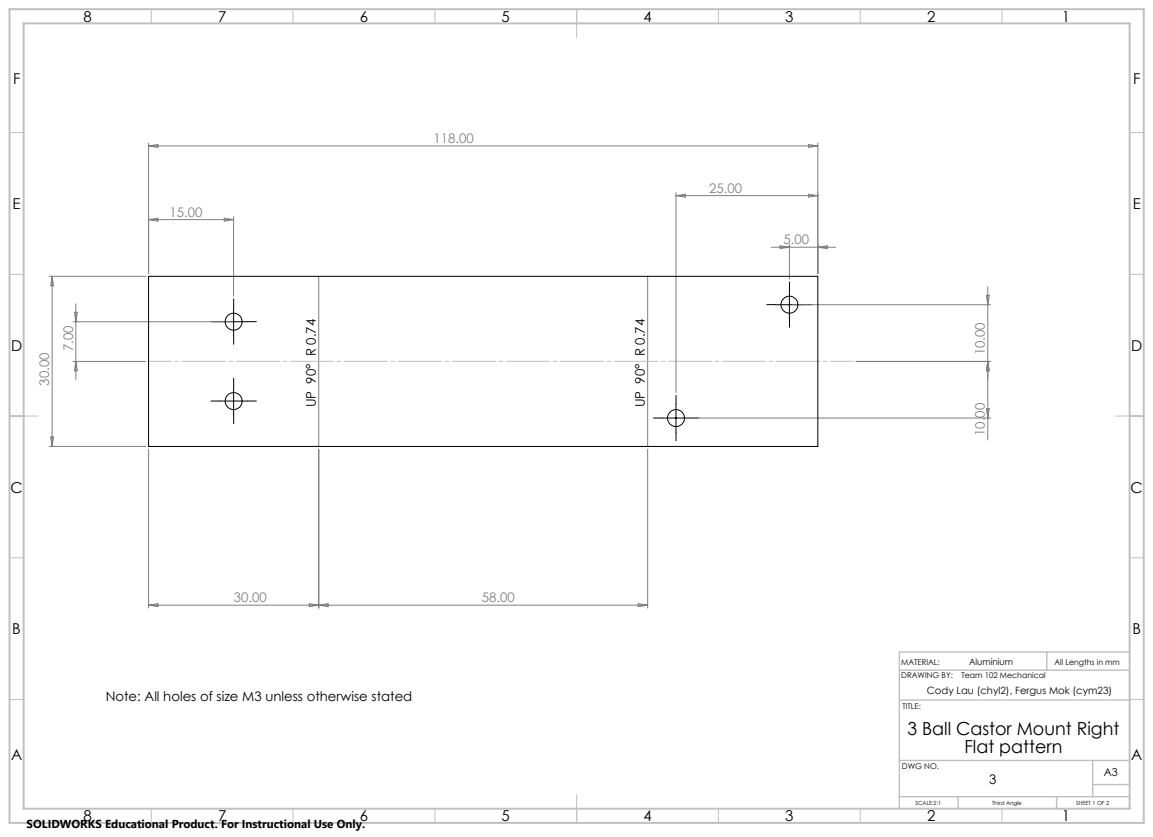
[picture p105: page 5]
MATERIAL:; All Lengths in mm; DWG NO.

DRAWING BY: Team 102 Mechanical
Cody Lau (chyl2), Fergus Mok (cym23)
TITLE:
3 Ball Castor Mount Right
Flat pattern

Note: All holes of size M3 unless otherwise stated

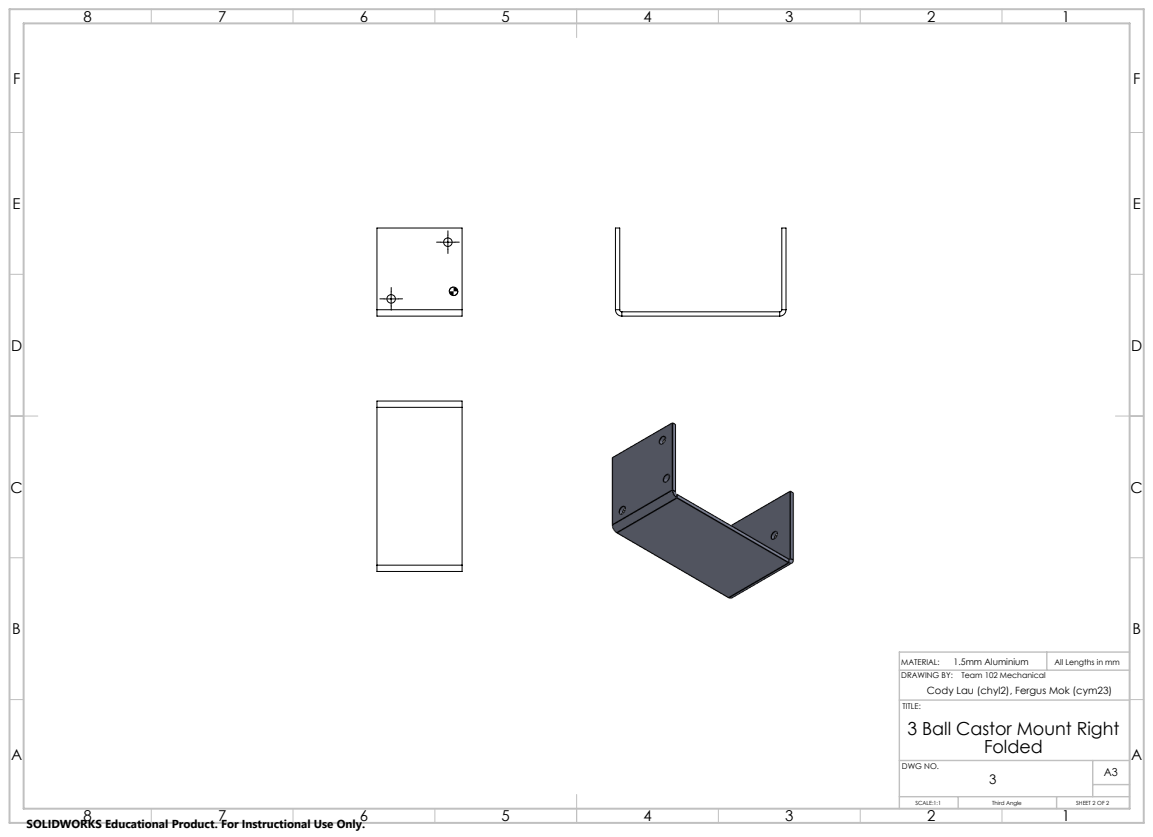
[picture p106: page 6]
MATERIAL:; All Lengths in mm; 1.5mm Aluminium

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

DWG NO.

SCALE:1:1 | SHEET 2 OF 2

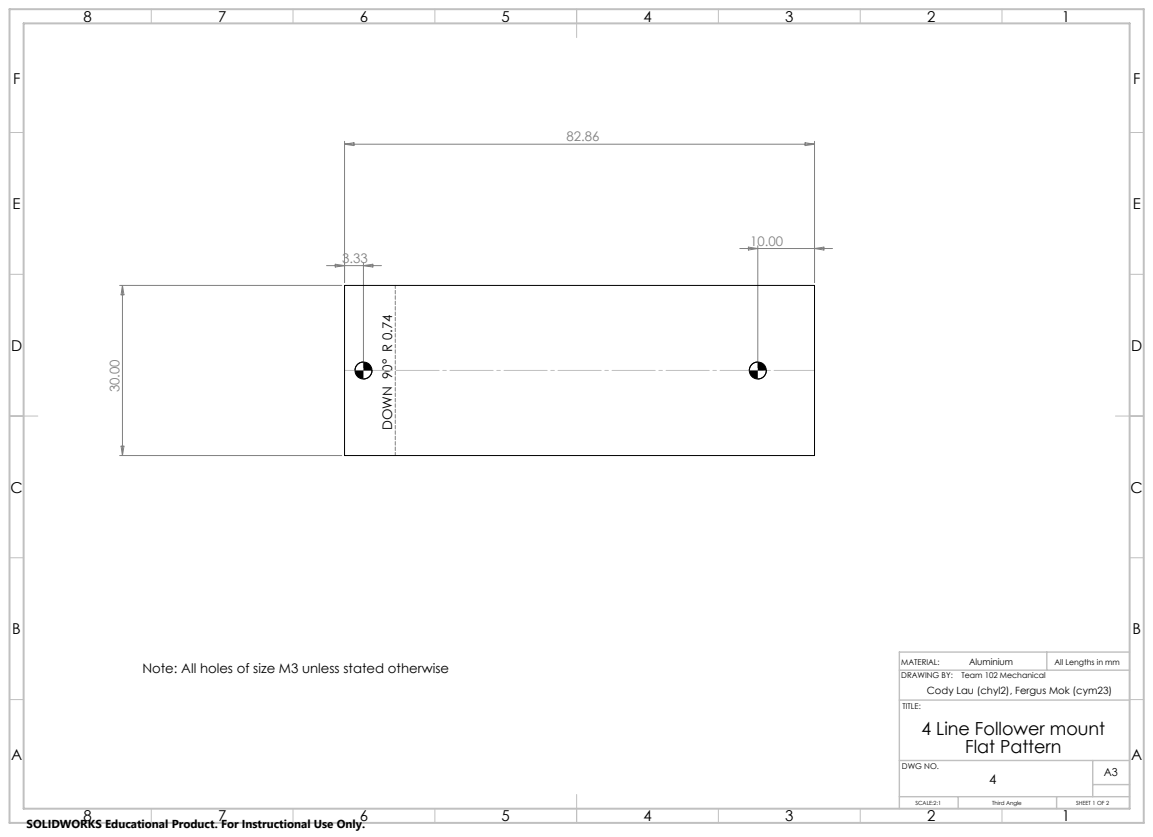
[picture p107: page 7]
DOWN 90° R 0.74; MATERIAL:; All Lengths in mm; DWG NO.

Note: All holes of size M3 unless stated otherwise

DRAWING BY: Team 102 Mechanical
Cody Lau (chyl2), Fergus Mok (cym23)
TITLE:
4 Line Follower mount
Flat Pattern

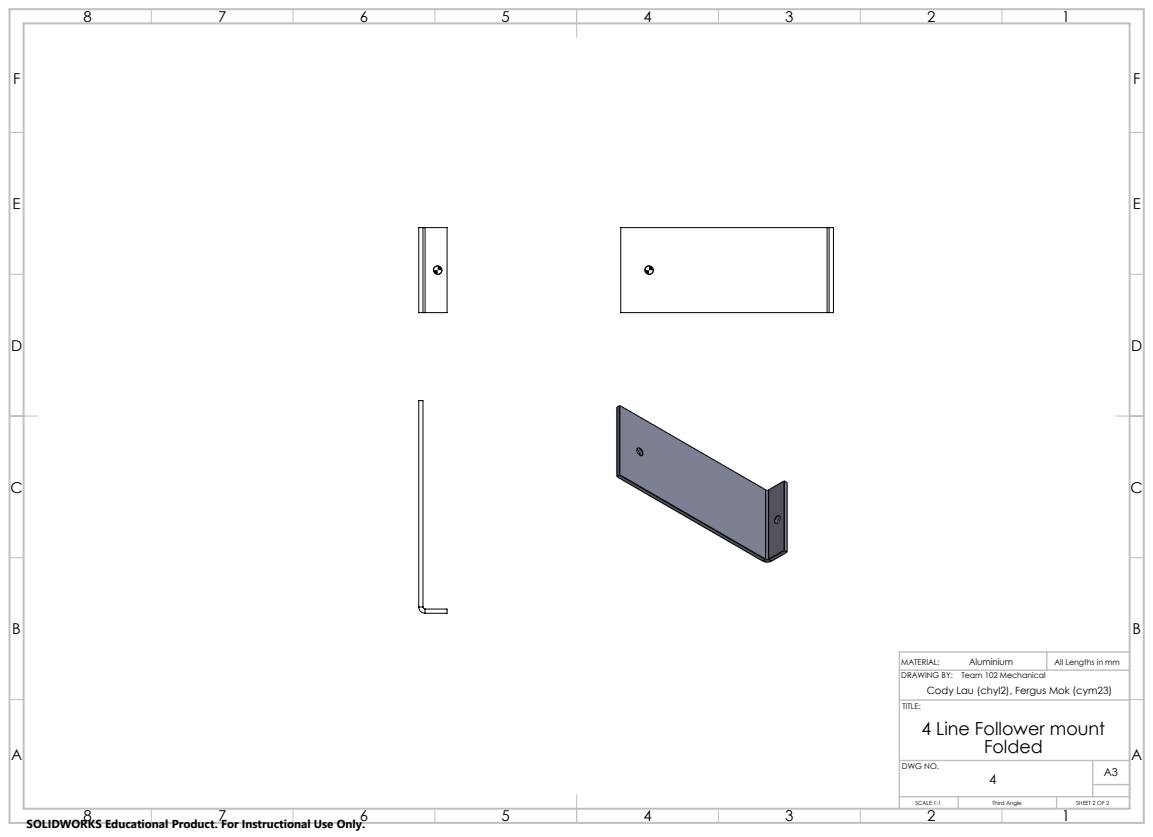
[picture p108: page 8]
MATERIAL:; All Lengths in mm

DRAWING BY: Team 102 Mechanical
Cody Lau (chyl2), Fergus Mok (cym23)
TITLE:
4 Line Follower mount
Folded

DWG NO.

SCALE:1:1 | SHEET 2 OF 2

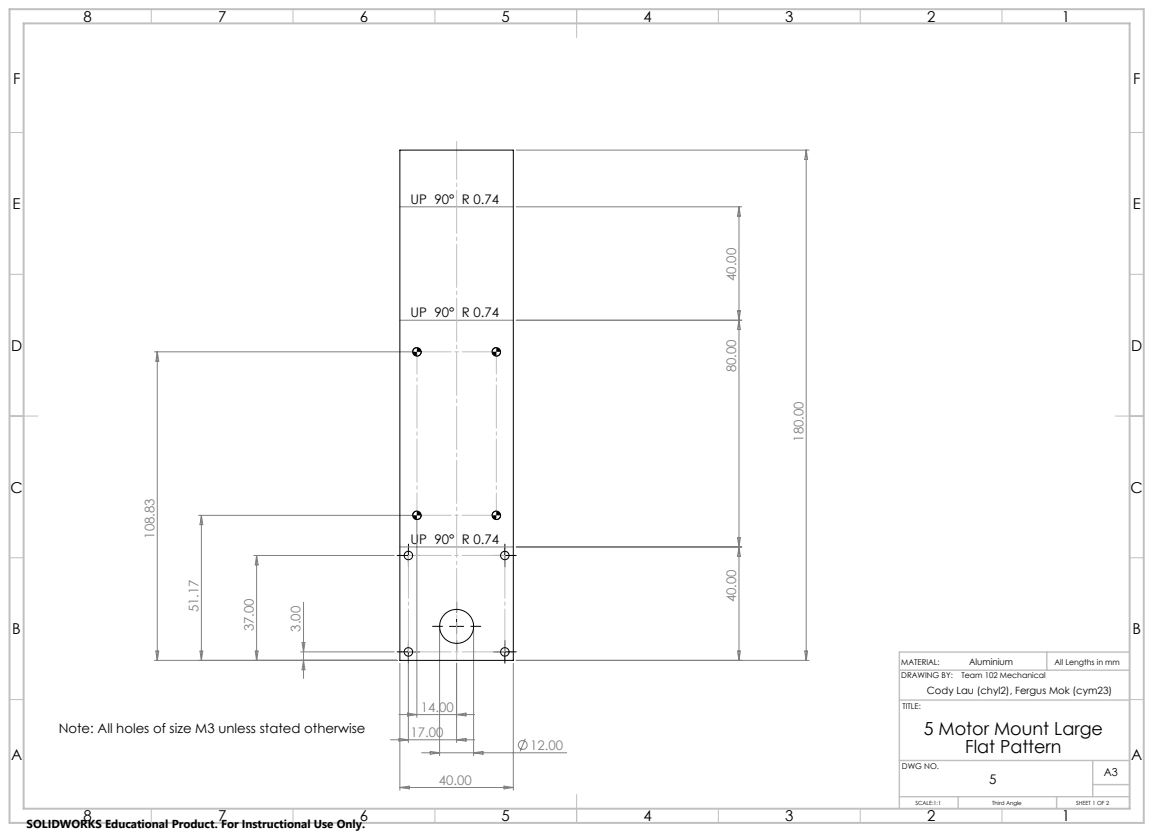
[picture p109: page 9]
MATERIAL:; All Lengths in mm

DRAWING BY: Team 102 Mechanical
Cody Lau (chyl2), Fergus Mok (cym23)
TITLE:
5 Motor Mount Large
Flat Pattern

Note: All holes of size M3 unless stated otherwise

DWG NO.

SCALE:1:1 | SHEET 1 OF 2

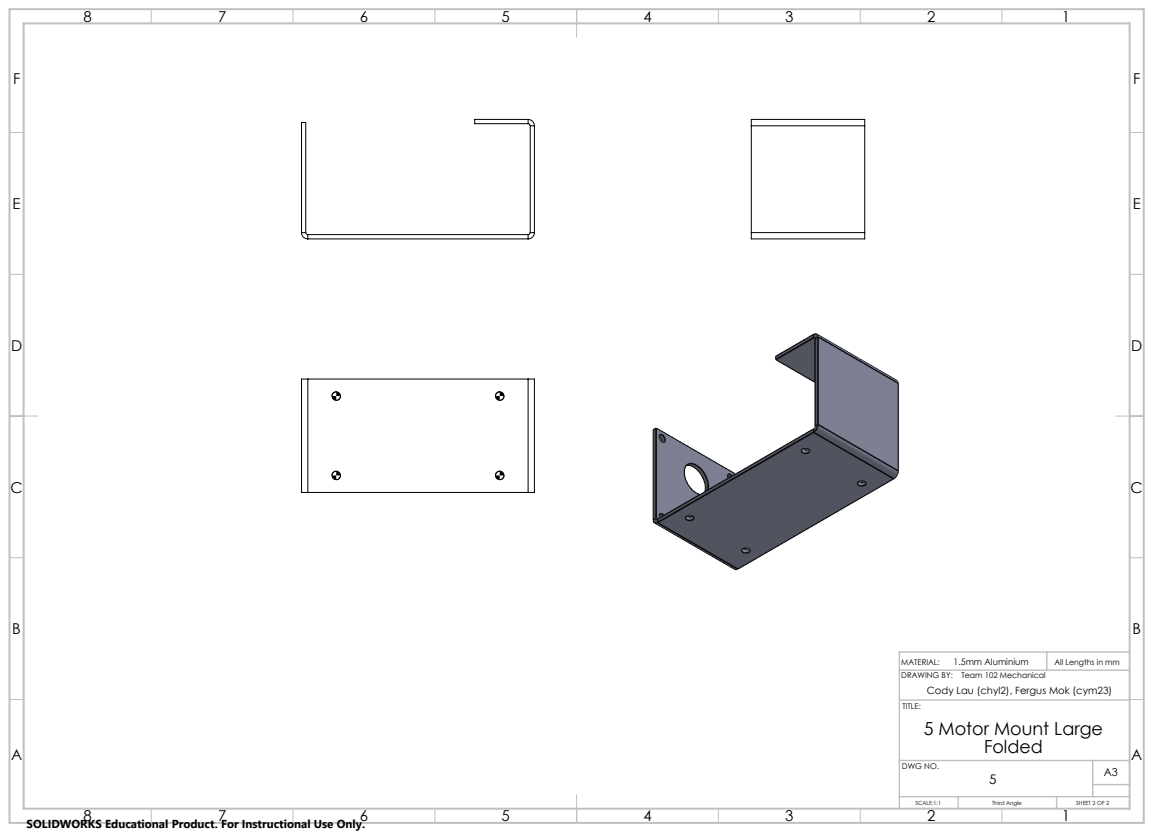
[picture p110: page 10]
MATERIAL:; All Lengths in mm; 1.5mm Aluminium

DRAWING BY: Team 102 Mechanical
Cody Lau (chyl2), Fergus Mok (cym23)
TITLE:
5 Motor Mount Large
Folded

DWG NO.

SCALE:1:1 | SHEET 2 OF 2

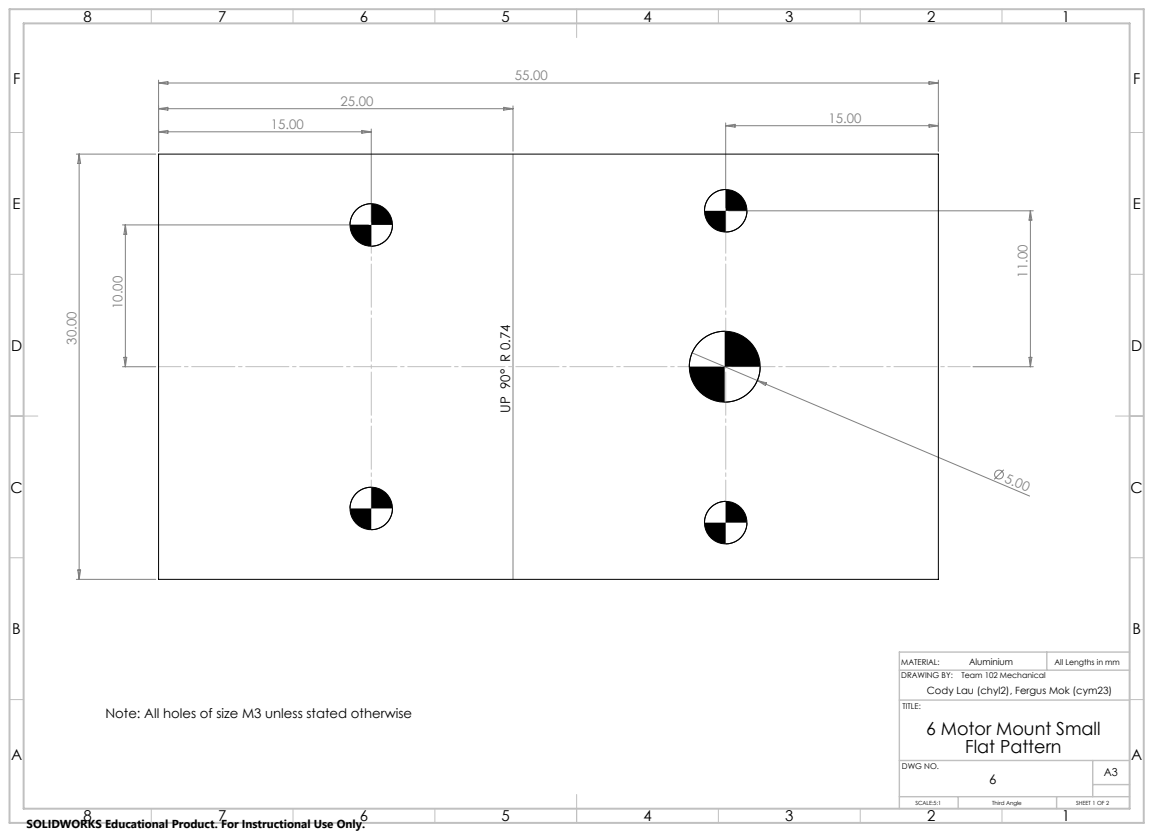
[picture p111: page 11]
MATERIAL:; All Lengths in mm

DRAWING BY: Team 102 Mechanical
Cody Lau (chyl2), Fergus Mok (cym23)
TITLE:
6 Motor Mount Small
Flat Pattern

Note: All holes of size M3 unless stated otherwise

DWG NO.

SCALE:5:1 | SHEET 1 OF 2

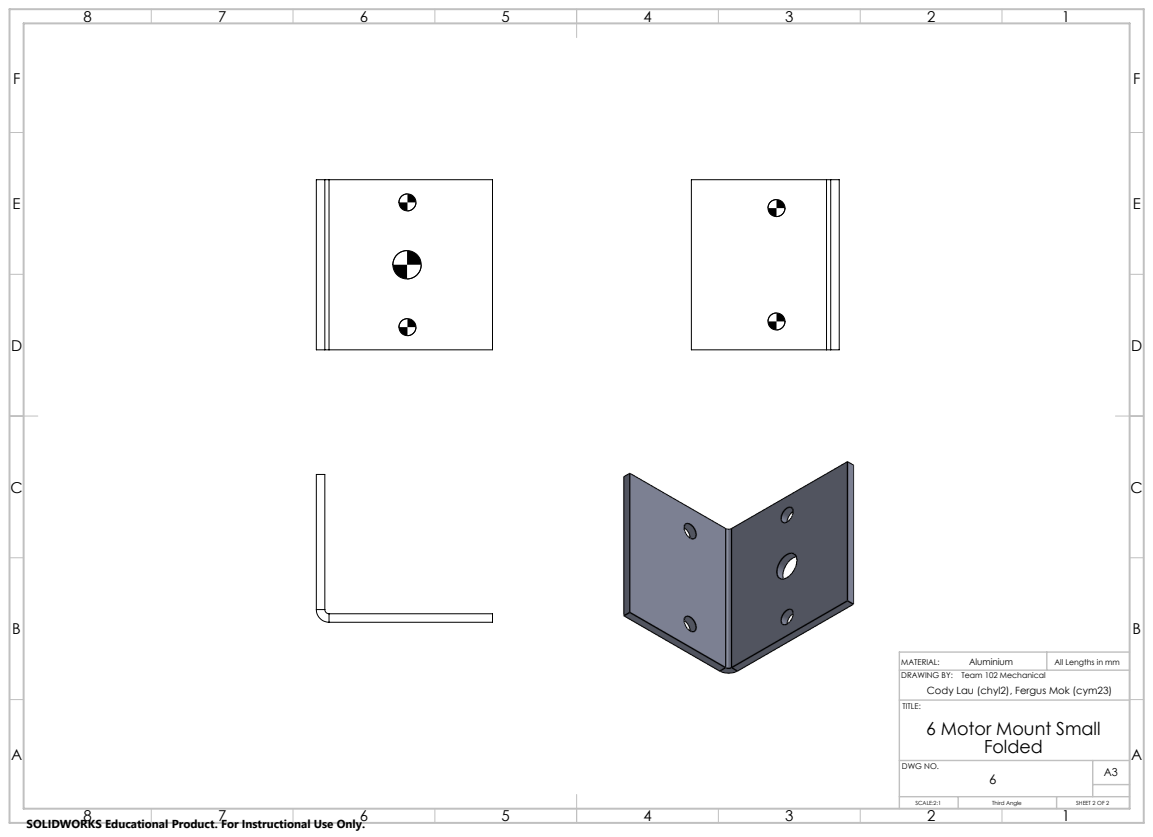
[picture p112: page 12]
MATERIAL:; All Lengths in mm; DWG NO.

DRAWING BY: Team 102 Mechanical
Cody Lau (chyl2), Fergus Mok (cym23)
TITLE:
6 Motor Mount Small
Folded

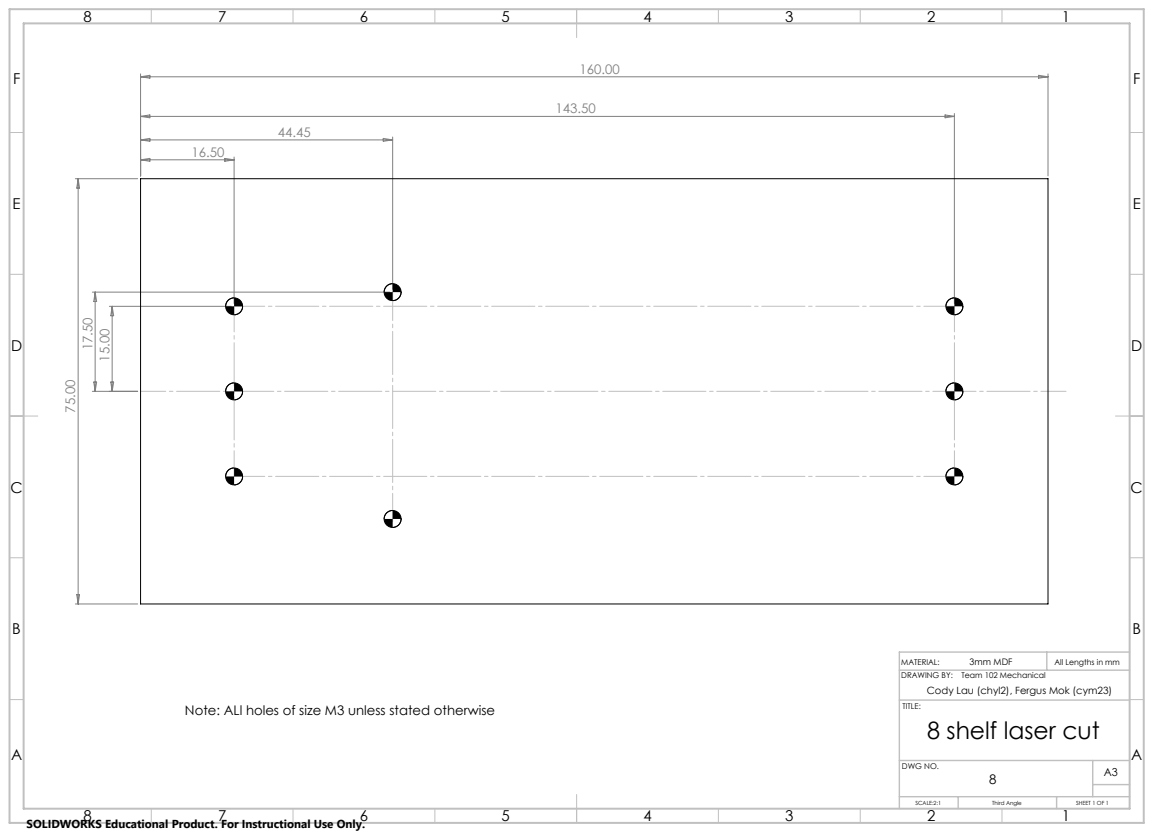
[picture p113: page 13]
MATERIAL:; All Lengths in mm; DWG NO.

3mm MDF
8 shelf laser cut

DRAWING BY: Team 102 Mechanical
Cody Lau (chyl2), Fergus Mok (cym23)
TITLE:

Note: ALl holes of size M3 unless stated otherwise

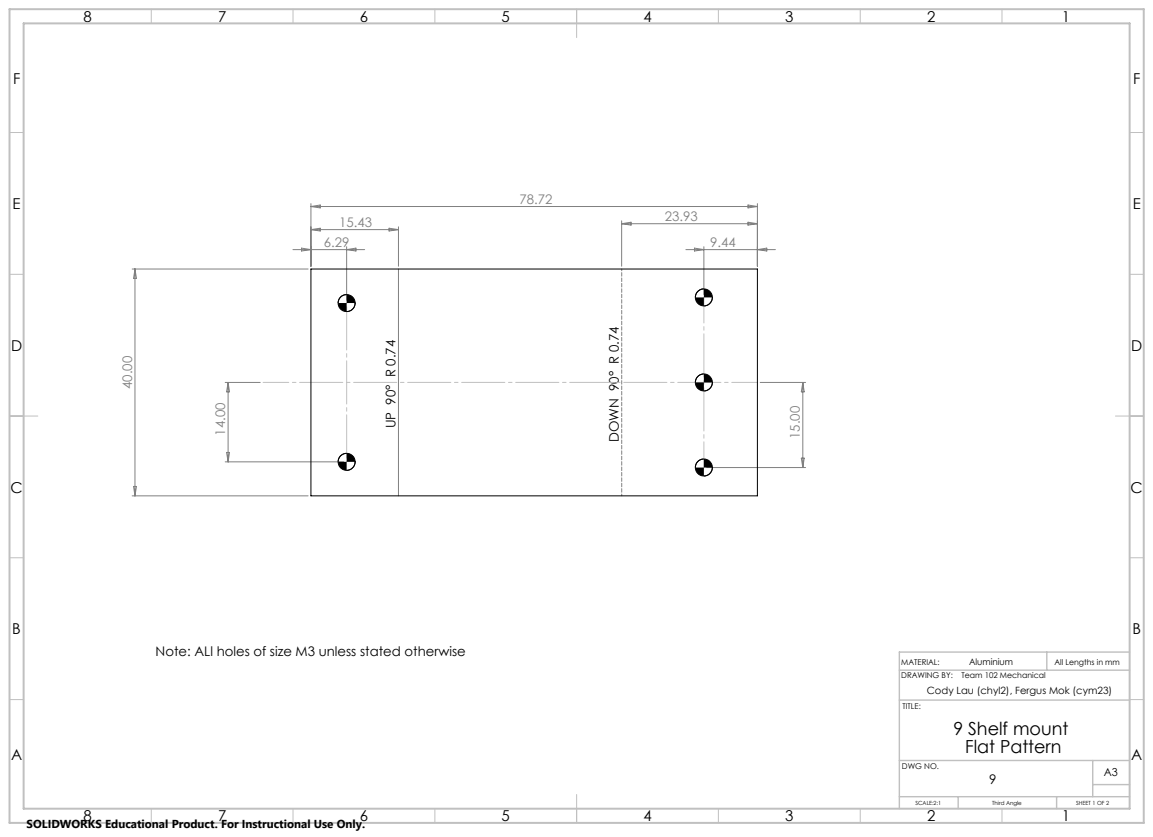
[picture p114: page 14]
DOWN 90° R 0.74; MATERIAL:; All Lengths in mm; DWG NO.

Note: ALl holes of size M3 unless stated otherwise

DRAWING BY: Team 102 Mechanical
Cody Lau (chyl2), Fergus Mok (cym23)
TITLE:
9 Shelf mount
Flat Pattern

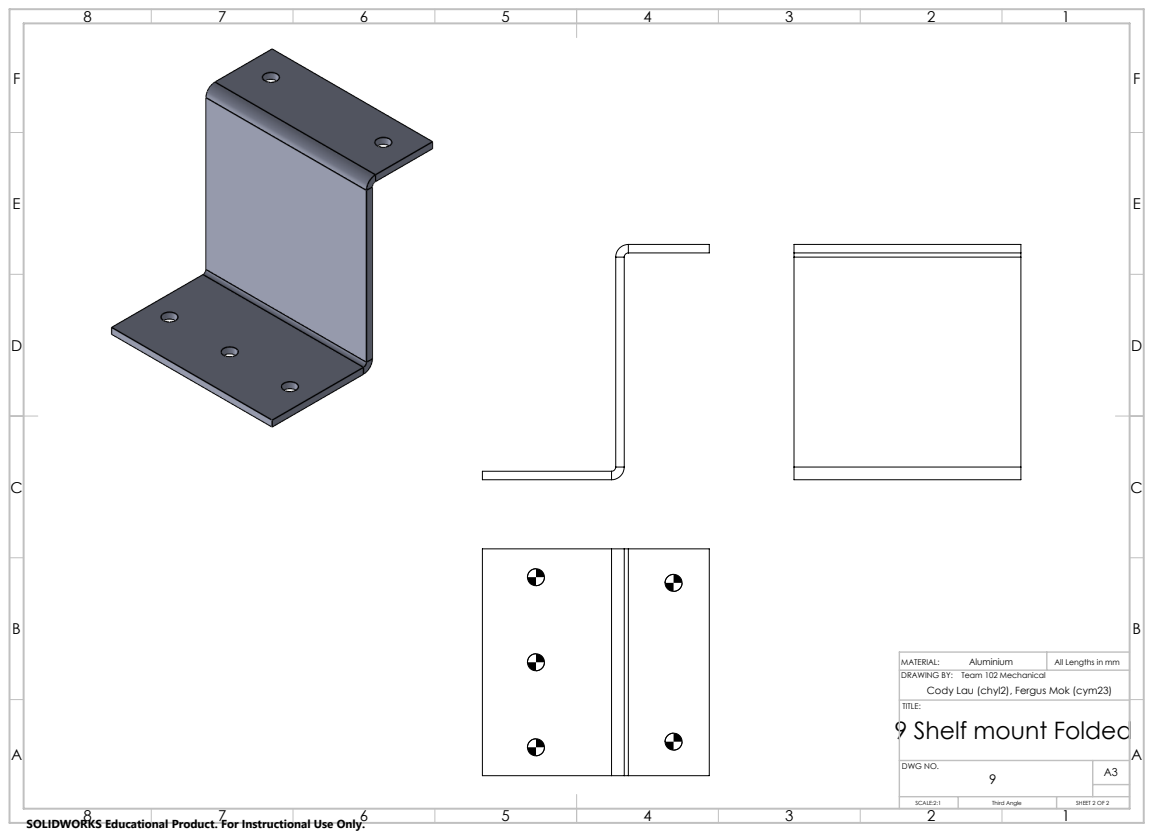
[picture p115: page 15]
MATERIAL:; All Lengths in mm; DWG NO.

Aluminium
9 Shelf mount Folded

DRAWING BY: Team 102 Mechanical
Cody Lau (chyl2), Fergus Mok (cym23)
TITLE:

MATERIAL:; All Lengths in mm; Aluminium, Steel; 11 arm assembly

ITEM NO. | PART NUMBER | DWG NO. | QTY.
1 | arm main plate | 11.1 | 1
2 | arm axle | 11.2 | 1
3 | arm L plate | 11.3 | 1
4 | B18.3.1M - 3 x 0.5 x 8 Hex SHCS -- 8NHX | N/A | 2

E | 5 | B18.2.4.1M - Hex nut, Style 1, M3 x 0.5 --D-N | N/A | 2 | E

6 | spur_gear_20 | N/A | 1

DRAWING BY: Team 102 Mechanical
Cody Lau (chyl2), Fergus Mok (cym23)
TITLE:

DWG NO.

SCALE:1:2 | SHEET 1 OF 1

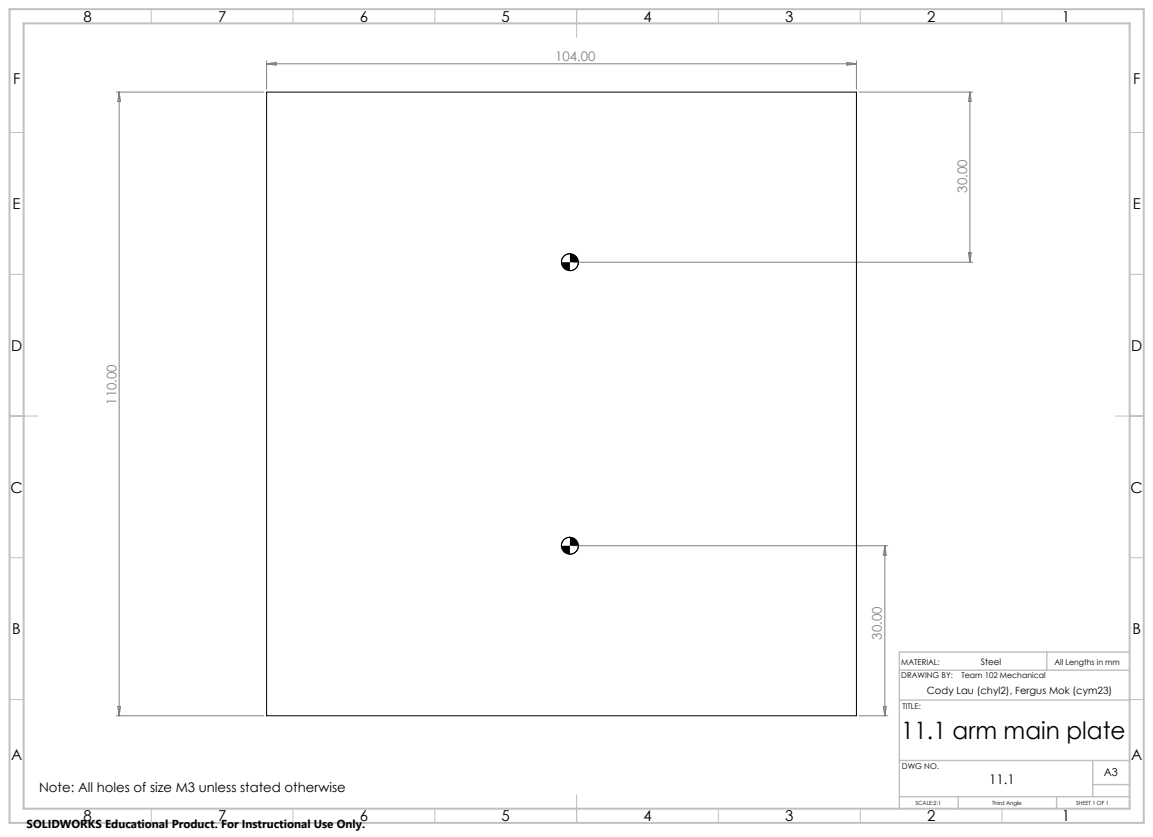
[picture p116: page 17]
MATERIAL:; All Lengths in mm; DWG NO.

Steel
11.1 arm main plate

DRAWING BY: Team 102 Mechanical
Cody Lau (chyl2), Fergus Mok (cym23)
TITLE:

Note: All holes of size M3 unless stated otherwise

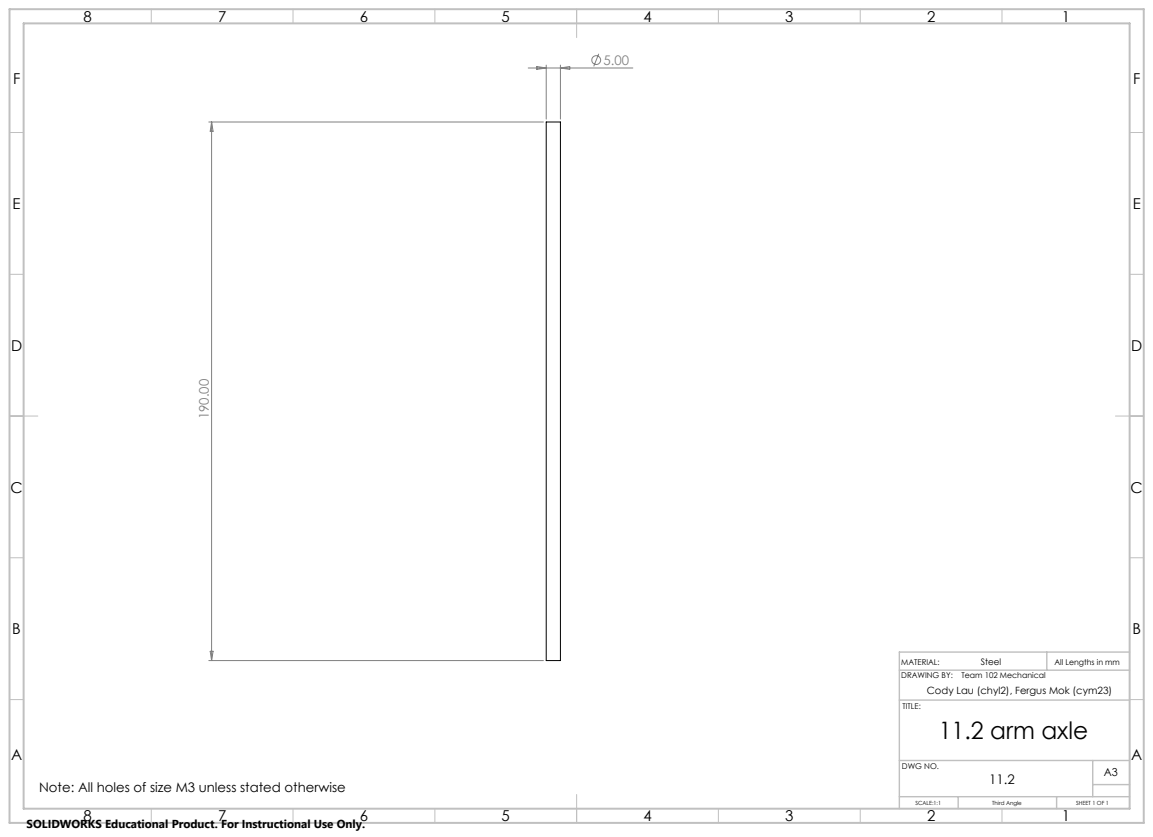
[picture p117: page 18]
MATERIAL:; All Lengths in mm; 11.2 arm axle

DRAWING BY: Team 102 Mechanical
Cody Lau (chyl2), Fergus Mok (cym23)
TITLE:

DWG NO.

SCALE:1:1 | SHEET 1 OF 1

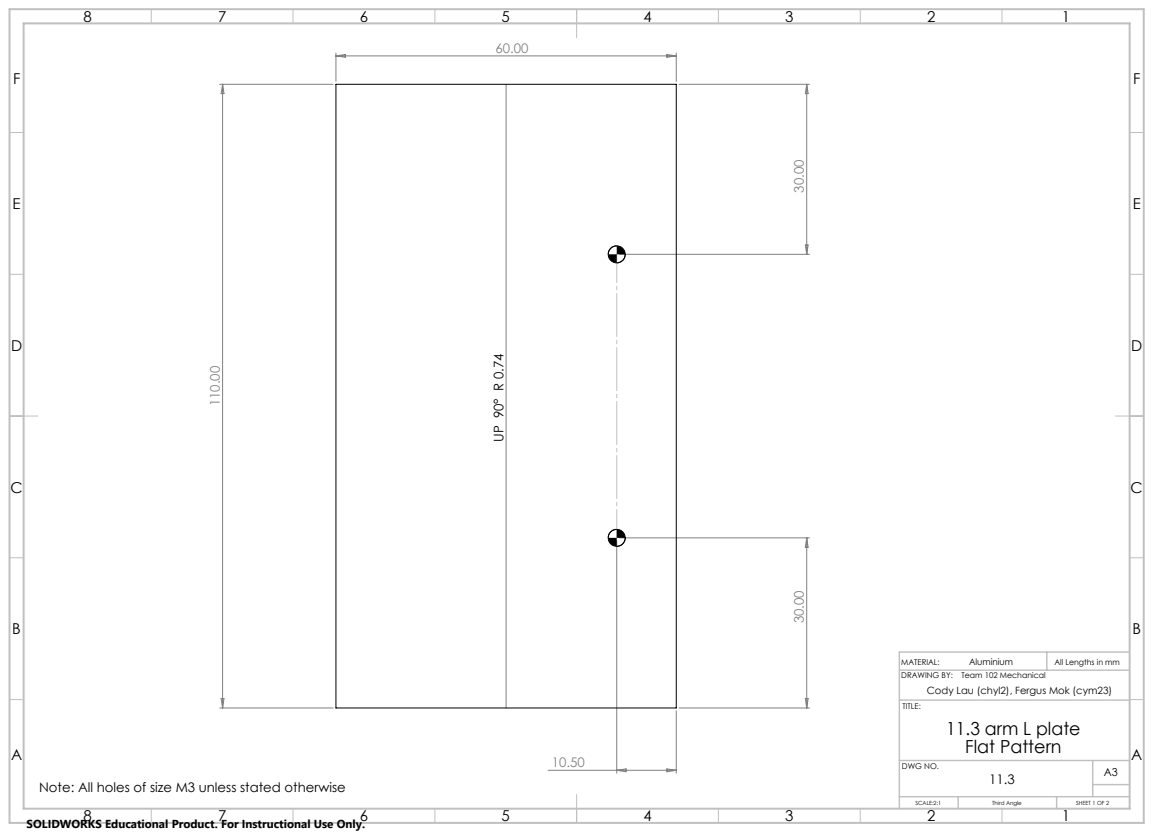
[picture p118: page 19]
MATERIAL:; All Lengths in mm; DWG NO.

DRAWING BY: Team 102 Mechanical
Cody Lau (chyl2), Fergus Mok (cym23)
TITLE:
11.3 arm L plate
Flat Pattern

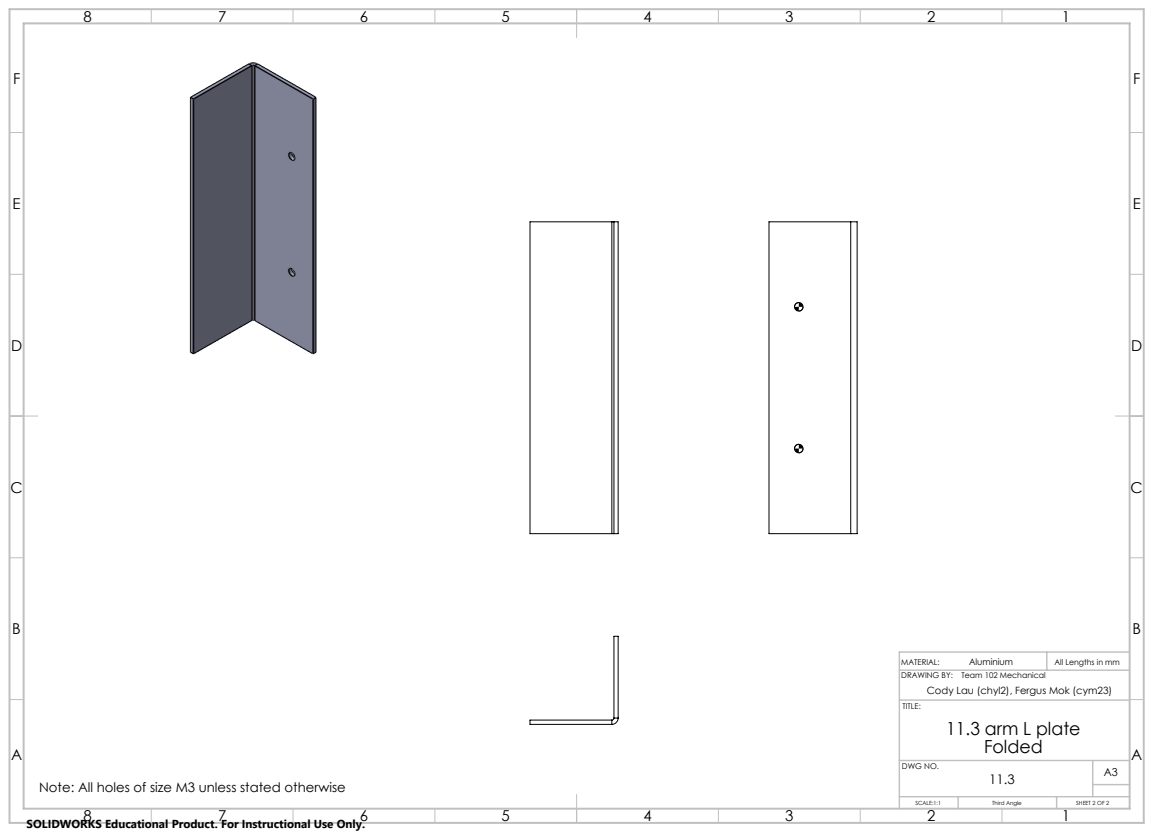
[picture p119: page 20]
MATERIAL:; All Lengths in mm

DRAWING BY: Team 102 Mechanical
Cody Lau (chyl2), Fergus Mok (cym23)
TITLE:
11.3 arm L plate
Folded

DWG NO.

SCALE:1:1 | SHEET 2 OF 2

MATERIAL:; All Lengths in mm; 12 Curve Assembly

ITEM NO. | PART NUMBER | DWG NO. | QTY.
1 | Curve | 12.1 | 1
2 | Curve L | 12.2 | 1
3 | B18.3.1M - 2.5 x 0.45 x 5 Hex SHCS -- 5NHX | N/A | 2
4 | B18.2.4.1M - Hex nut, Style 1, M2.5 x 0.45 --D-N | N/A | 2

DRAWING BY: Team 102 Mechanical
Cody Lau (chyl2), Fergus Mok (cym23)
TITLE:

DWG NO.

SCALE:1:2 | SHEET 1 OF 1

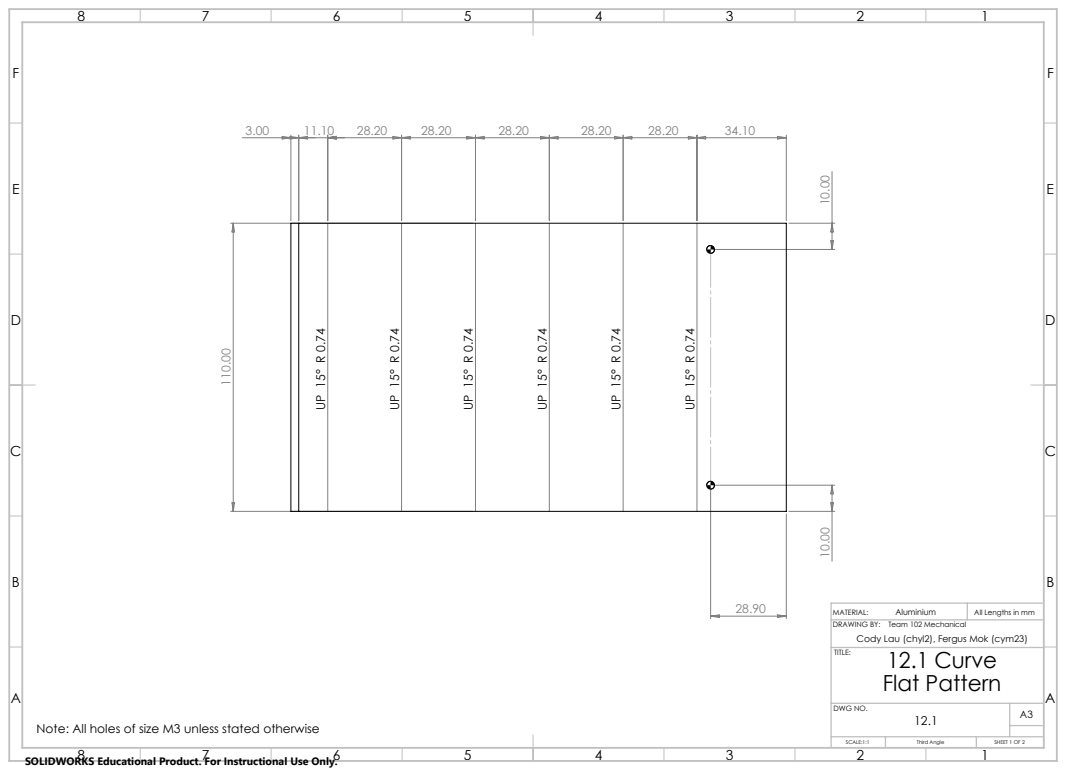
[picture p120: page 22]
MATERIAL:; All Lengths in mm; 12.1 Curve Flat Pattern

DRAWING BY: Team 102 Mechanical
Cody Lau (chyl2), Fergus Mok (cym23)
TITLE:

DWG NO.

SCALE:1:1 | SHEET 1 OF 2

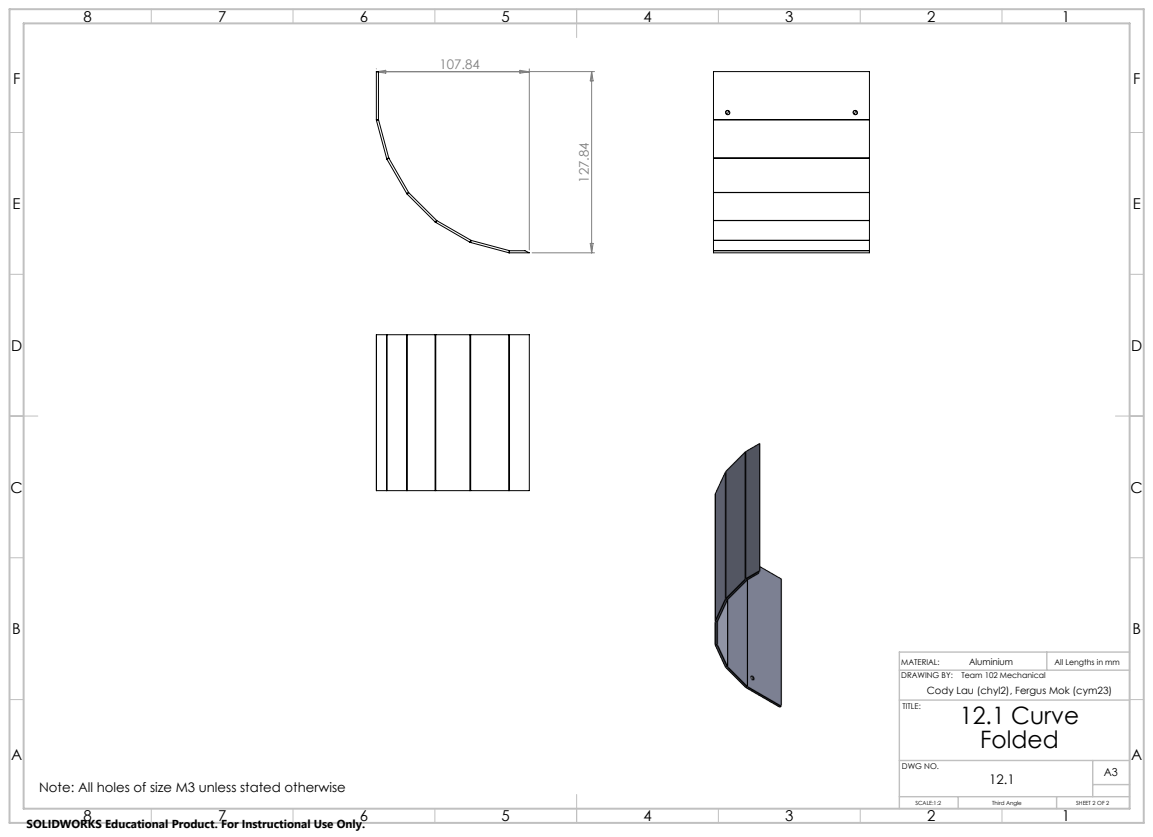
[picture p121: page 23]
MATERIAL:; All Lengths in mm; 12.1 Curve

DRAWING BY: Team 102 Mechanical
Cody Lau (chyl2), Fergus Mok (cym23)
TITLE:

DWG NO.

SCALE:1:2 | SHEET 2 OF 2

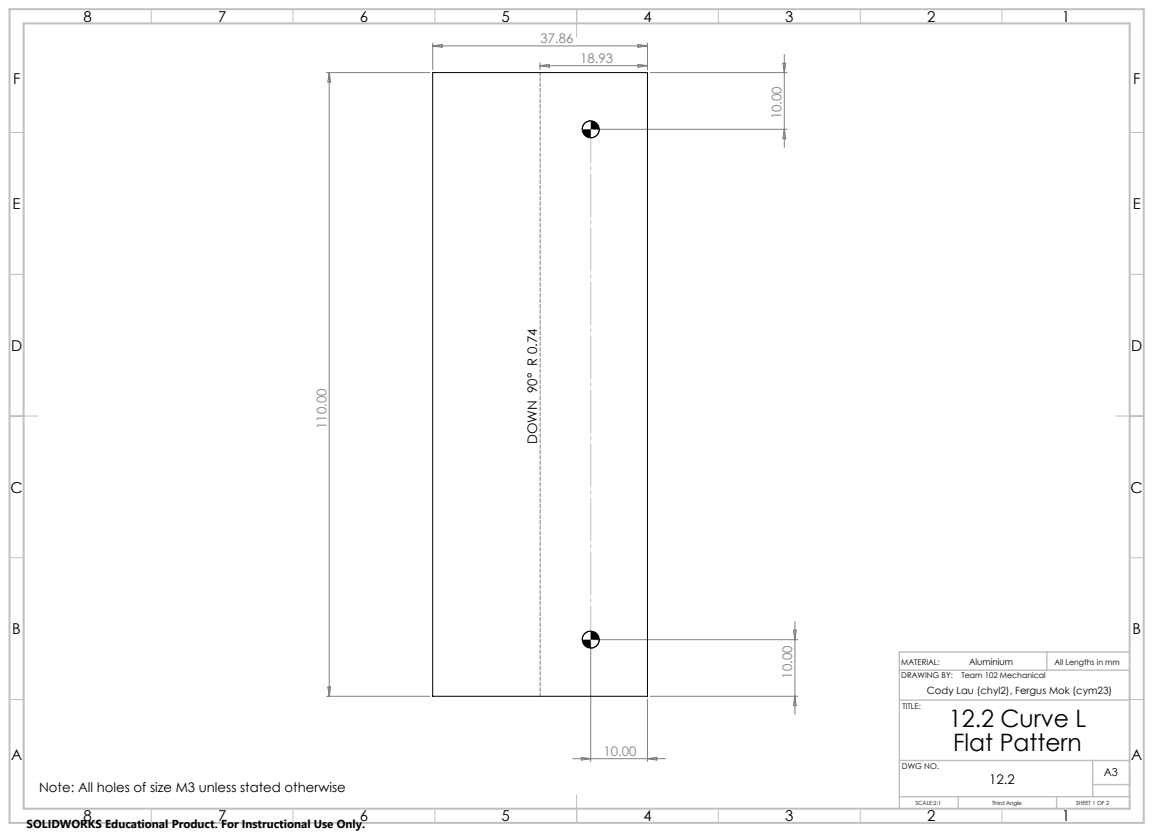
[picture p122: page 24]
DOWN 90° R 0.74; MATERIAL:; All Lengths in mm; DWG NO.; 12.2 Curve L Flat Pattern

DRAWING BY: Team 102 Mechanical
Cody Lau (chyl2), Fergus Mok (cym23)
TITLE:

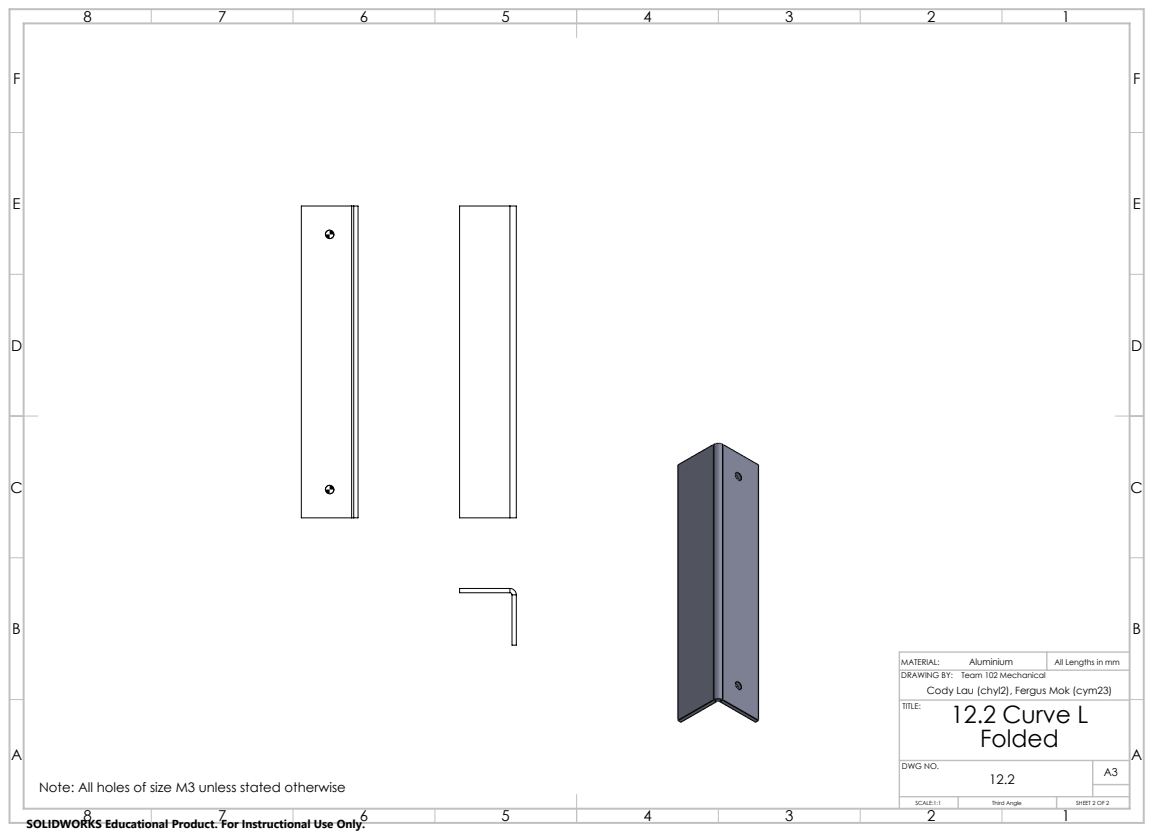
[picture p123: page 25]
MATERIAL:; All Lengths in mm; 12.2 Curve L

DRAWING BY: Team 102 Mechanical
Cody Lau (chyl2), Fergus Mok (cym23)
TITLE:

DWG NO.

SCALE:1:1 | SHEET 2 OF 2

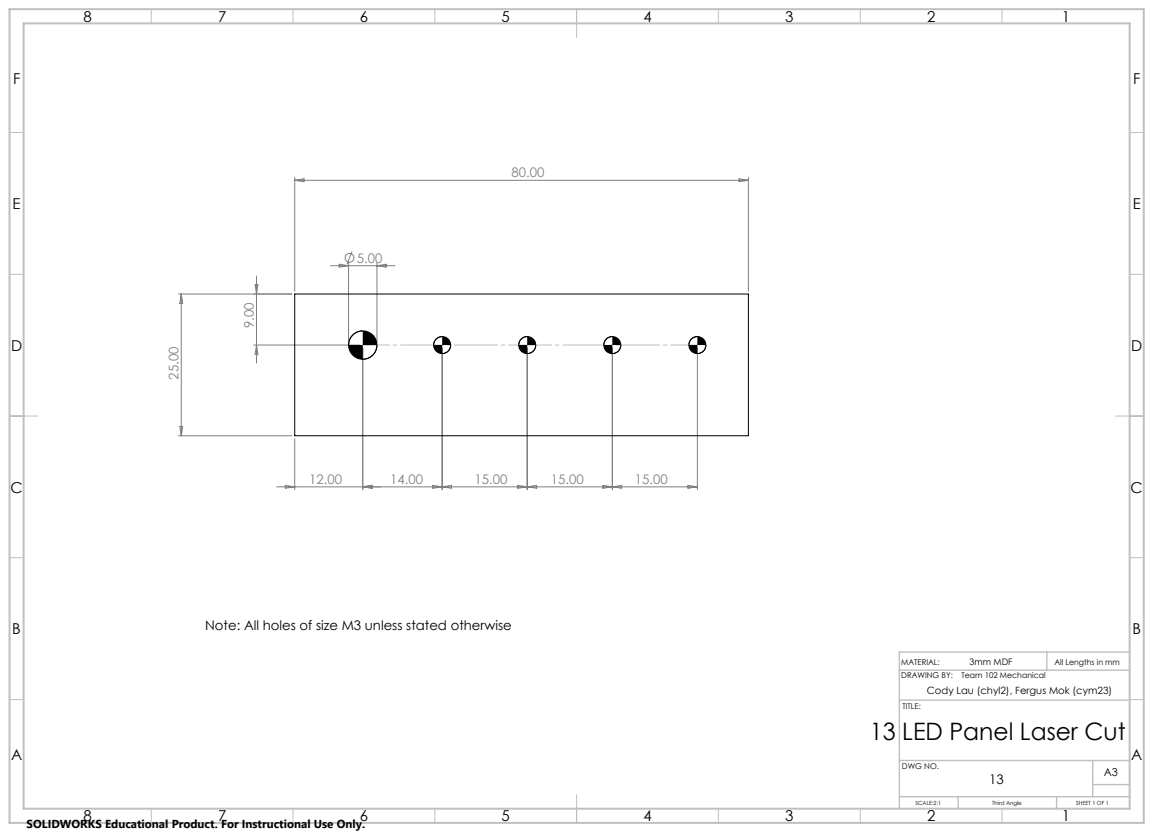
[picture p124: page 26]
MATERIAL:; All Lengths in mm; DWG NO.; 3mm MDF

Note: All holes of size M3 unless stated otherwise

DRAWING BY: Team 102 Mechanical
Cody Lau (chyl2), Fergus Mok (cym23)
TITLE:
13 LED Panel Laser Cut

MATERIAL:; All Lengths in mm; Aluminium, Plastic

ITEM NO. | PART NUMBER | DWG NO. | QTY.
1 | Ultrasonic Sensor Mount Back | 15.1 | 1
2 | US connecting board | 15.2 | 1
3 | HC-SR04 Ping Sensor | N/A (Ultrasonic Sensor) | 1
4 | Gear Rack | N/A | 1

DRAWING BY: Team 102 Mechanical
Cody Lau (chyl2), Fergus Mok (cym23)
TITLE:
15 Ultrasonic Sensor Mount
Back Assembly

DWG NO.

SCALE:1:2 | SHEET 1 OF 1

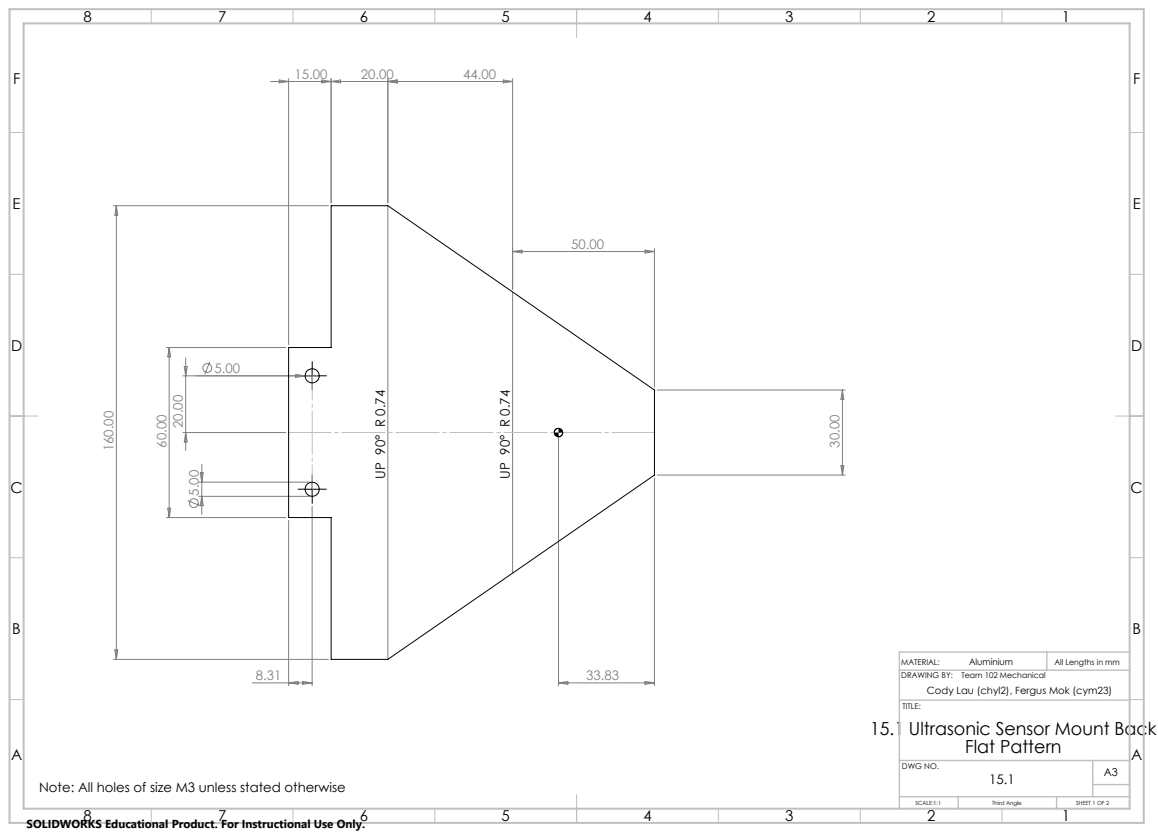
[picture p125: page 28]
MATERIAL:; All Lengths in mm; Flat Pattern

DRAWING BY: Team 102 Mechanical
Cody Lau (chyl2), Fergus Mok (cym23)
TITLE:
15.1 Ultrasonic Sensor Mount Back

DWG NO.

SCALE:1:1 | SHEET 1 OF 2

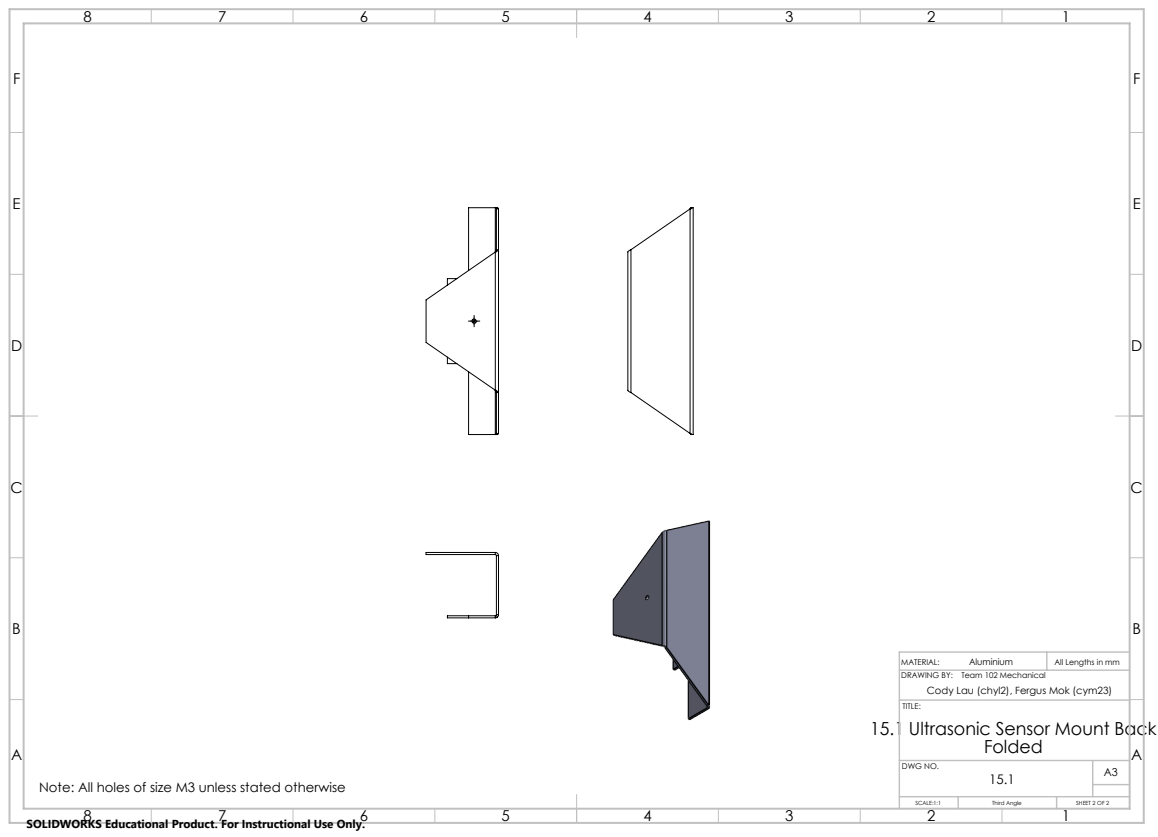
[picture p126: page 29]
MATERIAL:; All Lengths in mm

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

DWG NO.

SCALE:1:1 | SHEET 2 OF 2

MATERIAL:; All Lengths in mm

ITEM NO. | PART NUMBER | DWG NO. | QTY.
1 | Ultrasonic Sensor Mount Side | 16.1 | 1
2 | HC-SR04 Ping Sensor | N/A (Ultrasonic Sensor) | 1
3 | US connecting board | 16.2 | 1

DRAWING BY: Team 102 Mechanical
Cody Lau (chyl2), Fergus Mok (cym23)
TITLE:
16 Ultronic Sensor Side
Assembly

DWG NO.

SCALE:1:1 | SHEET 1 OF 1

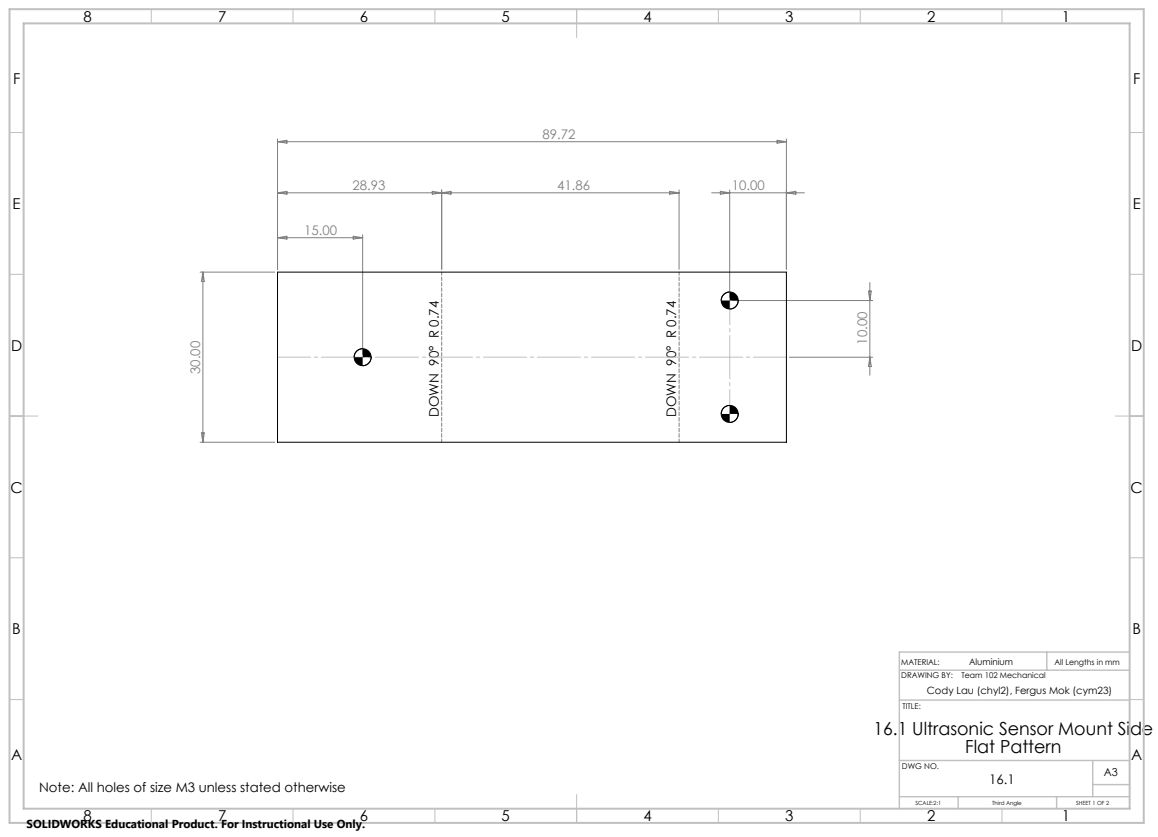
[picture p127: page 31]
DOWN 90° R 0.74; MATERIAL:; All Lengths in mm; DWG NO.; Flat Pattern

DRAWING BY: Team 102 Mechanical
Cody Lau (chyl2), Fergus Mok (cym23)
TITLE:
16.1 Ultrasonic Sensor Mount Side

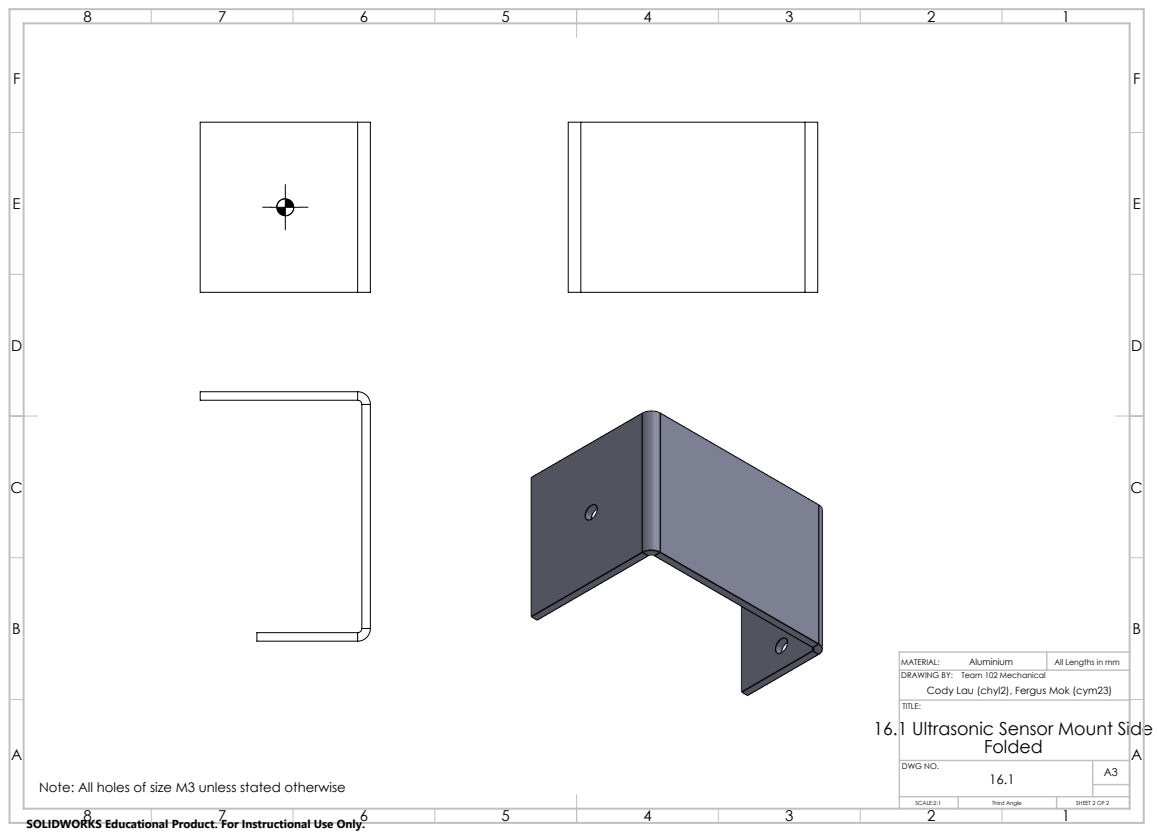
[picture p128: page 32]
MATERIAL:; All Lengths in mm; DWG NO.

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

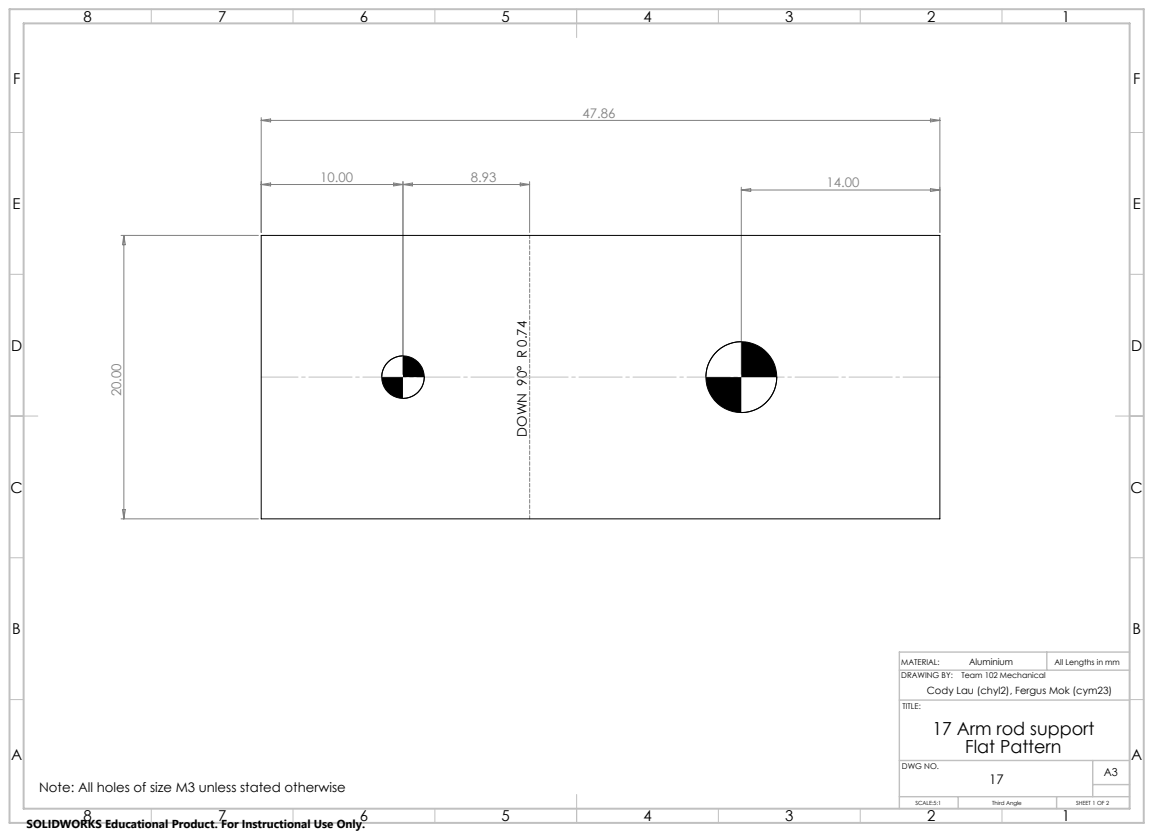
[picture p129: page 33]
14.00 8.93 DOWN 90° R 0.74; MATERIAL:; All Lengths in mm

DRAWING BY: Team 102 Mechanical
Cody Lau (chyl2), Fergus Mok (cym23)
TITLE:
17 Arm rod support
Flat Pattern

DWG NO.

SCALE:5:1 | SHEET 1 OF 2

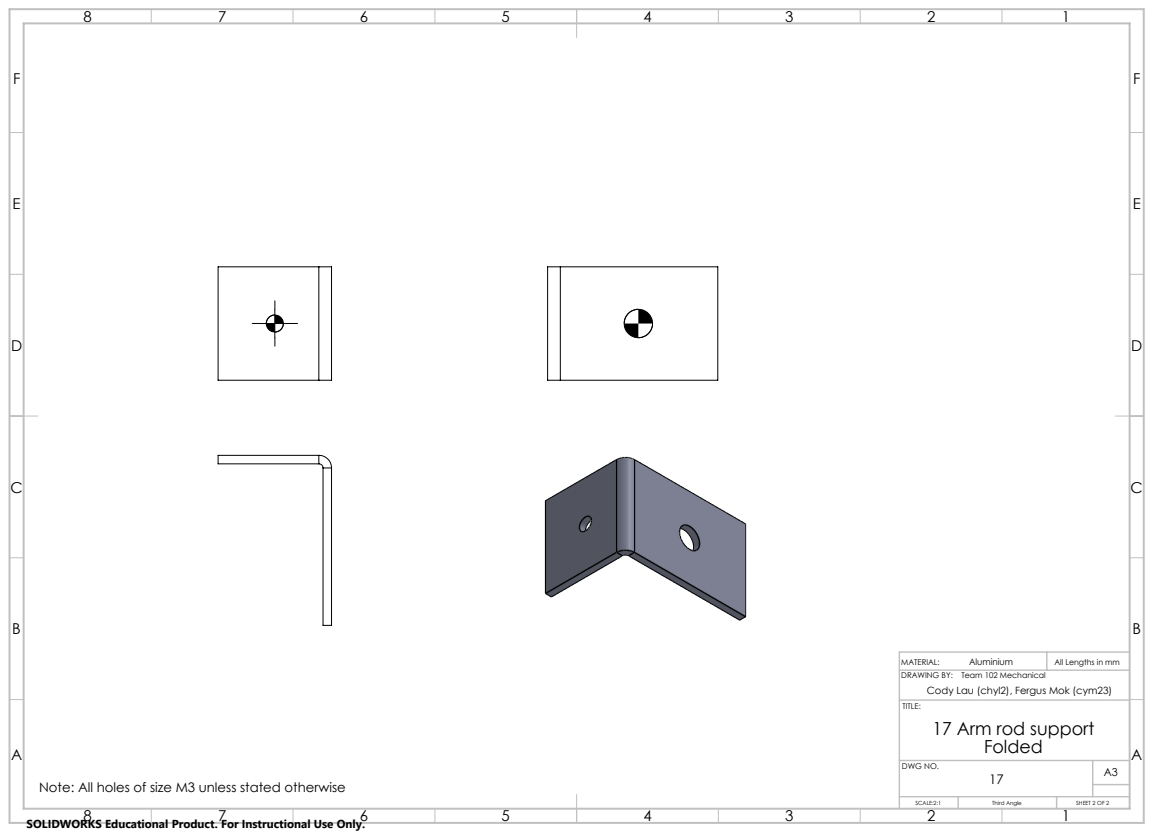
[picture p130: page 34]
MATERIAL:; All Lengths in mm; DWG NO.

DRAWING BY: Team 102 Mechanical
Cody Lau (chyl2), Fergus Mok (cym23)
TITLE:
17 Arm rod support
Folded

MATERIAL:; All Lengths in mm

ITEM NO. | PART NAME | DWG. No. | QTY.
1 | wall | 18.1 | 1
2 | wall L plate | 18.2 | 1
3 | divider | 18.3 | 1

1.5mm Aluminium
18 wall assembly left

DRAWING BY: Team 102 Mechanical
Cody Lau (chyl2), Fergus Mok (cym23)
TITLE:

DWG NO.

SCALE:1:1 | SHEET 1 OF 1

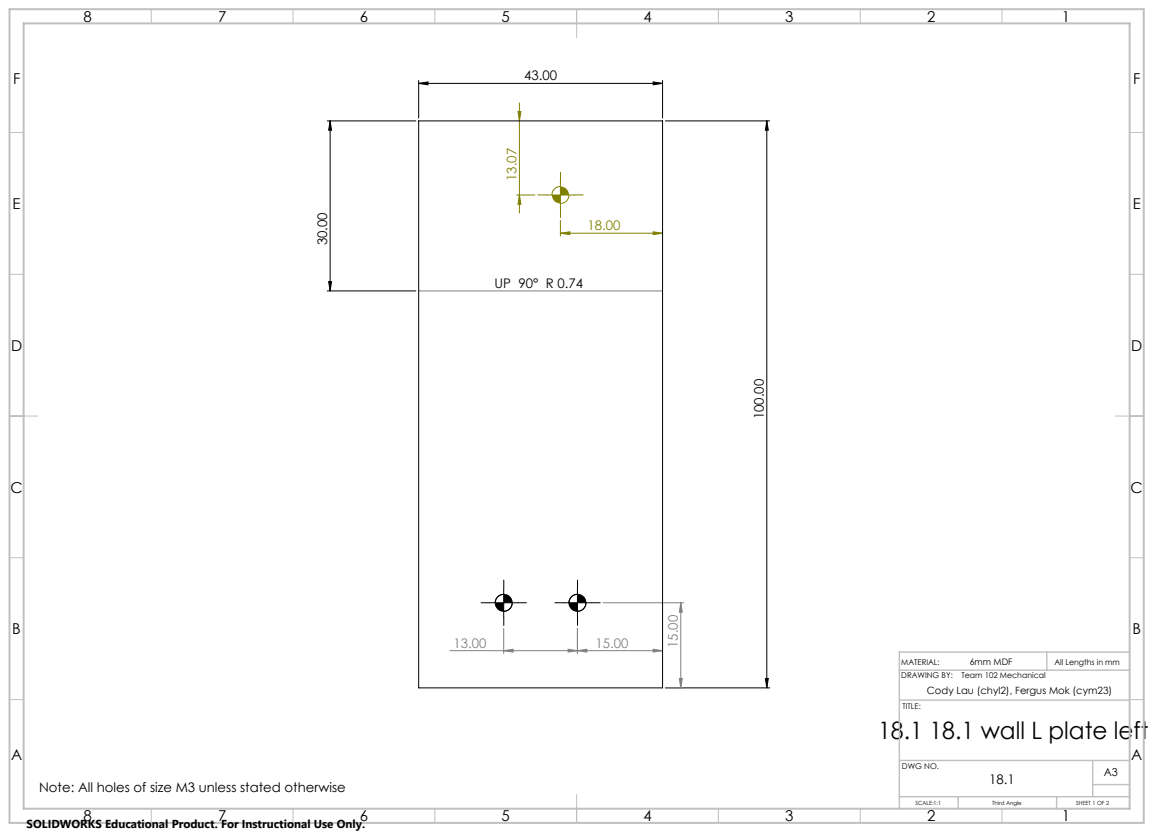
[picture p131: page 36]
MATERIAL:; All Lengths in mm

6mm MDF
18.1 18.1 wall L plate left

DRAWING BY: Team 102 Mechanical
Cody Lau (chyl2), Fergus Mok (cym23)
TITLE:

DWG NO.

SCALE:1:1 | SHEET 1 OF 2

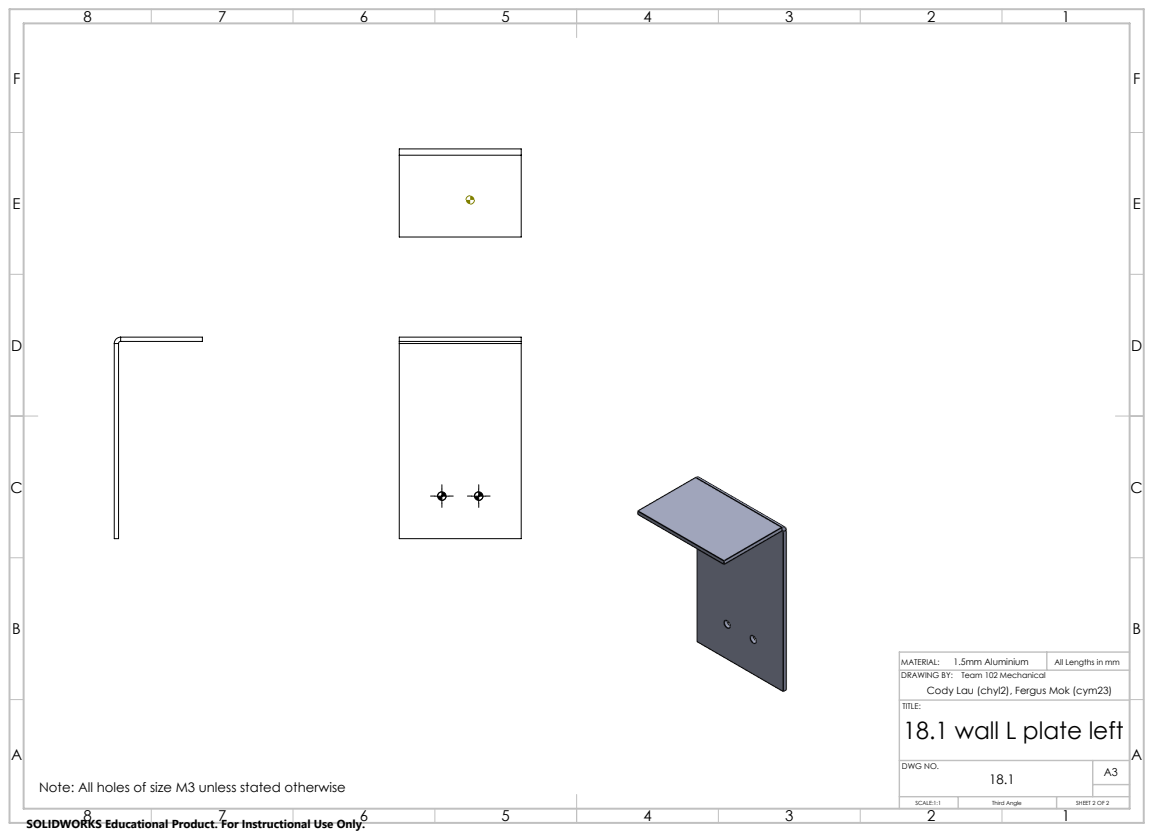
[picture p132: page 37]
MATERIAL:; All Lengths in mm

1.5mm Aluminium
18.1 wall L plate left

DRAWING BY: Team 102 Mechanical
Cody Lau (chyl2), Fergus Mok (cym23)
TITLE:

DWG NO.

SCALE:1:1 | SHEET 2 OF 2

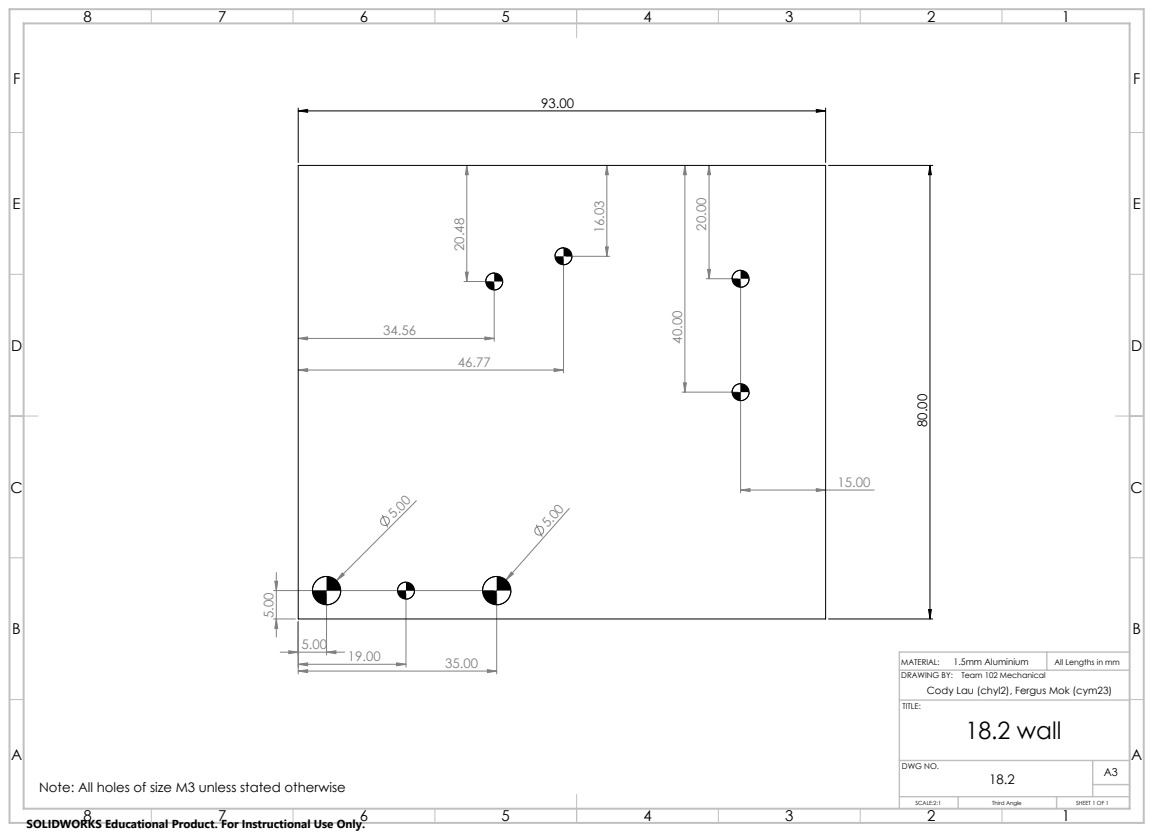
[picture p133: page 38]
MATERIAL:; All Lengths in mm; DWG NO.; 1.5mm Aluminium; 18.2 wall

DRAWING BY: Team 102 Mechanical
Cody Lau (chyl2), Fergus Mok (cym23)
TITLE:

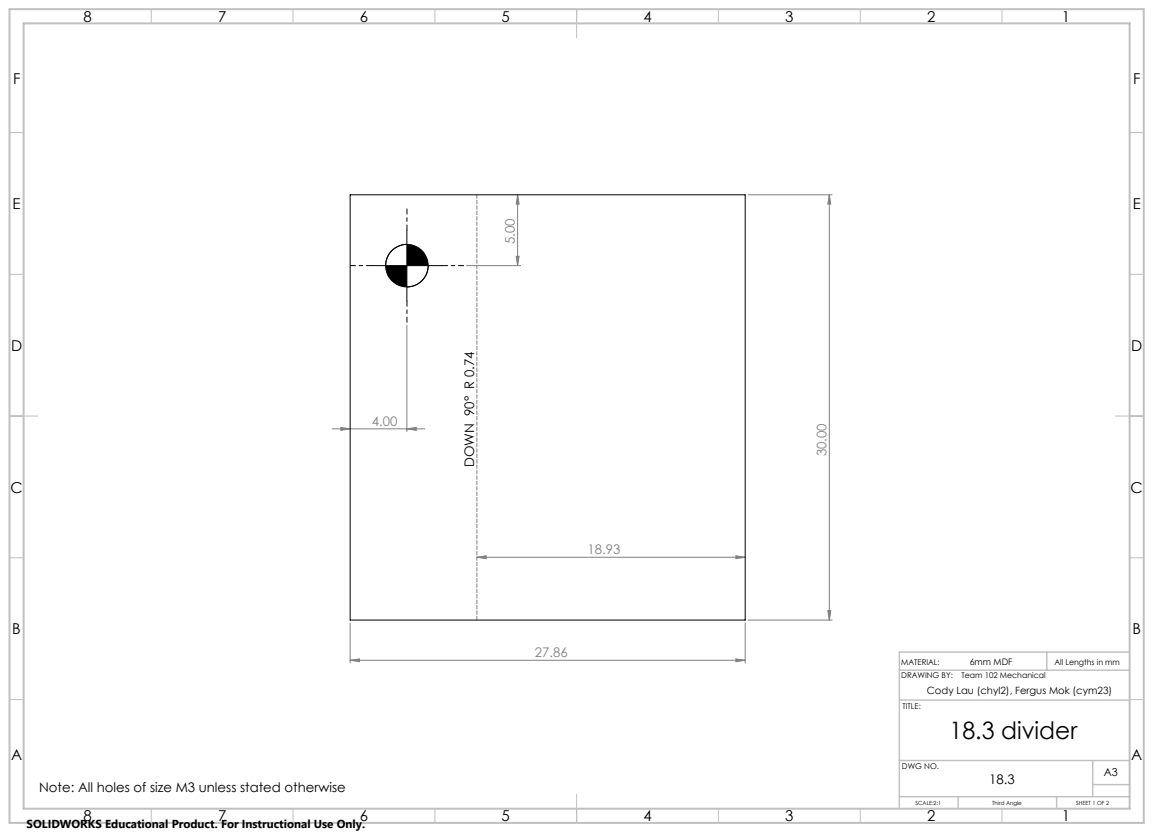
[picture p134: page 39]
DOWN 90° R 0.74; MATERIAL:; All Lengths in mm; DWG NO.; 6mm MDF; 18.3 divider

DRAWING BY: Team 102 Mechanical
Cody Lau (chyl2), Fergus Mok (cym23)
TITLE:

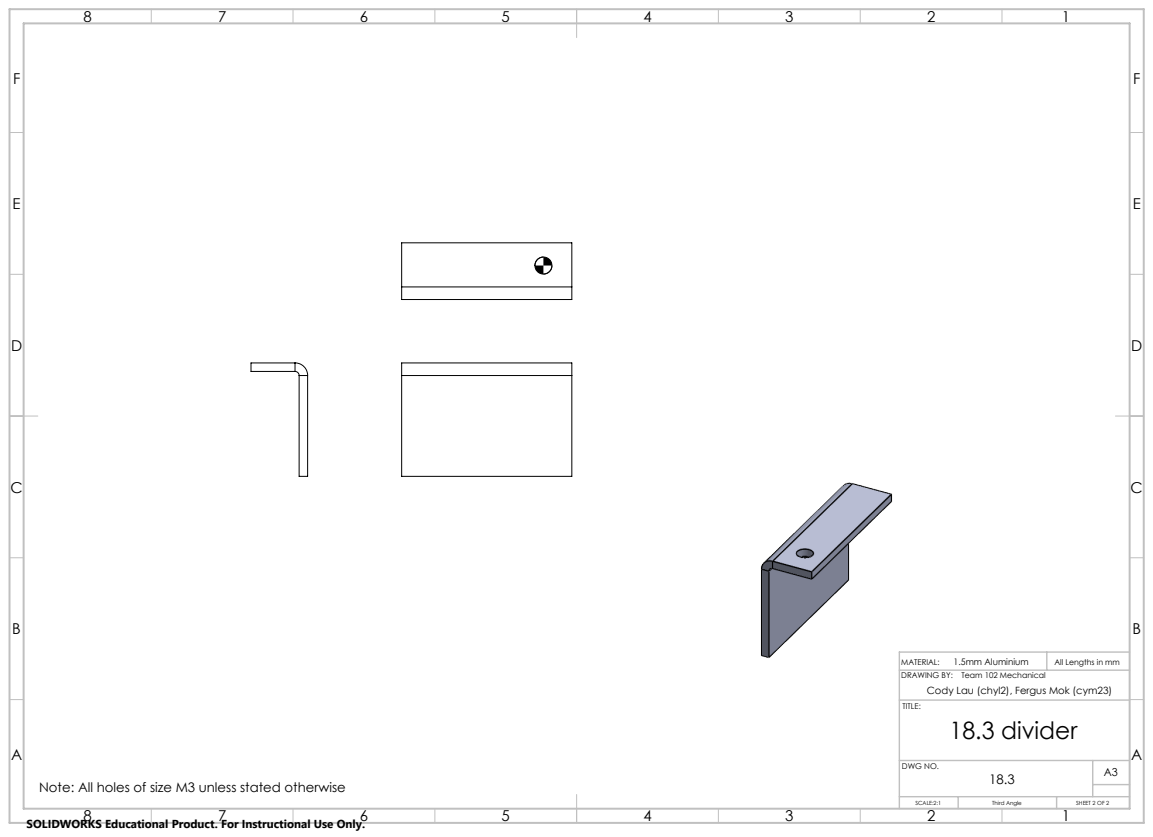
[picture p135: page 40]
MATERIAL:; All Lengths in mm; DWG NO.; 1.5mm Aluminium; 18.3 divider

DRAWING BY: Team 102 Mechanical
Cody Lau (chyl2), Fergus Mok (cym23)
TITLE:

MATERIAL:; All Lengths in mm

ITEM NO. | PART NAME | DWG. NO. | QTY.
1 | wall | 18.2 | 1
2 | wall L plate | 18.1 | 1
3 | divider | 18.3 | 1

1.5mm Aluminium
19 wall assembly right

DRAWING BY: Team 102 Mechanical
Cody Lau (chyl2), Fergus Mok (cym23)
TITLE:

DWG NO.

SCALE:1:1 | SHEET 1 OF 1

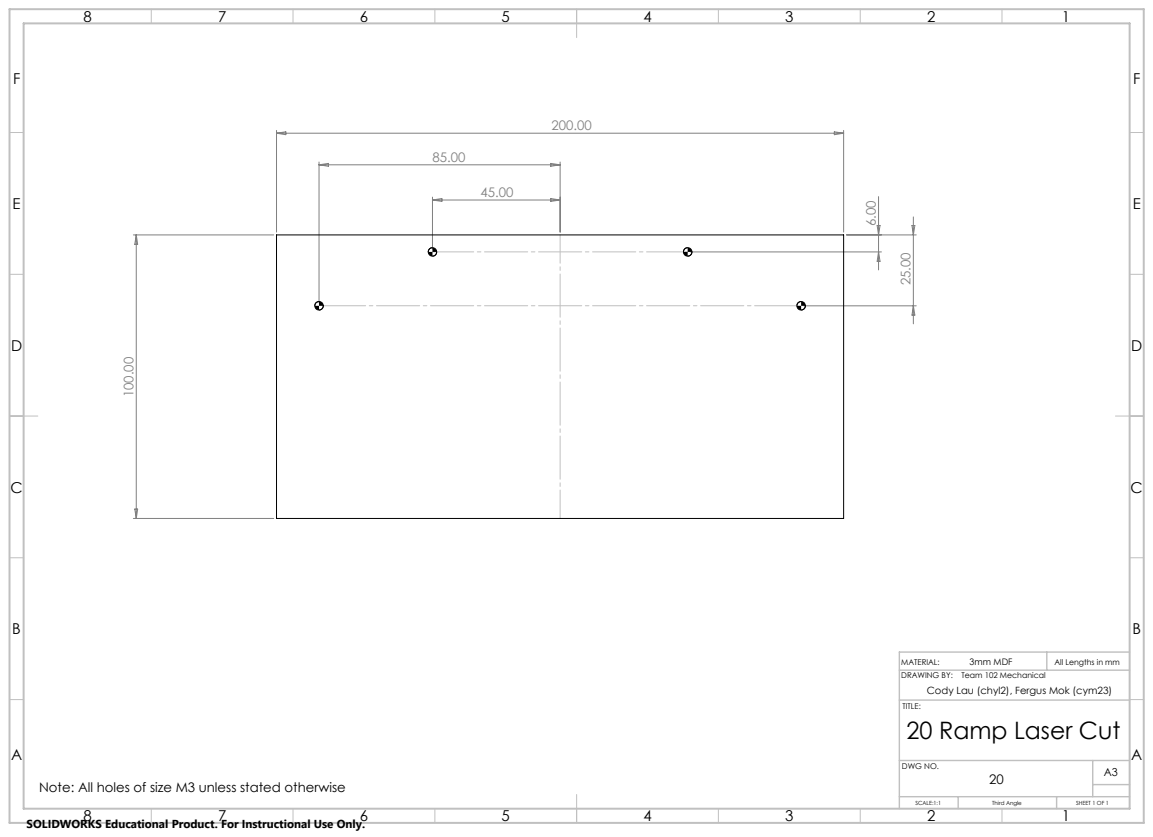
[picture p136: page 42]
MATERIAL:; All Lengths in mm

3mm MDF
20 Ramp Laser Cut

DRAWING BY: Team 102 Mechanical
Cody Lau (chyl2), Fergus Mok (cym23)
TITLE:

DWG NO.

SCALE:1:1 | SHEET 1 OF 1

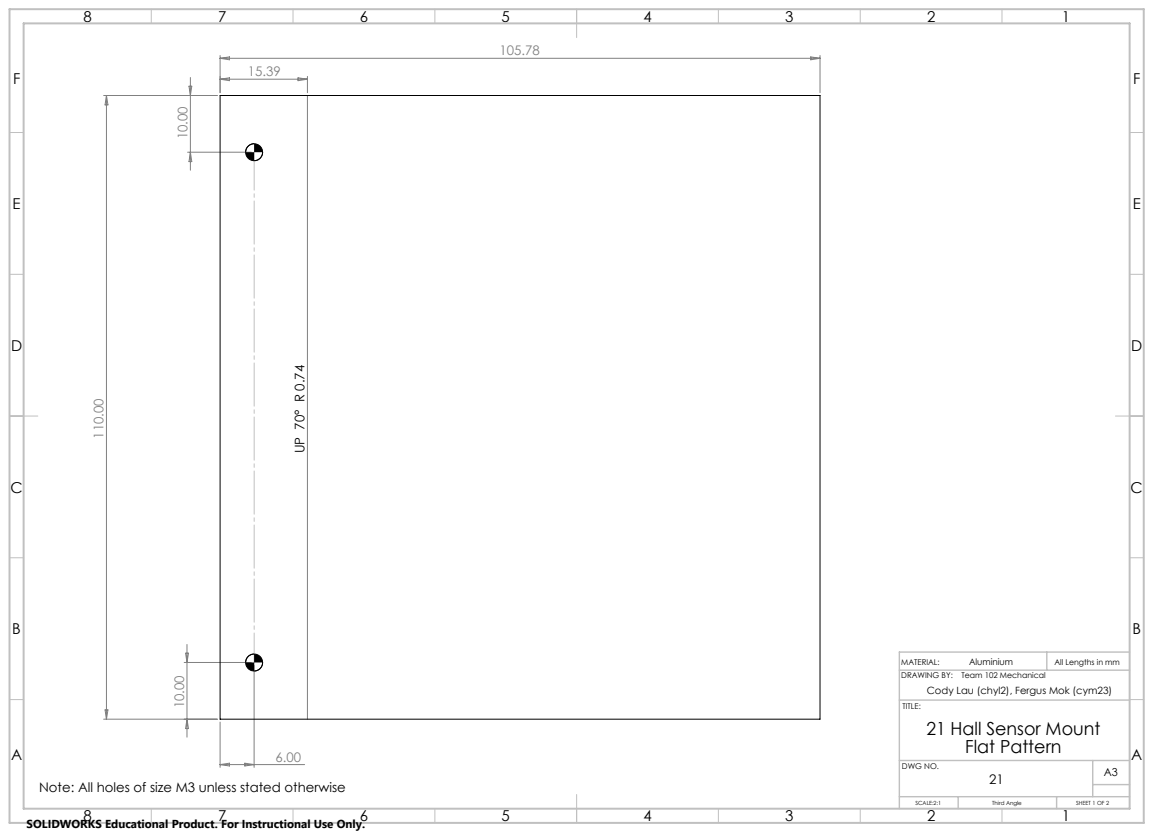
[picture p137: page 43]
MATERIAL:; All Lengths in mm; DWG NO.

DRAWING BY: Team 102 Mechanical
Cody Lau (chyl2), Fergus Mok (cym23)
TITLE:
21 Hall Sensor Mount
Flat Pattern

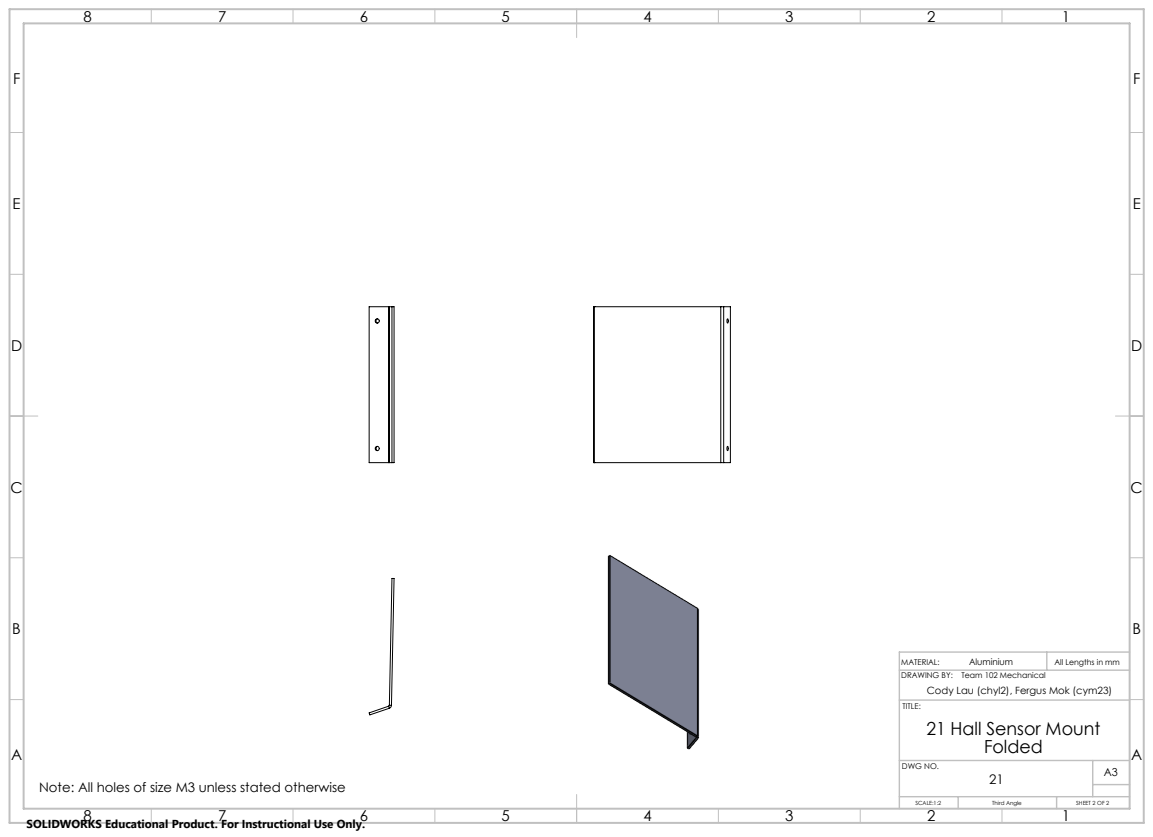
[picture p138: page 44]
MATERIAL:; All Lengths in mm

DRAWING BY: Team 102 Mechanical
Cody Lau (chyl2), Fergus Mok (cym23)
TITLE:
21 Hall Sensor Mount
Folded

DWG NO.

SCALE:1:2 | SHEET 2 OF 2
