codyhylau/Integrated-Design-Project/IDP CADS FINAL/Drawings temporary/PDFs/11.1 arm main plate.PDF

MATERIAL:; All Lengths in mm; DWG NO.; SCALE:2:1; SHEET 1 OF 1; Third Angle

Steel
11.1 arm main plate

DRAWING BY: Team 102 Mechanical
Cody Lau (chyl2), Fergus Mok (cym23)
TITLE:

Note: All holes of size M3 unless stated otherwise
SOLIDWORKS Educational Product. For Instructional Use Only.
