codyhylau/Integrated-Design-Project/IDP CADS FINAL/Drawings temporary/PDFs/12.1 Curve.PDF

MATERIAL:; All Lengths in mm; DWG NO.; SCALE:1:1; SHEET 1 OF 2; 12.1 Curve Flat Pattern; Third Angle

DRAWING BY: Team 102 Mechanical
Cody Lau (chyl2), Fergus Mok (cym23)
TITLE:

Note: All holes of size M3 unless stated otherwise
SOLIDWORKS Educational Product. For Instructional Use Only.

MATERIAL:; All Lengths in mm; DWG NO.; SCALE:1:2; SHEET 2 OF 2; 12.1 Curve; Third Angle

DRAWING BY: Team 102 Mechanical
Cody Lau (chyl2), Fergus Mok (cym23)
TITLE:

Note: All holes of size M3 unless stated otherwise
SOLIDWORKS Educational Product. For Instructional Use Only.
