codyhylau/Integrated-Design-Project/IDP CADS FINAL/Drawings temporary/PDFs/12.2 Curve L.PDF

DOWN 90° R 0.74; MATERIAL:; All Lengths in mm; DWG NO.; SCALE:2:1; SHEET 1 OF 2; 12.2 Curve L Flat Pattern; Third Angle

DRAWING BY: Team 102 Mechanical
Cody Lau (chyl2), Fergus Mok (cym23)
TITLE:

Note: All holes of size M3 unless stated otherwise
SOLIDWORKS Educational Product. For Instructional Use Only.

MATERIAL:; All Lengths in mm; DWG NO.; SCALE:1:1; SHEET 2 OF 2; 12.2 Curve L; Third Angle

DRAWING BY: Team 102 Mechanical
Cody Lau (chyl2), Fergus Mok (cym23)
TITLE:

Note: All holes of size M3 unless stated otherwise
SOLIDWORKS Educational Product. For Instructional Use Only.
