codyhylau/Integrated-Design-Project/IDP CADS FINAL/Drawings temporary/PDFs/13 LED Panel.PDF

MATERIAL:; All Lengths in mm; DWG NO.; SCALE:2:1; SHEET 1 OF 1; 3mm MDF; Third Angle

Note: All holes of size M3 unless stated otherwise

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

SOLIDWORKS Educational Product. For Instructional Use Only.
