codyhylau/Integrated-Design-Project/IDP CADS FINAL/Drawings temporary/PDFs/15.1 Ultrasonic Sensor Mount Back.PDF

MATERIAL:; All Lengths in mm; DWG NO.; SCALE:1:1; SHEET 1 OF 2; Flat Pattern; Third Angle

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

Note: All holes of size M3 unless stated otherwise
SOLIDWORKS Educational Product. For Instructional Use Only.

MATERIAL:; All Lengths in mm; DWG NO.; SCALE:1:1; SHEET 2 OF 2; Third Angle

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

Note: All holes of size M3 unless stated otherwise
SOLIDWORKS Educational Product. For Instructional Use Only.
