codyhylau/Integrated-Design-Project/IDP CADS FINAL/Drawings temporary/PDFs/17 Arm rod support.PDF

14.00 8.93 DOWN 90° R 0.74; MATERIAL:; All Lengths in mm; DWG NO.; SCALE:5:1; SHEET 1 OF 2; Third Angle

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

Note: All holes of size M3 unless stated otherwise
SOLIDWORKS Educational Product. For Instructional Use Only.

MATERIAL:; All Lengths in mm; DWG NO.; SCALE:2:1; SHEET 2 OF 2; Third Angle

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

Note: All holes of size M3 unless stated otherwise
SOLIDWORKS Educational Product. For Instructional Use Only.
