codyhylau/Integrated-Design-Project/IDP CADS FINAL/Drawings temporary/PDFs/18.1 wall L plate left.PDF

MATERIAL:; All Lengths in mm; DWG NO.; SCALE:1:1; SHEET 1 OF 2; Third Angle

6mm MDF
18.1 18.1 wall L plate left

DRAWING BY: Team 102 Mechanical
Cody Lau (chyl2), Fergus Mok (cym23)
TITLE:

Note: All holes of size M3 unless stated otherwise
SOLIDWORKS Educational Product. For Instructional Use Only.

MATERIAL:; All Lengths in mm; DWG NO.; SCALE:1:1; SHEET 2 OF 2; Third Angle

1.5mm Aluminium
18.1 wall L plate left

DRAWING BY: Team 102 Mechanical
Cody Lau (chyl2), Fergus Mok (cym23)
TITLE:

Note: All holes of size M3 unless stated otherwise
SOLIDWORKS Educational Product. For Instructional Use Only.
