codyhylau/Integrated-Design-Project/IDP CADS FINAL/Drawings temporary/PDFs/18.2 wall.PDF

MATERIAL:; All Lengths in mm; DWG NO.; SCALE:2:1; SHEET 1 OF 1; 1.5mm Aluminium; 18.2 wall; Third Angle

DRAWING BY: Team 102 Mechanical
Cody Lau (chyl2), Fergus Mok (cym23)
TITLE:

Note: All holes of size M3 unless stated otherwise
SOLIDWORKS Educational Product. For Instructional Use Only.
