codyhylau/Integrated-Design-Project/IDP CADS FINAL/Drawings temporary/PDFs/3 Ball Castor Mount Right.PDF

MATERIAL:; All Lengths in mm; DWG NO.; SCALE:2:1; SHEET 1 OF 2; Third Angle

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

Note: All holes of size M3 unless otherwise stated

SOLIDWORKS Educational Product. For Instructional Use Only.

MATERIAL:; All Lengths in mm; DWG NO.; SCALE:1:1; SHEET 2 OF 2; 1.5mm Aluminium; Third Angle

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

SOLIDWORKS Educational Product. For Instructional Use Only.
